spiricom/Electrosteel_embedded/README.md

# Electrosteel_embedded
repository for embedded firmware and EAGLE design files for the Electrosteel
