spiricom/Electrosteel_embedded/EAGLE_files/electrosteel_2020/electrosteel_knobpanel/electrosteel2021_synthboards1_BOM.xlsx

electrosteel2021_synthboards1_GenericPartsOrder
Mfg Part Num | Mfg Name | VID | Vendor Part Num | Description | Pkg Code | Qty-1 | Qty-5 | Qty-25 | Part References | Value
77313-101-30LF | Amphenol | DK | 609-77313-101-30LF-ND | CONN HEADER VERT 30POS 2.54MM | TH | 3 | 15 | 75 | JP9, JP10, JP11
FBMH1608HM470-TV | Taiyo Yuden | DK | 587-3824-2-ND | FERRITE BEAD 47 OHM 0603 1LN | 603 | 2 | 10 | 50 | L1, L2
L79L12ACZ-TR | ST | DK | 497-7302-2-ND | IC REG LINEAR -12V 100MA TO92-3 | TO92-3 | 1 | 5 | 25 | IC6
LM78L12ACZ/LFT7 | TI | DK | 296-LM78L12ACZ/LFT7TR-ND | IC REG LINEAR 12V 100MA TO92-3 | TO92-3 | 1 | 5 | 25 | IC5
CC0603KRX7R8BB104 | Yageo | DK | 311-1341-1-ND | CAP CER 0.1UF 25V 10% X7R 0603 | 603 | 15 | 75 | 375 | C1, C2, C5, C6, C7, C8, C9, C10, C11, C12, C13, C18, C19, C23, C164 | .1uf
CC0603KRX7R8BB103 | Yageo | DK | 311-1360-1-ND | CAP CER 10000PF 25V 10% X7R 0603 | 603 | 20 | 100 | 500 | C3, C4, C14, C15, C16, C17, C20, C21, C22, C24, C25, C26, C27, C51, C52, C53, C54, C119, C120, C121 | .01uf
RCS06030000Z0EA | Vishay | DK | 541-2779-1-ND | RES SMD 0 OHM JUMPER 1/4W 0603 | 603 | 4 | 20 | 100 | R4, R110, R111, R185 | 0R
ESR03EZPF1001 | Rohm | DK | RHM1.00KADCT-ND | RES 1K OHM 1/4W 1% 0603 SMD | 603 | 2 | 10 | 50 | R125, R134 | 1k
C3216X7R1E105K085AA | TDK | DK | 445-1592-1-ND | CAP CER 1UF 25V 10% X7R 1206 | 1206 | 1 | 5 | 25 | C162 | 1uf
*DNP | DO NOT PLACE | (N/A) | DO NOT PLACE | DO NOT PLACE | * | 2 | 10 | 50 | R1, R2 | 2.2k-DNP
CRCW06034K70FKEAHP | Vishay Dale | DK | 541-4.70KSCT-ND | RES 4.70K OHM .25W 1% 0603 SMD | 603 | 1 | 5 | 25 | R128 | 4.7k
*DNP | DO NOT PLACE | (N/A) | DO NOT PLACE | DO NOT PLACE | * | 5 | 25 | 125 | J1, J2, J3, J4, J36 | 4P-2.0
RC0603JR-075R1L | Yageo | DK | 311-5.1GRCT-ND | RES SMD 5.1 OHM 5% 1/10W 0603 | 603 | 1 | 5 | 25 | R3 | 5R
ERJ-3EKF7151V | Panasonic | DK | P7.15KHTR-ND | RES SMD 7.15K OHM 1% 1/10W 0603 | 603 | 2 | 10 | 50 | R5, R35 | 7.15k
*DNP | DO NOT PLACE | (N/A) | DO NOT PLACE | DO NOT PLACE | * | 8 | 40 | 200 | VR1, VR2, VR3, VR4, VR5, VR6, VR7, VR8 | 10k
ESR03EZPF1002 | Rohm | DK | RHM10KADCT-ND | RES 10K OHM 1/4W 1% 0603 SMD | 603 | 8 | 40 | 200 | R33, R34, R37, R38, R159, R160, R161, R162 | 10k
TAJB106K025RNJ | AVX | DK | 478-5257-1-ND | 10µF ±10% Molded Tantalum Capacitors 25V | 1210 | 1 | 5 | 25 | C44 | 10uf
CC0603JRNPO9BN220 | Yageo | DK | 311-1062-1-ND | CAP CER 22PF 50V 5% NPO 0603 | 603 | 1 | 5 | 25 | C28 | 22pf
EEE-1CA220NP | Panasonic | DK | PCE4306CT-ND | CAP ALUM 22UF 20% 16V SMD Bipolar | PANASONIC_C | 1 | 5 | 25 | C158 | 22uf
RC0603JR-0739RL | Yageo | DK | 311-39GRCT-ND | RES SMD 39 OHM 5% 1/10W 0603 | 603 | 3 | 15 | 75 | R112, R208, R209 | 39R
ESR03EZPJ473 | Rohm | DK | RHM47KDCT-ND | RES 47K OHM 1/4W 5% 0603 SMD | 603 | 1 | 5 | 25 | R11 | 47k
ESR03EZPF5600 | Rohm | DK | RHM560ADCT-ND | RES 560 OHM 1/4W 1% 0603 SMD | 603 | 2 | 10 | 50 | R10, R129 | 560R
D2516-6002-AR | 3M | DK | MHC16E-ND | CONN HEADER VERT 16POS 2.54MM | TH | 1 | 5 | 25 | X7 | -2516
N2520-6003-UG | 3M | DK | N2520-6003-UG-ND | CONN HEADER VERT 20POS 2.54MM | TH | 1 | 5 | 25 | X6 | -2520
PRT-08032 | Generic | Sparkfun | PRT-08032 | Audio Jack 3.5mm stereo | TH | 3 | 15 | 75 | FB_IN, MONO_OUT, STEREO_OUT | AUDIO_JACK_3.5MM_KIT
DPU01M-15 | MeanWell | DK | 1866-1412-ND | DC DC CONVERTER +/-15V 1W | 7-SIP | 1 | 5 | 25 | U$3 | CMR0512S3C
HSMM-A101-R00J1 | Broadcom | DK | 516-2124-1-ND | LED GREEN CLEAR 2PLCC SMD | 2PLCC | 1 | 5 | 25 | LED5 | GREEN
MAX11617EEE+ | Maxim | MO | 700-MAX11617EEE | Analog to Digital Converters - ADC 2.7V to 3.6V and 4.5V to 5.5V Low-Power 4-/8-/12-Channel 2-Wire Serial 12-Bit ADCs | QSOP-16 | 1 | 5 | 25 | U1 | MAX11615EEE+
TL1105SPF160Q | E-Switch | DK | EG1861-ND | SWITCH TACTILE SPST-NO 0.05A 12V | TH | 2 | 10 | 50 | S1, S2 | MOMENTARY-SWITCH-SPST-PTH-6.0MM
OPA1664AIPWR | TI | DK | 296-40431-2-ND | IC AUDIO 4 CIRCUIT 14TSSOP | 14TSSOP | 1 | 5 | 25 | IC1 | OPA4344E
*DNP | DO NOT PLACE | (N/A) | DO NOT PLACE | DO NOT PLACE | * | 18 | 90 | 450 | +12VA, +15VA, -12VA, -15VA, 3V3A_0A, 3V3A_0B, 3V3A_0C, 5V/1, 5V/1_2, 5V/2, 5V/2_2, 5V/3, DGND1, DGND2, DGND5, MONO_OUT_DC, VREGGND, VREGIN | PINHD-1X1
*DNP | DO NOT PLACE | (N/A) | DO NOT PLACE | DO NOT PLACE | * | 6 | 30 | 150 | JP14, JP22, JP23, JP24, JP25, JP26 | PINHD-1X2
*DNP | DO NOT PLACE | (N/A) | DO NOT PLACE | DO NOT PLACE | * | 1 | 5 | 25 | JP27 | PINHD-1X3
*DNP | DO NOT PLACE | (N/A) | DO NOT PLACE | DO NOT PLACE | * | 11 | 55 | 275 | JP1, JP2, JP12, JP13, JP15, JP16, JP17, JP18, JP19, JP20, JP21 | PINHD-1X4
77313-101-08LF | Amphenol | DK | 609-5693-ND | CONN HEADER VERT 8POS 2.54MM | TH | 3 | 15 | 75 | JP3, JP4, JP5 | PINHD-2X4
77313-101-20LF | Amphenol | DK | 609-5697-ND | CONN HEADER VERT 20POS 2.54MM | TH | 3 | 15 | 75 | JP6, JP7, JP8 | PINHD-2X10
R-78E5.0-1.0 | Recom | DK | 945-2201-ND | 5V Switching Regulator | TH | 3 | 15 | 75 | U2, U15, U17 | R-78E5.0-1.0
HSMZ-A100-R00J1 | Broadcom | DK | 516-1459-1-ND | LED RED CLEAR 2PLCC SMD | 2PLCC | 1 | 5 | 25 | LED6 | RED
TCA9548APWR | Texas Instruments | DK | 296-34905-1-ND | IC I2C SW 8CH W/RESET 24TSSOP | 24TSSOP | 1 | 5 | 25 | U20 | TCA9548APWR
