spiricom/Electrosteel_embedded/PSOC5_electrosteel_stringsensors_newpcb_brain/CE210514_PSOC3_5_Thermistor.cydsn/ComponentUpdateLog.txt

Last Modified Date & Time: 07/15/2018 13:28:18

CE210514_PSOC3_5_Thermistor: CE210514_PSOC3_5_Thermistor.cydwr
	cy_boot [v5.20] to [v5.70]
	Em_EEPROM_Dynamic [v2.0] to [v2.10]
	LIN_Dynamic [v3.20] to [v4.0]

CE210514_PSOC3_5_Thermistor: TopDesign.cysch
	ADC [v3.20] to [v3.30]
	LCD [v2.10] to [v2.20]
	TX [v2.10] to [v2.20]
	Vhi [v2.10] to [v2.20]
	Vlow [v2.10] to [v2.20]
	Vtherm [v2.10] to [v2.20]

Last Modified Date & Time: 02/27/2021 19:00:18

CE210514_PSOC3_5_Thermistor: CE210514_PSOC3_5_Thermistor.cydwr
	cy_boot [v5.70] to [v6.10]
	Em_EEPROM_Dynamic [v2.10] to [v2.20]
	LIN_Dynamic [v4.0] to [v5.0]

CE210514_PSOC3_5_Thermistor: TopDesign.cysch
	isr_SPI1_DMA [v1.70] to [v1.71]
	isr_SPI2_DMA [v1.70] to [v1.71]
	isr_SPI2_ss [v1.70] to [v1.71]
	my_Vbus_ISR [v1.70] to [v1.71]
	Sleep_isr [v1.70] to [v1.71]

Last Modified Date & Time: 04/28/2023 11:42:35

CE210514_PSOC3_5_Thermistor: CE210514_PSOC3_5_Thermistor.cydwr
	LIN_Dynamic [v5.0] to [v6.0]
