spiricom/Electrosteel_embedded/EAGLE_files/electrosteel_2020/electrosteel2020_10_arrange6_newstringconnector_2 (v9~recovered).dxf

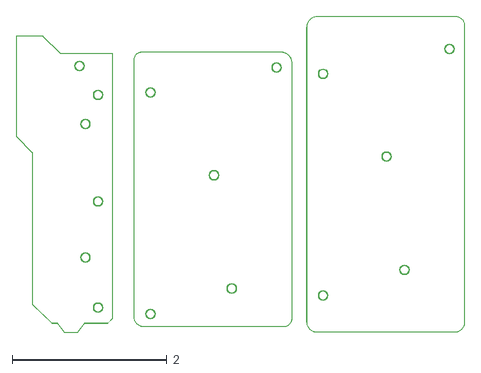
[picture p1: CAD file, 2023-07-19]
EAGLE_files/electrosteel_2020/electrosteel2020_10_arrange6_newstringconnector_2 (v9~recovered).dxf
5.79 x 4.09
