spiricom/Electrosteel_embedded/EAGLE_files/electrosteel_2020/electrosteel_6board_synth/EAGLE/electrosteel2020_10_arrange6_synthboardsonlyrev6.dxf

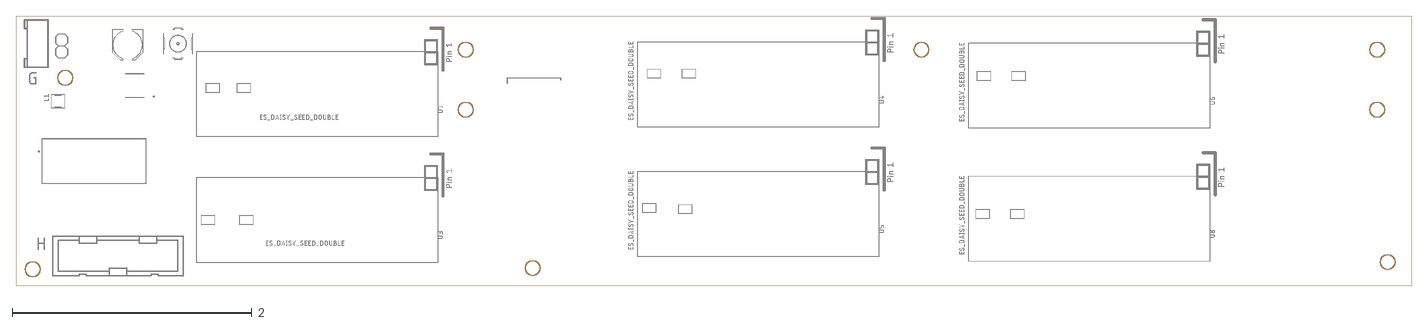
[picture p2: CAD file, 2023-10-17]
EAGLE_files/electrosteel_2020/electrosteel_6board_synth/EAGLE/electrosteel2020_10_arrange6_synthboardsonlyrev6.dxf
11.6 x 2.25
