spiricom/Electrosteel_embedded/EAGLE_files/electrosteel_2020/electrosteel_sensor/electrosteel_fretboard_sensor1_panel.dxf

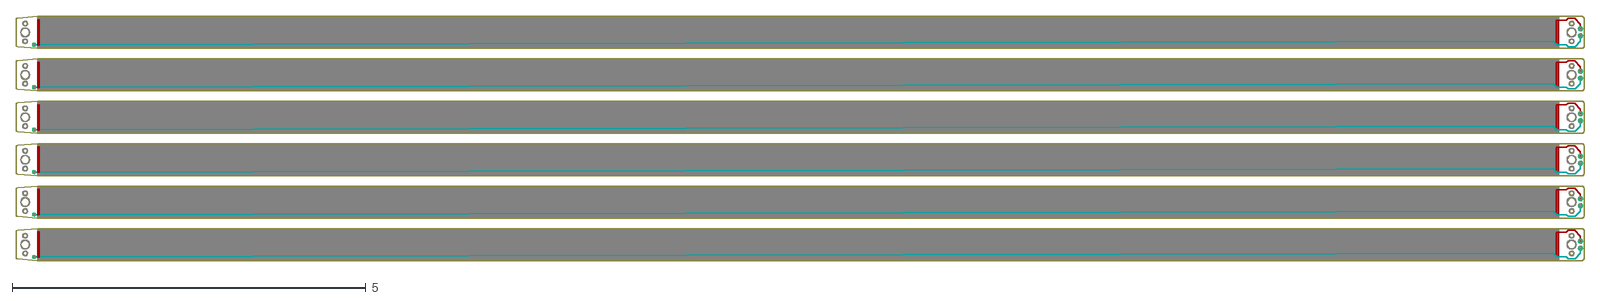
[picture p3: CAD file, 2022-12-08]
EAGLE_files/electrosteel_2020/electrosteel_sensor/electrosteel_fretboard_sensor1_panel.dxf
22.2 x 3.45
