spiricom/Electrosteel_embedded/EAGLE_files/electrosteel_2020/electrosteel2020_10_arrange6_synthboardsonly3.dxf

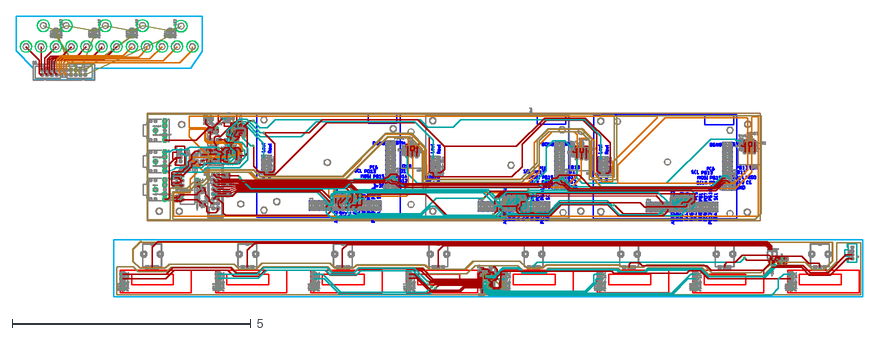
[picture p4: CAD file, 2022-12-08]
EAGLE_files/electrosteel_2020/electrosteel2020_10_arrange6_synthboardsonly3.dxf
17.8 x 5.89
