spiricom/Electrosteel_embedded/EAGLE_files/cam/NIRL/Admin Project/CAMOutputs/Assembly/PnP_electrosteel2020_10_arrange6_newstringconnector_2 v9_back.txt

C1	85.09	15.49	180.00	2.2uf	C1206
C2	87.63	9.14	90.00	2.2uf	C1206
C3	132.84	58.67	0.00	2.2uf	C1206
C4	143.00	58.93	180.00	2.2uf	C1206
U1	81.18	8.48	270.00	MC78M09BDTRKGDPAK-3_ONS-M	DPAK-3_ONS-M
U2	138.84	51.47	180.00	MC78M09BDTRKGDPAK-3_ONS-M	DPAK-3_ONS-M
