spiricom/Electrosteel_embedded/PSOC5_electrosteel_stringsensors_newpcb_brain/CE210514_PSOC3_5_Thermistor.cydsn/ARM_GCC_541/Debug/LINK_options.txt

-Wl,--start-group -o "C:\\Users\\ggg88\\dev\\Electrosteel_embedded\\PSOC5_electrosteel_stringsensors_newpcb_brain\\CE210514_PSOC3_5_Thermistor.cydsn\\ARM_GCC_541\\Debug\\CE210514_PSOC3_5_Thermistor.elf" ".\\ARM_GCC_541\\Debug\\main.o" ".\\ARM_GCC_541\\Debug\\measurement.o" ".\\ARM_GCC_541\\Debug\\removeOffsetNoise.o" ".\\ARM_GCC_541\\Debug\\gfx.o" ".\\ARM_GCC_541\\Debug\\gfx_font.o" ".\\ARM_GCC_541\\Debug\\oled.o" ".\\ARM_GCC_541\\Debug\\ssd1306.o" ".\\ARM_GCC_541\\Debug\\ui.o" ".\\ARM_GCC_541\\Debug\\cyfitter_cfg.o" ".\\ARM_GCC_541\\Debug\\cymetadata.o" ".\\ARM_GCC_541\\Debug\\Cm3Start.o" ".\\ARM_GCC_541\\Debug\\CE210514_PSOC3_5_Thermistor.a" "C:\\Program\ Files\ (x86)\\Cypress\\PSoC\ Creator\\4.4\\PSoC\ Creator\\psoc\\content\\cycomponentlibrary\\CyComponentLibrary.cylib\\CortexM3\\ARM_GCC_541\\Debug\\CyComponentLibrary.a" -mcpu=cortex-m3 -mthumb -l m -L "Generated_Source\\PSoC5" "-Wl,-Map,.\\ARM_GCC_541\\Debug/CE210514_PSOC3_5_Thermistor.map" -T "Generated_Source\\PSoC5\\cm3gcc.ld" -specs=nano.specs -Wl,--gc-sections -u_printf_float -g -ffunction-sections -O0 -ffat-lto-objects -Wl,--end-group
