spiricom/Electrosteel_embedded/PSOC5_electrosteel_stringsensors_newpcb_brain/CE210514_PSOC3_5_Thermistor.cydsn/bootloader_electrosteel_PSOC.cydsn/CortexM3/ARM_GCC_541/Debug/LINK_options.txt

-Wl,--start-group -o "C:\\Users\\JeffSnyder\\dev\\Electrosteel_embedded\\PSOC5_electrosteel_stringsensors_newpcb_brain\\CE210514_PSOC3_5_Thermistor.cydsn\\bootloader_electrosteel_PSOC.cydsn\\CortexM3\\ARM_GCC_541\\Debug\\bootloader_electrosteel_PSOC.elf" ".\\CortexM3\\ARM_GCC_541\\Debug\\main.o" ".\\CortexM3\\ARM_GCC_541\\Debug\\cyfitter_cfg.o" ".\\CortexM3\\ARM_GCC_541\\Debug\\cymetadata.o" ".\\CortexM3\\ARM_GCC_541\\Debug\\Cm3Start.o" ".\\CortexM3\\ARM_GCC_541\\Debug\\bootloader_electrosteel_PSOC.a" "C:\\Program\ Files\ (x86)\\Cypress\\PSoC\ Creator\\4.4\\PSoC\ Creator\\psoc\\content\\cycomponentlibrary\\CyComponentLibrary.cylib\\CortexM3\\ARM_GCC_541\\Debug\\CyComponentLibrary.a" -mcpu=cortex-m3 -mthumb -L "Generated_Source\\PSoC5" "-Wl,-Map,.\\CortexM3\\ARM_GCC_541\\Debug/bootloader_electrosteel_PSOC.map" -T "Generated_Source\\PSoC5\\cm3gcc.ld" -specs=nano.specs -Wl,--gc-sections -g -ffunction-sections -Og -ffat-lto-objects -Wl,--end-group
