spiricom/Electrosteel_embedded/EAGLE_files/electrosteel_2020/electrosteel2020_10_arrange6_synthboardsonly4.pdf

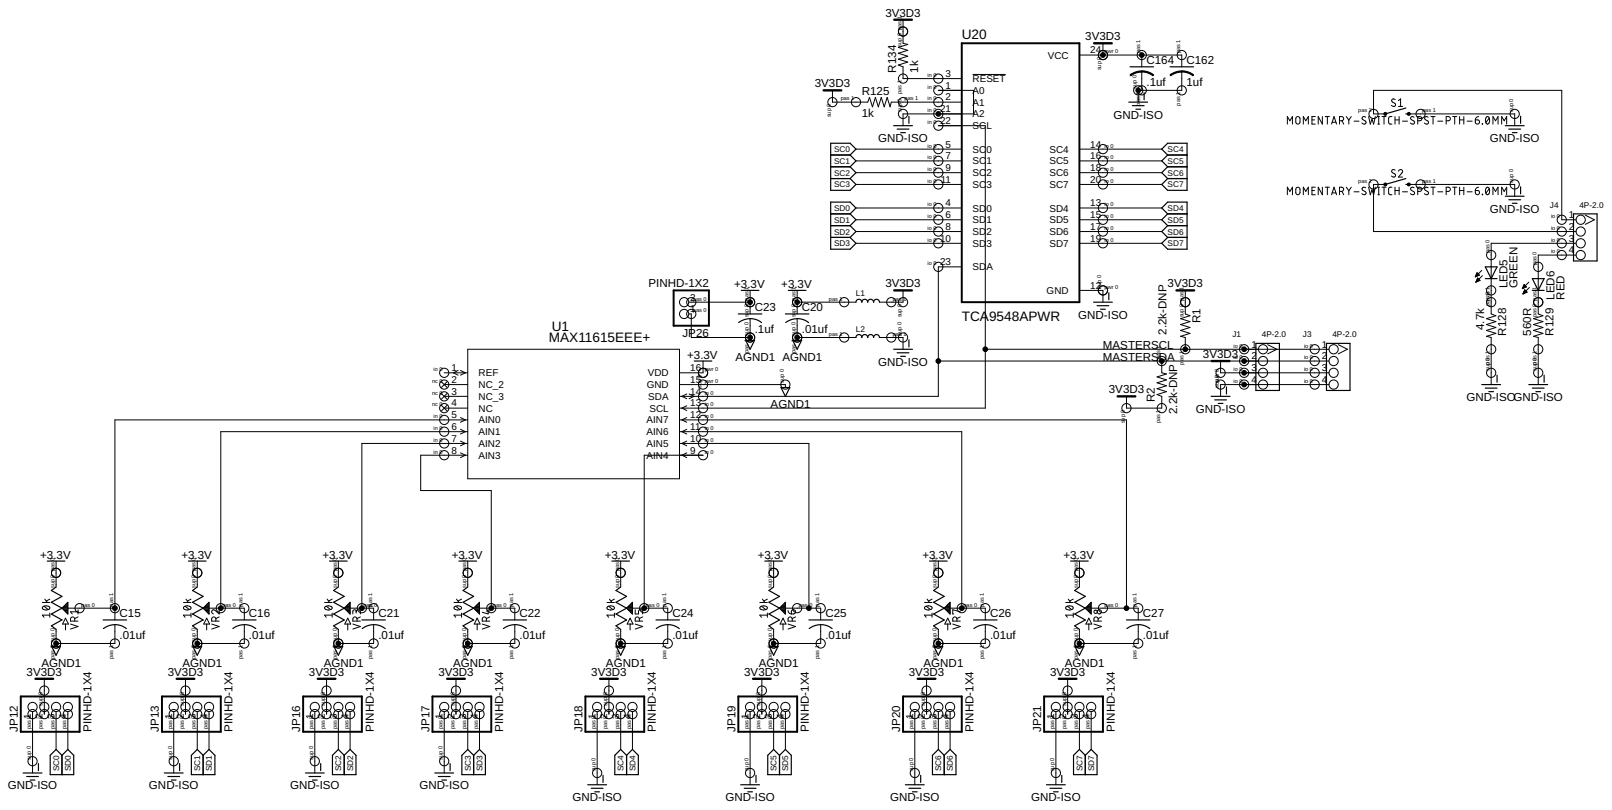
[picture p5: page 1]

pas 0 pas 0 pas 1 pas 1

in 0 | 11 AIN7 10 AIN6 in 0

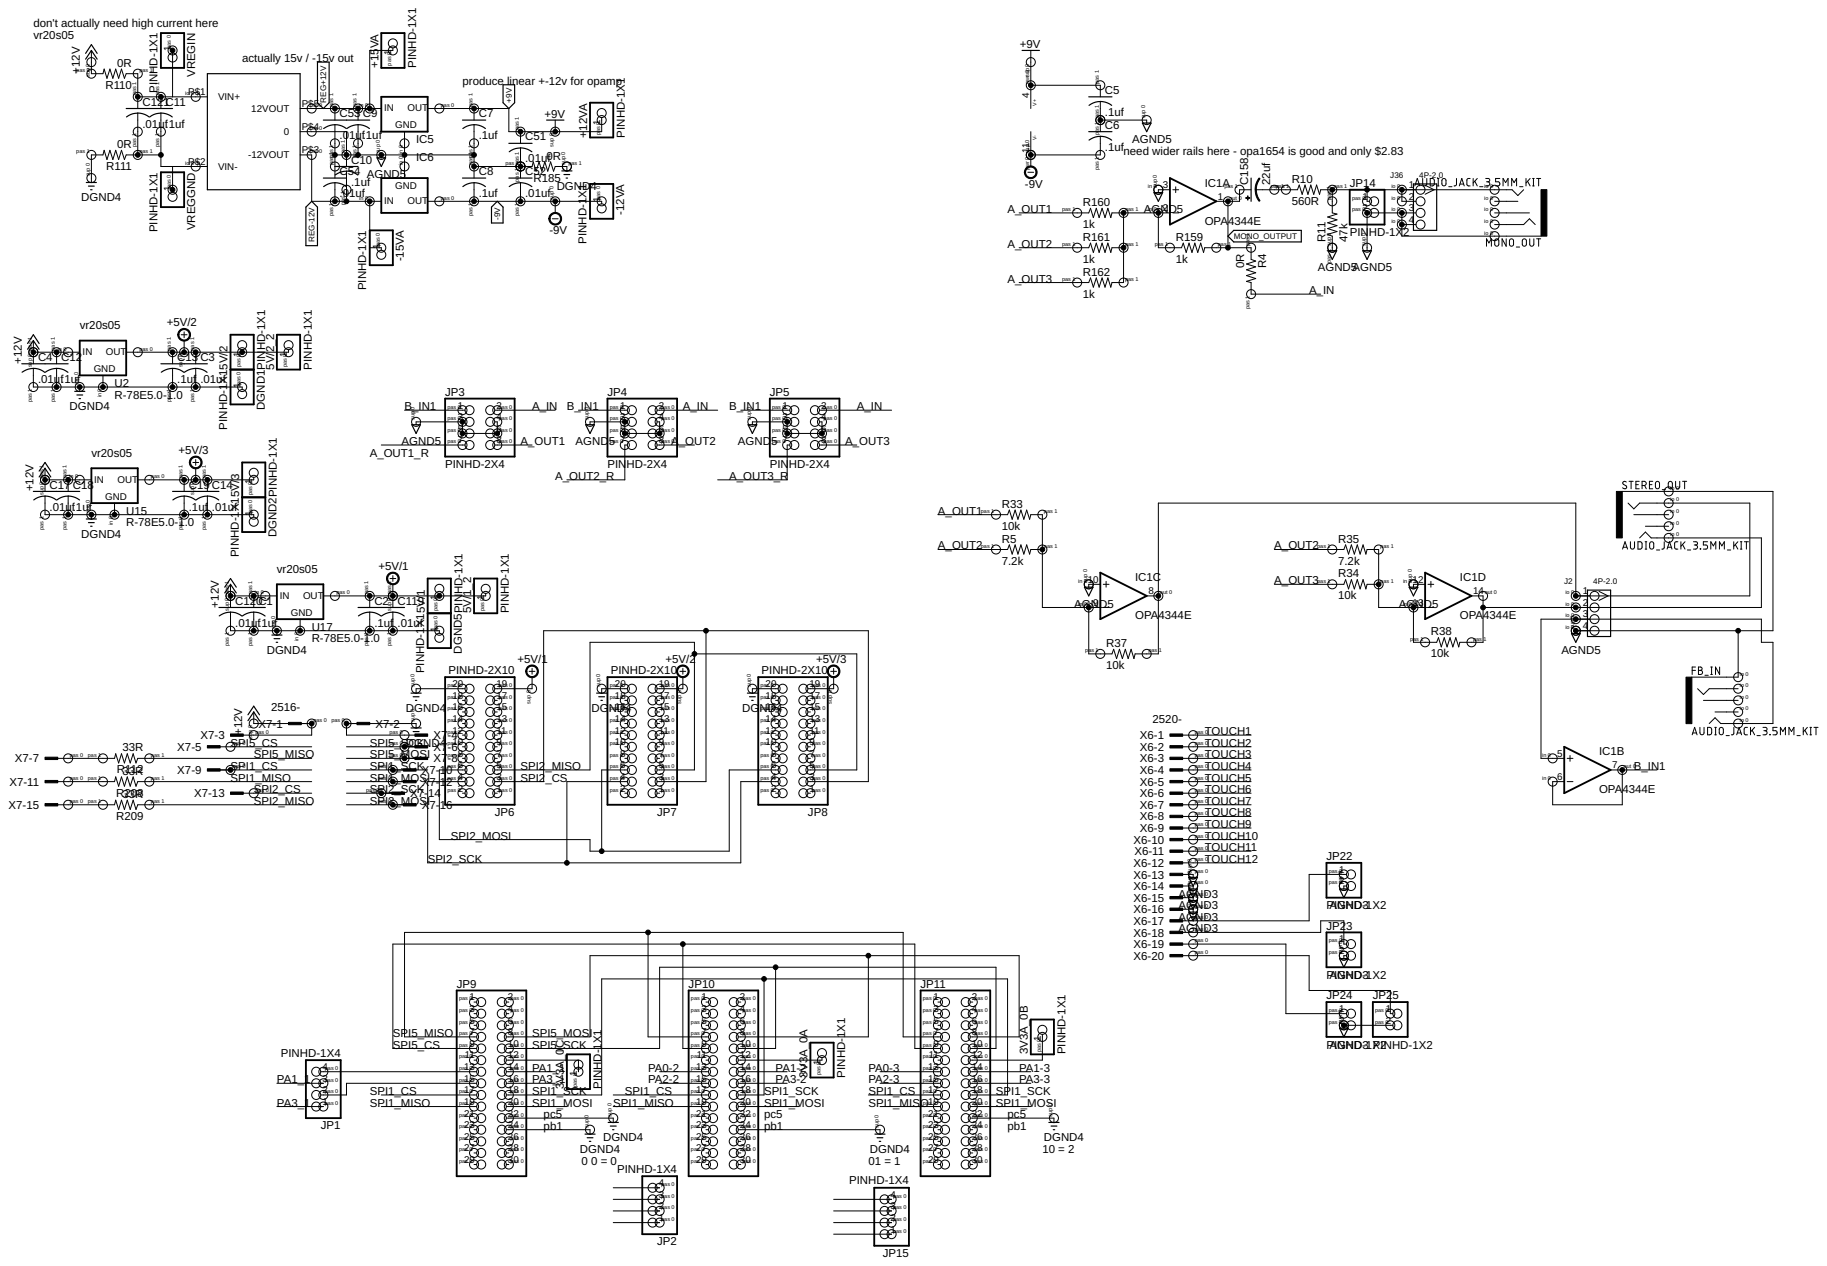
[picture p6: page 2]

don't actually need high current here

produce linear +-12v for opamp

pas 1 pas 1

3 io 0
