spiricom/Electrosteel_embedded/EAGLE_files/electrosteel_2020/electrosteel_6board_synth/EAGLE/electrosteel2020_10_arrange7_synthboardsonlyrev6.brd

## EAGLE design EAGLE_files/electrosteel_2020/electrosteel_6board_synth/EAGLE/electrosteel2020_10_arrange7_synthboardsonlyrev6.brd (2024-01-14)

Schematic: electrosteel2020_10_arrange7_synthboardsonlyrev6.sch, sheet 1

Parts:
C15, C30: .1uf; C0603K; PARTNO CC0603KRX7R8BB104
C16: 22uf; PANASONIC_D; PARTNO EEE-1CA220NP
C20: 22pf; C0603; PARTNO CC0603JRNPO9BN220
C21, C22, C23, C24, C25, C26, C27, C29, C31, C32: 10uf; C1206K; PARTNO TMK316F106ZL-T
J1: 4P-2.0; HW4-2.0; PARTNO 110990030
J2: 105162-0001; PARTNO 105162-0001
JP12: PINHD-1X2; 1X02; PARTNO *DNP
L1: 2.2uH; BOURNS_SRP2010; PARTNO SRP2010-2R2M
PS1: UWE1215S-3WR3; CONV_UWE1215S-3WR3; PARTNO UWE1215S-3WR3
R1, R2, R8, R13, R16, R19, R22: 10k; R0603; PARTNO ESR03EZPF1002
R3: 560R; R0603; PARTNO ESR03EZPF5600
R5, R93, R94, R95, R96, R97: 47k; R0603; PARTNO ESR03EZPJ473
R6, R7, R9, R12, R14, R15, R17, R18, R20, R21, R23, R56: 2M; R0603; PARTNO RMCF0603FT2M00
R24, R25: 2k; R0603; PARTNO ERJ-PA3F2001V
R27, R29, R30, R31, R32, R33, R34: 47R; R0603; PARTNO RC0603JR-0747RL
S1: 10-XX; B3F-10XX
U1: OPA1611AID; SOIC127P599X175-8N; PARTNO OPA1611AID
U2, U3, U4, U5, U6, U7, U8, U9, U10, U11: ES_DAISY_SEED_DOUBLE; PARTNO 4840-6004-CP
X1: 2516-; PAK100/2500-16; PARTNO SBH11-PBPC-D08-ST-BK

Connections:
+3V3: J2.4 (VDD), R24.1, R25.1, R93.2, R94.2, R95.2, R96.2, R97.2, U7.38 (+3V3_D), U7.B38 (+3V3_D)
+12V: C24.1, L1.P$1, U2.39 (V_IN), U2.B39 (V_IN), U3.39 (V_IN), U3.B39 (V_IN), U4.39 (V_IN), U4.B39 (V_IN), U5.39 (V_IN), U5.B39 (V_IN), U6.39 (V_IN), U6.B39 (V_IN), U7.39 (V_IN), U7.B39 (V_IN), U8.39 (V_IN), U8.B39 (V_IN), U9.39 (V_IN), U9.B39 (V_IN), U10.39 (V_IN), U10.B39 (V_IN), U11.39 (V_IN), U11.B39 (V_IN), X1.1, X1.3
+15V: C30.1, C32.1, PS1.6 (+VO), R6.2, R9.2, R14.2, R17.2, R20.2, R23.2, U1.7 (V+)
-15V: C15.2, C23.2, PS1.8 (-VO), R7.1, R12.1, R15.1, R18.1, R21.1, R56.1, U1.4 (V-)
CLK: J2.5 (CLK), R32.2
CMD: J2.3 (CMD), R31.2
DAT0: J2.7 (DAT0), R33.2
DAT1: J2.8 (DAT1), R34.2
DAT2: J2.1 (DAT2), R29.2
DAT3: J2.2 (CD/DAT3), R30.2
DGND4: C22.2, C24.2, J2.6 (VSS), J2.10 (GND_1), J2.11 (GND_2), J2.12 (GND_3), J2.13 (GND_4), PS1.1 (GND), S1.3, S1.4 (P1), U2.20 (AGND), U2.35 (GPIO28(ADC11)), U2.37 (GPIO30(USB_HS_D+)), U2.40 (GND), U2.B20 (AGND), U2.B35 (GPIO28(ADC11)), U2.B37 (GPIO30(USB_HS_D+)), U2.B40 (GND), U3.20 (AGND), U3.36 (GPIO29(USB_HS_D_-)), U3.37 (GPIO30(USB_HS_D+)), U3.40 (GND), U3.B20 (AGND), U3.B36 (GPIO29(USB_HS_D_-)), U3.B37 (GPIO30(USB_HS_D+)), U3.B40 (GND), U4.20 (AGND), U4.35 (GPIO28(ADC11)), U4.37 (GPIO30(USB_HS_D+)), U4.40 (GND), U4.B20 (AGND), U4.B35 (GPIO28(ADC11)), U4.B37 (GPIO30(USB_HS_D+)), U4.B40 (GND), U5.20 (AGND), U5.37 (GPIO30(USB_HS_D+)), U5.40 (GND), U5.B20 (AGND), U5.B37 (GPIO30(USB_HS_D+)), U5.B40 (GND), U6.20 (AGND), U6.35 (GPIO28(ADC11)), U6.36 (GPIO29(USB_HS_D_-)), U6.40 (GND), U6.B20 (AGND), U6.B35 (GPIO28(ADC11)), U6.B36 (GPIO29(USB_HS_D_-)), U6.B40 (GND), U7.20 (AGND), U7.35 (GPIO28(ADC11)), U7.36 (GPIO29(USB_HS_D_-)), U7.37 (GPIO30(USB_HS_D+)), U7.40 (GND), U7.B20 (AGND), U7.B35 (GPIO28(ADC11)), U7.B36 (GPIO29(USB_HS_D_-)), U7.B37 (GPIO30(USB_HS_D+)), U7.B40 (GND), U8.20 (AGND), U8.36 (GPIO29(USB_HS_D_-)), U8.40 (GND), U8.B20 (AGND), U8.B36 (GPIO29(USB_HS_D_-)), U8.B40 (GND), U9.20 (AGND), U9.37 (GPIO30(USB_HS_D+)), U9.40 (GND), U9.B20 (AGND), U9.B37 (GPIO30(USB_HS_D+)), U9.B40 (GND), U10.20 (AGND), U10.35 (GPIO28(ADC11)), U10.36 (GPIO29(USB_HS_D_-)), U10.40 (GND), U10.B20 (AGND), U10.B35 (GPIO28(ADC11)), U10.B36 (GPIO29(USB_HS_D_-)), U10.B40 (GND), U11.20 (AGND), U11.36 (GPIO29(USB_HS_D_-)), U11.40 (GND), U11.B20 (AGND), U11.B36 (GPIO29(USB_HS_D_-)), U11.B40 (GND), X1.2, X1.4
GNDINT: C15.1, C23.1, C30.2, C32.2, J1.3, J1.4, JP12.2, PS1.7 (0V), R5.1, U1.3 (+IN)
I2C_SCL: R24.2, U2.12 (GPIO11(I2C1_SCL)), U2.B12 (GPIO11(I2C1_SCL)), U3.12 (GPIO11(I2C1_SCL)), U3.B12 (GPIO11(I2C1_SCL)), U4.12 (GPIO11(I2C1_SCL)), U4.B12 (GPIO11(I2C1_SCL)), U5.12 (GPIO11(I2C1_SCL)), U5.B12 (GPIO11(I2C1_SCL)), U6.12 (GPIO11(I2C1_SCL)), U6.B12 (GPIO11(I2C1_SCL)), U7.12 (GPIO11(I2C1_SCL)), U7.B12 (GPIO11(I2C1_SCL)), U8.12 (GPIO11(I2C1_SCL)), U8.B12 (GPIO11(I2C1_SCL)), U9.12 (GPIO11(I2C1_SCL)), U9.B12 (GPIO11(I2C1_SCL)), U10.12 (GPIO11(I2C1_SCL)), U10.B12 (GPIO11(I2C1_SCL)), U11.12 (GPIO11(I2C1_SCL)), U11.B12 (GPIO11(I2C1_SCL))
I2C_SDA: R25.2, U2.13 (GPIO12(I2C1_SDA)), U2.B13 (GPIO12(I2C1_SDA)), U3.13 (GPIO12(I2C1_SDA)), U3.B13 (GPIO12(I2C1_SDA)), U4.13 (GPIO12(I2C1_SDA)), U4.B13 (GPIO12(I2C1_SDA)), U5.13 (GPIO12(I2C1_SDA)), U5.B13 (GPIO12(I2C1_SDA)), U6.13 (GPIO12(I2C1_SDA)), U6.B13 (GPIO12(I2C1_SDA)), U7.13 (GPIO12(I2C1_SDA)), U7.B13 (GPIO12(I2C1_SDA)), U8.13 (GPIO12(I2C1_SDA)), U8.B13 (GPIO12(I2C1_SDA)), U9.13 (GPIO12(I2C1_SDA)), U9.B13 (GPIO12(I2C1_SDA)), U10.13 (GPIO12(I2C1_SDA)), U10.B13 (GPIO12(I2C1_SDA)), U11.13 (GPIO12(I2C1_SDA)), U11.B13 (GPIO12(I2C1_SDA))
MASTER_SIGNAL: U2.1 (GPIO0(USB_HS_ID)), U2.B1 (GPIO0(USB_HS_ID)), U3.1 (GPIO0(USB_HS_ID)), U3.B1 (GPIO0(USB_HS_ID)), U4.1 (GPIO0(USB_HS_ID)), U4.B1 (GPIO0(USB_HS_ID)), U5.1 (GPIO0(USB_HS_ID)), U5.B1 (GPIO0(USB_HS_ID)), U6.1 (GPIO0(USB_HS_ID)), U6.B1 (GPIO0(USB_HS_ID)), U7.1 (GPIO0(USB_HS_ID)), U7.B1 (GPIO0(USB_HS_ID)), U8.1 (GPIO0(USB_HS_ID)), U8.B1 (GPIO0(USB_HS_ID)), U9.1 (GPIO0(USB_HS_ID)), U9.B1 (GPIO0(USB_HS_ID)), U10.1 (GPIO0(USB_HS_ID)), U10.B1 (GPIO0(USB_HS_ID)), U11.1 (GPIO0(USB_HS_ID)), U11.B1 (GPIO0(USB_HS_ID))
MISO_2: R27.1, U7.10 (GPIO9(SPI1_MISO)), U7.B10 (GPIO9(SPI1_MISO))
MISO_2_P1: U3.10 (GPIO9(SPI1_MISO)), U3.B10 (GPIO9(SPI1_MISO))
MISO_2_P2: U4.10 (GPIO9(SPI1_MISO)), U4.B10 (GPIO9(SPI1_MISO))
MISO_2_P3: U5.10 (GPIO9(SPI1_MISO)), U5.B10 (GPIO9(SPI1_MISO))
MISO_2_P4: U6.10 (GPIO9(SPI1_MISO)), U6.B10 (GPIO9(SPI1_MISO))
MISO_2_P5: U8.10 (GPIO9(SPI1_MISO)), U8.B10 (GPIO9(SPI1_MISO))
MISO_2_P6: U2.10 (GPIO9(SPI1_MISO)), U2.B10 (GPIO9(SPI1_MISO))
MISO_2_P7: U9.10 (GPIO9(SPI1_MISO)), U9.B10 (GPIO9(SPI1_MISO))
MISO_2_P8: U10.10 (GPIO9(SPI1_MISO)), U10.B10 (GPIO9(SPI1_MISO))
MISO_2_P9: U11.10 (GPIO9(SPI1_MISO)), U11.B10 (GPIO9(SPI1_MISO))
MONO_OUTPUT: C16.+, C20.2, R2.2, U1.6 (OUT)
MOSI_2: U2.11 (GPIO10(SPI1_MOSI)), U2.B11 (GPIO10(SPI1_MOSI)), U3.11 (GPIO10(SPI1_MOSI)), U3.B11 (GPIO10(SPI1_MOSI)), U4.11 (GPIO10(SPI1_MOSI)), U4.B11 (GPIO10(SPI1_MOSI)), U5.11 (GPIO10(SPI1_MOSI)), U5.B11 (GPIO10(SPI1_MOSI)), U6.11 (GPIO10(SPI1_MOSI)), U6.B11 (GPIO10(SPI1_MOSI)), U7.11 (GPIO10(SPI1_MOSI)), U7.B11 (GPIO10(SPI1_MOSI)), U8.11 (GPIO10(SPI1_MOSI)), U8.B11 (GPIO10(SPI1_MOSI)), U9.11 (GPIO10(SPI1_MOSI)), U9.B11 (GPIO10(SPI1_MOSI)), U10.11 (GPIO10(SPI1_MOSI)), U10.B11 (GPIO10(SPI1_MOSI)), U11.11 (GPIO10(SPI1_MOSI)), U11.B11 (GPIO10(SPI1_MOSI)), X1.12
unnamed: U5.31 (GPIO24(ADC9)), U5.B31 (GPIO24(ADC9))
unnamed: C21.2, R6.1, R7.2, R8.1
unnamed: U6.31 (GPIO24(ADC9)), U6.B31 (GPIO24(ADC9))
unnamed: C20.1, R1.2, R2.1, R8.2, R13.2, R16.2, R19.2, R22.2, U1.2 (-IN)
unnamed: C16.-, R3.1
unnamed: J1.1, J1.2, JP12.1, R3.2, R5.2
unnamed: C25.2, R1.1, R23.1, R56.2
unnamed: C26.2, R9.1, R12.2, R13.1
unnamed: C27.2, R14.1, R15.2, R16.1
unnamed: C29.2, R17.1, R18.2, R19.1
unnamed: C31.2, R20.1, R21.2, R22.1
unnamed: U7.19 (AUDIO_OUT_R), U7.B19 (AUDIO_OUT_R)
unnamed: U7.17 (AUDIO_IN_R), U7.B17 (AUDIO_IN_R)
unnamed: U7.16 (AUDIO_IN_L), U7.B16 (AUDIO_IN_L)
unnamed: U7.15 (GPIO14(USART1_RX)), U7.B15 (GPIO14(USART1_RX))
unnamed: U2.21 (+3V3_A), U2.B21 (+3V3_A)
unnamed: U8.31 (GPIO24(ADC9)), U8.B31 (GPIO24(ADC9))
unnamed: U8.26 (GPIO19(ADC4)), U8.B26 (GPIO19(ADC4))
unnamed: U6.26 (GPIO19(ADC4)), U6.B26 (GPIO19(ADC4))
unnamed: U7.34 (GPIO27(SAI2_FS_B)), U7.B34 (GPIO27(SAI2_FS_B))
unnamed: U7.33 (GPIO26(SAI2_SD_A)), U7.B33 (GPIO26(SAI2_SD_A))
unnamed: U7.32 (GPIO25(ADC10)), U7.B32 (GPIO25(ADC10))
unnamed: U5.26 (GPIO19(ADC4)), U5.B26 (GPIO19(ADC4))
unnamed: R27.2, X1.11
unnamed: U7.28 (GPIO21(ADC6)), U7.B28 (GPIO21(ADC6))
unnamed: U7.27 (GPIO20(ADC5)), U7.B27 (GPIO20(ADC5))
unnamed: U4.26 (GPIO19(ADC4)), U4.B26 (GPIO19(ADC4))
unnamed: U3.26 (GPIO19(ADC4)), U3.B26 (GPIO19(ADC4))
unnamed: U3.21 (+3V3_A), U3.B21 (+3V3_A)
unnamed: U7.24 (GPIO17(ADC2)), U7.B24 (GPIO17(ADC2))
unnamed: U7.23 (GPIO16(ADC1)), U7.B23 (GPIO16(ADC1))
unnamed: U7.22 (GPIO15(ADC0)), U7.B22 (GPIO15(ADC0))
unnamed: U3.19 (AUDIO_OUT_R), U3.B19 (AUDIO_OUT_R)
unnamed: U3.17 (AUDIO_IN_R), U3.B17 (AUDIO_IN_R)
unnamed: U3.16 (AUDIO_IN_L), U3.B16 (AUDIO_IN_L)
unnamed: U3.15 (GPIO14(USART1_RX)), U3.B15 (GPIO14(USART1_RX))
unnamed: U3.14 (GPIO13(USART1_TX)), U3.B14 (GPIO13(USART1_TX))
unnamed: U7.26 (GPIO19(ADC4)), U7.B26 (GPIO19(ADC4))
unnamed: U3.35 (GPIO28(ADC11)), U3.38 (+3V3_D), U3.B35 (GPIO28(ADC11)), U3.B38 (+3V3_D)
unnamed: U3.34 (GPIO27(SAI2_FS_B)), U3.B34 (GPIO27(SAI2_FS_B))
unnamed: U3.33 (GPIO26(SAI2_SD_A)), U3.B33 (GPIO26(SAI2_SD_A))
unnamed: U3.32 (GPIO25(ADC10)), U3.B32 (GPIO25(ADC10))
unnamed: U3.28 (GPIO21(ADC6)), U3.B28 (GPIO21(ADC6))
unnamed: U3.27 (GPIO20(ADC5)), U3.B27 (GPIO20(ADC5))
unnamed: U7.21 (+3V3_A), U7.B21 (+3V3_A)
unnamed: U3.24 (GPIO17(ADC2)), U3.B24 (GPIO17(ADC2))
unnamed: U3.23 (GPIO16(ADC1)), U3.B23 (GPIO16(ADC1))
unnamed: U3.22 (GPIO15(ADC0)), U3.B22 (GPIO15(ADC0))
unnamed: U4.21 (+3V3_A), U4.B21 (+3V3_A)
unnamed: U4.19 (AUDIO_OUT_R), U4.B19 (AUDIO_OUT_R)
unnamed: U4.17 (AUDIO_IN_R), U4.B17 (AUDIO_IN_R)
unnamed: U4.16 (AUDIO_IN_L), U4.B16 (AUDIO_IN_L)
unnamed: U4.15 (GPIO14(USART1_RX)), U4.B15 (GPIO14(USART1_RX))
unnamed: U4.14 (GPIO13(USART1_TX)), U4.B14 (GPIO13(USART1_TX))
unnamed: S1.1 (S), S1.2 (S1), U7.14 (GPIO13(USART1_TX)), U7.B14 (GPIO13(USART1_TX))
unnamed: U3.2 (GPIO1(SDMMC1_D3)), U3.B2 (GPIO1(SDMMC1_D3))
unnamed: U4.34 (GPIO27(SAI2_FS_B)), U4.B34 (GPIO27(SAI2_FS_B))
unnamed: U4.33 (GPIO26(SAI2_SD_A)), U4.B33 (GPIO26(SAI2_SD_A))
unnamed: U4.32 (GPIO25(ADC10)), U4.B32 (GPIO25(ADC10))
unnamed: U4.28 (GPIO21(ADC6)), U4.B28 (GPIO21(ADC6))
unnamed: U4.27 (GPIO20(ADC5)), U4.B27 (GPIO20(ADC5))
unnamed: U4.24 (GPIO17(ADC2)), U4.B24 (GPIO17(ADC2))
unnamed: U4.23 (GPIO16(ADC1)), U4.B23 (GPIO16(ADC1))
unnamed: U4.22 (GPIO15(ADC0)), U4.B22 (GPIO15(ADC0))
unnamed: U5.21 (+3V3_A), U5.B21 (+3V3_A)
unnamed: U5.19 (AUDIO_OUT_R), U5.B19 (AUDIO_OUT_R)
unnamed: U5.17 (AUDIO_IN_R), U5.B17 (AUDIO_IN_R)
unnamed: U5.16 (AUDIO_IN_L), U5.B16 (AUDIO_IN_L)
unnamed: U5.15 (GPIO14(USART1_RX)), U5.B15 (GPIO14(USART1_RX))
unnamed: U5.14 (GPIO13(USART1_TX)), U5.B14 (GPIO13(USART1_TX))
unnamed: U3.3 (GPIO2(SDMMC1_D2)), U3.B3 (GPIO2(SDMMC1_D2))
unnamed: U3.4 (GPIO3(SDMMC1_D1)), U3.B4 (GPIO3(SDMMC1_D1))
unnamed: U5.34 (GPIO27(SAI2_FS_B)), U5.B34 (GPIO27(SAI2_FS_B))
unnamed: U5.33 (GPIO26(SAI2_SD_A)), U5.B33 (GPIO26(SAI2_SD_A))
unnamed: U5.32 (GPIO25(ADC10)), U5.B32 (GPIO25(ADC10))
unnamed: U5.28 (GPIO21(ADC6)), U5.B28 (GPIO21(ADC6))
unnamed: U5.27 (GPIO20(ADC5)), U5.B27 (GPIO20(ADC5))
unnamed: U5.24 (GPIO17(ADC2)), U5.B24 (GPIO17(ADC2))
unnamed: U5.23 (GPIO16(ADC1)), U5.B23 (GPIO16(ADC1))
unnamed: U5.22 (GPIO15(ADC0)), U5.B22 (GPIO15(ADC0))
unnamed: C22.1, L1.P$2, PS1.2 (VIN)
unnamed: U6.21 (+3V3_A), U6.B21 (+3V3_A)
unnamed: U6.19 (AUDIO_OUT_R), U6.B19 (AUDIO_OUT_R)
unnamed: U6.17 (AUDIO_IN_R), U6.B17 (AUDIO_IN_R)
unnamed: U6.16 (AUDIO_IN_L), U6.B16 (AUDIO_IN_L)
unnamed: U6.15 (GPIO14(USART1_RX)), U6.B15 (GPIO14(USART1_RX))
unnamed: U6.14 (GPIO13(USART1_TX)), U6.B14 (GPIO13(USART1_TX))
unnamed: U6.37 (GPIO30(USB_HS_D+)), U6.38 (+3V3_D), U6.B37 (GPIO30(USB_HS_D+)), U6.B38 (+3V3_D)
unnamed: U3.5 (GPIO4(SDMMC1_D0)), U3.B5 (GPIO4(SDMMC1_D0))
unnamed: U6.34 (GPIO27(SAI2_FS_B)), U6.B34 (GPIO27(SAI2_FS_B))
unnamed: U6.33 (GPIO26(SAI2_SD_A)), U6.B33 (GPIO26(SAI2_SD_A))
unnamed: U6.32 (GPIO25(ADC10)), U6.B32 (GPIO25(ADC10))
unnamed: U6.28 (GPIO21(ADC6)), U6.B28 (GPIO21(ADC6))
unnamed: U6.27 (GPIO20(ADC5)), U6.B27 (GPIO20(ADC5))
unnamed: U6.24 (GPIO17(ADC2)), U6.B24 (GPIO17(ADC2))
unnamed: U6.23 (GPIO16(ADC1)), U6.B23 (GPIO16(ADC1))
unnamed: U6.22 (GPIO15(ADC0)), U6.B22 (GPIO15(ADC0))
unnamed: U8.21 (+3V3_A), U8.B21 (+3V3_A)
unnamed: U8.19 (AUDIO_OUT_R), U8.B19 (AUDIO_OUT_R)
unnamed: U8.17 (AUDIO_IN_R), U8.B17 (AUDIO_IN_R)
unnamed: U8.16 (AUDIO_IN_L), U8.B16 (AUDIO_IN_L)
unnamed: U8.15 (GPIO14(USART1_RX)), U8.B15 (GPIO14(USART1_RX))
unnamed: U8.14 (GPIO13(USART1_TX)), U8.B14 (GPIO13(USART1_TX))
unnamed: U8.35 (GPIO28(ADC11)), U8.37 (GPIO30(USB_HS_D+)), U8.38 (+3V3_D), U8.B35 (GPIO28(ADC11)), U8.B37 (GPIO30(USB_HS_D+)), U8.B38 (+3V3_D)
unnamed: U3.6 (GPIO5(SDMMC1_CMD)), U3.B6 (GPIO5(SDMMC1_CMD))
unnamed: U3.7 (GPIO6(SDMMC1_CK)), U3.B7 (GPIO6(SDMMC1_CK))
unnamed: U2.19 (AUDIO_OUT_R), U2.B19 (AUDIO_OUT_R)
unnamed: U8.34 (GPIO27(SAI2_FS_B)), U8.B34 (GPIO27(SAI2_FS_B))
unnamed: U8.33 (GPIO26(SAI2_SD_A)), U8.B33 (GPIO26(SAI2_SD_A))
unnamed: U8.32 (GPIO25(ADC10)), U8.B32 (GPIO25(ADC10))
unnamed: U8.28 (GPIO21(ADC6)), U8.B28 (GPIO21(ADC6))
unnamed: U8.27 (GPIO20(ADC5)), U8.B27 (GPIO20(ADC5))
unnamed: U8.24 (GPIO17(ADC2)), U8.B24 (GPIO17(ADC2))
unnamed: U8.23 (GPIO16(ADC1)), U8.B23 (GPIO16(ADC1))
unnamed: U8.22 (GPIO15(ADC0)), U8.B22 (GPIO15(ADC0))
unnamed: U4.2 (GPIO1(SDMMC1_D3)), U4.B2 (GPIO1(SDMMC1_D3))
unnamed: U4.3 (GPIO2(SDMMC1_D2)), U4.B3 (GPIO2(SDMMC1_D2))
unnamed: U4.4 (GPIO3(SDMMC1_D1)), U4.B4 (GPIO3(SDMMC1_D1))
unnamed: U4.5 (GPIO4(SDMMC1_D0)), U4.B5 (GPIO4(SDMMC1_D0))
unnamed: U4.6 (GPIO5(SDMMC1_CMD)), U4.B6 (GPIO5(SDMMC1_CMD))
unnamed: U4.7 (GPIO6(SDMMC1_CK)), U4.B7 (GPIO6(SDMMC1_CK))
unnamed: U2.17 (AUDIO_IN_R), U2.B17 (AUDIO_IN_R)
unnamed: U5.2 (GPIO1(SDMMC1_D3)), U5.B2 (GPIO1(SDMMC1_D3))
unnamed: U5.3 (GPIO2(SDMMC1_D2)), U5.B3 (GPIO2(SDMMC1_D2))
unnamed: U5.4 (GPIO3(SDMMC1_D1)), U5.B4 (GPIO3(SDMMC1_D1))
unnamed: U5.5 (GPIO4(SDMMC1_D0)), U5.B5 (GPIO4(SDMMC1_D0))
unnamed: U5.6 (GPIO5(SDMMC1_CMD)), U5.B6 (GPIO5(SDMMC1_CMD))
unnamed: U5.7 (GPIO6(SDMMC1_CK)), U5.B7 (GPIO6(SDMMC1_CK))
unnamed: U2.16 (AUDIO_IN_L), U2.B16 (AUDIO_IN_L)
unnamed: U6.2 (GPIO1(SDMMC1_D3)), U6.B2 (GPIO1(SDMMC1_D3))
unnamed: U6.3 (GPIO2(SDMMC1_D2)), U6.B3 (GPIO2(SDMMC1_D2))
unnamed: U6.4 (GPIO3(SDMMC1_D1)), U6.B4 (GPIO3(SDMMC1_D1))
unnamed: U6.5 (GPIO4(SDMMC1_D0)), U6.B5 (GPIO4(SDMMC1_D0))
unnamed: U6.6 (GPIO5(SDMMC1_CMD)), U6.B6 (GPIO5(SDMMC1_CMD))
unnamed: U6.7 (GPIO6(SDMMC1_CK)), U6.B7 (GPIO6(SDMMC1_CK))
unnamed: U8.2 (GPIO1(SDMMC1_D3)), U8.B2 (GPIO1(SDMMC1_D3))
unnamed: U8.3 (GPIO2(SDMMC1_D2)), U8.B3 (GPIO2(SDMMC1_D2))
unnamed: U8.4 (GPIO3(SDMMC1_D1)), U8.B4 (GPIO3(SDMMC1_D1))
unnamed: U8.5 (GPIO4(SDMMC1_D0)), U8.B5 (GPIO4(SDMMC1_D0))
unnamed: U8.6 (GPIO5(SDMMC1_CMD)), U8.B6 (GPIO5(SDMMC1_CMD))
unnamed: U8.7 (GPIO6(SDMMC1_CK)), U8.B7 (GPIO6(SDMMC1_CK))
unnamed: U2.15 (GPIO14(USART1_RX)), U2.B15 (GPIO14(USART1_RX))
unnamed: U2.14 (GPIO13(USART1_TX)), U2.B14 (GPIO13(USART1_TX))
unnamed: U2.34 (GPIO27(SAI2_FS_B)), U2.B34 (GPIO27(SAI2_FS_B))
unnamed: U2.33 (GPIO26(SAI2_SD_A)), U2.B33 (GPIO26(SAI2_SD_A))
unnamed: U2.32 (GPIO25(ADC10)), U2.B32 (GPIO25(ADC10))
unnamed: U2.28 (GPIO21(ADC6)), U2.B28 (GPIO21(ADC6))
unnamed: U2.27 (GPIO20(ADC5)), U2.B27 (GPIO20(ADC5))
unnamed: U2.24 (GPIO17(ADC2)), U2.B24 (GPIO17(ADC2))
unnamed: U2.23 (GPIO16(ADC1)), U2.B23 (GPIO16(ADC1))
unnamed: U2.22 (GPIO15(ADC0)), U2.B22 (GPIO15(ADC0))
unnamed: U9.21 (+3V3_A), U9.B21 (+3V3_A)
unnamed: U9.19 (AUDIO_OUT_R), U9.B19 (AUDIO_OUT_R)
unnamed: U9.17 (AUDIO_IN_R), U9.B17 (AUDIO_IN_R)
unnamed: U9.16 (AUDIO_IN_L), U9.B16 (AUDIO_IN_L)
unnamed: U9.15 (GPIO14(USART1_RX)), U9.B15 (GPIO14(USART1_RX))
unnamed: U9.14 (GPIO13(USART1_TX)), U9.B14 (GPIO13(USART1_TX))
unnamed: U9.34 (GPIO27(SAI2_FS_B)), U9.B34 (GPIO27(SAI2_FS_B))
unnamed: U9.33 (GPIO26(SAI2_SD_A)), U9.B33 (GPIO26(SAI2_SD_A))
unnamed: U9.32 (GPIO25(ADC10)), U9.B32 (GPIO25(ADC10))
unnamed: U9.28 (GPIO21(ADC6)), U9.B28 (GPIO21(ADC6))
unnamed: U9.27 (GPIO20(ADC5)), U9.B27 (GPIO20(ADC5))
unnamed: U9.24 (GPIO17(ADC2)), U9.B24 (GPIO17(ADC2))
unnamed: U9.23 (GPIO16(ADC1)), U9.B23 (GPIO16(ADC1))
unnamed: U9.22 (GPIO15(ADC0)), U9.B22 (GPIO15(ADC0))
unnamed: U10.21 (+3V3_A), U10.B21 (+3V3_A)
unnamed: U10.19 (AUDIO_OUT_R), U10.B19 (AUDIO_OUT_R)
unnamed: U10.17 (AUDIO_IN_R), U10.B17 (AUDIO_IN_R)
unnamed: U10.16 (AUDIO_IN_L), U10.B16 (AUDIO_IN_L)
unnamed: U10.15 (GPIO14(USART1_RX)), U10.B15 (GPIO14(USART1_RX))
unnamed: U10.14 (GPIO13(USART1_TX)), U10.B14 (GPIO13(USART1_TX))
unnamed: U10.37 (GPIO30(USB_HS_D+)), U10.38 (+3V3_D), U10.B37 (GPIO30(USB_HS_D+)), U10.B38 (+3V3_D)
unnamed: U10.34 (GPIO27(SAI2_FS_B)), U10.B34 (GPIO27(SAI2_FS_B))
unnamed: U10.33 (GPIO26(SAI2_SD_A)), U10.B33 (GPIO26(SAI2_SD_A))
unnamed: U10.32 (GPIO25(ADC10)), U10.B32 (GPIO25(ADC10))
unnamed: U10.28 (GPIO21(ADC6)), U10.B28 (GPIO21(ADC6))
unnamed: U10.27 (GPIO20(ADC5)), U10.B27 (GPIO20(ADC5))
unnamed: U10.24 (GPIO17(ADC2)), U10.B24 (GPIO17(ADC2))
unnamed: U10.23 (GPIO16(ADC1)), U10.B23 (GPIO16(ADC1))
unnamed: U10.22 (GPIO15(ADC0)), U10.B22 (GPIO15(ADC0))
unnamed: U11.21 (+3V3_A), U11.B21 (+3V3_A)
unnamed: U11.19 (AUDIO_OUT_R), U11.B19 (AUDIO_OUT_R)
unnamed: U11.17 (AUDIO_IN_R), U11.B17 (AUDIO_IN_R)
unnamed: U11.16 (AUDIO_IN_L), U11.B16 (AUDIO_IN_L)
unnamed: U11.15 (GPIO14(USART1_RX)), U11.B15 (GPIO14(USART1_RX))
unnamed: U11.14 (GPIO13(USART1_TX)), U11.B14 (GPIO13(USART1_TX))
unnamed: U11.35 (GPIO28(ADC11)), U11.37 (GPIO30(USB_HS_D+)), U11.38 (+3V3_D), U11.B35 (GPIO28(ADC11)), U11.B37 (GPIO30(USB_HS_D+)), U11.B38 (+3V3_D)
unnamed: U11.34 (GPIO27(SAI2_FS_B)), U11.B34 (GPIO27(SAI2_FS_B))
unnamed: U11.33 (GPIO26(SAI2_SD_A)), U11.B33 (GPIO26(SAI2_SD_A))
unnamed: U11.32 (GPIO25(ADC10)), U11.B32 (GPIO25(ADC10))
unnamed: U11.28 (GPIO21(ADC6)), U11.B28 (GPIO21(ADC6))
unnamed: U11.27 (GPIO20(ADC5)), U11.B27 (GPIO20(ADC5))
unnamed: U11.24 (GPIO17(ADC2)), U11.B24 (GPIO17(ADC2))
unnamed: U11.23 (GPIO16(ADC1)), U11.B23 (GPIO16(ADC1))
unnamed: U11.22 (GPIO15(ADC0)), U11.B22 (GPIO15(ADC0))
unnamed: U9.31 (GPIO24(ADC9)), U9.B31 (GPIO24(ADC9))
unnamed: U10.31 (GPIO24(ADC9)), U10.B31 (GPIO24(ADC9))
unnamed: U11.31 (GPIO24(ADC9)), U11.B31 (GPIO24(ADC9))
unnamed: U11.26 (GPIO19(ADC4)), U11.B26 (GPIO19(ADC4))
unnamed: U10.26 (GPIO19(ADC4)), U10.B26 (GPIO19(ADC4))
unnamed: U9.26 (GPIO19(ADC4)), U9.B26 (GPIO19(ADC4))
unnamed: U2.26 (GPIO19(ADC4)), U2.B26 (GPIO19(ADC4))
unnamed: U2.2 (GPIO1(SDMMC1_D3)), U2.B2 (GPIO1(SDMMC1_D3))
unnamed: U2.3 (GPIO2(SDMMC1_D2)), U2.B3 (GPIO2(SDMMC1_D2))
unnamed: U2.4 (GPIO3(SDMMC1_D1)), U2.B4 (GPIO3(SDMMC1_D1))
unnamed: U2.5 (GPIO4(SDMMC1_D0)), U2.B5 (GPIO4(SDMMC1_D0))
unnamed: U2.6 (GPIO5(SDMMC1_CMD)), U2.B6 (GPIO5(SDMMC1_CMD))
unnamed: U2.7 (GPIO6(SDMMC1_CK)), U2.B7 (GPIO6(SDMMC1_CK))
unnamed: U9.2 (GPIO1(SDMMC1_D3)), U9.B2 (GPIO1(SDMMC1_D3))
unnamed: U9.3 (GPIO2(SDMMC1_D2)), U9.B3 (GPIO2(SDMMC1_D2))
unnamed: U9.4 (GPIO3(SDMMC1_D1)), U9.B4 (GPIO3(SDMMC1_D1))
unnamed: U9.5 (GPIO4(SDMMC1_D0)), U9.B5 (GPIO4(SDMMC1_D0))
unnamed: U9.6 (GPIO5(SDMMC1_CMD)), U9.B6 (GPIO5(SDMMC1_CMD))
unnamed: U9.7 (GPIO6(SDMMC1_CK)), U9.B7 (GPIO6(SDMMC1_CK))
unnamed: U10.2 (GPIO1(SDMMC1_D3)), U10.B2 (GPIO1(SDMMC1_D3))
unnamed: U10.3 (GPIO2(SDMMC1_D2)), U10.B3 (GPIO2(SDMMC1_D2))
unnamed: U10.4 (GPIO3(SDMMC1_D1)), U10.B4 (GPIO3(SDMMC1_D1))
unnamed: U10.5 (GPIO4(SDMMC1_D0)), U10.B5 (GPIO4(SDMMC1_D0))
unnamed: U10.6 (GPIO5(SDMMC1_CMD)), U10.B6 (GPIO5(SDMMC1_CMD))
unnamed: U10.7 (GPIO6(SDMMC1_CK)), U10.B7 (GPIO6(SDMMC1_CK))
unnamed: U11.2 (GPIO1(SDMMC1_D3)), U11.B2 (GPIO1(SDMMC1_D3))
unnamed: U11.3 (GPIO2(SDMMC1_D2)), U11.B3 (GPIO2(SDMMC1_D2))
unnamed: U11.4 (GPIO3(SDMMC1_D1)), U11.B4 (GPIO3(SDMMC1_D1))
unnamed: U11.5 (GPIO4(SDMMC1_D0)), U11.B5 (GPIO4(SDMMC1_D0))
unnamed: U11.6 (GPIO5(SDMMC1_CMD)), U11.B6 (GPIO5(SDMMC1_CMD))
unnamed: U11.7 (GPIO6(SDMMC1_CK)), U11.B7 (GPIO6(SDMMC1_CK))
OUT1: C25.1, U7.18 (AUDIO_OUT_L), U7.B18 (AUDIO_OUT_L)
OUT2: C21.1, U3.18 (AUDIO_OUT_L), U3.B18 (AUDIO_OUT_L)
OUT3: C26.1, U2.18 (AUDIO_OUT_L), U2.B18 (AUDIO_OUT_L), U4.18 (AUDIO_OUT_L), U4.B18 (AUDIO_OUT_L)
OUT4: C27.1, U5.18 (AUDIO_OUT_L), U5.B18 (AUDIO_OUT_L), U9.18 (AUDIO_OUT_L), U9.B18 (AUDIO_OUT_L)
OUT5: C29.1, U6.18 (AUDIO_OUT_L), U6.B18 (AUDIO_OUT_L), U10.18 (AUDIO_OUT_L), U10.B18 (AUDIO_OUT_L)
OUT6: C31.1, U8.18 (AUDIO_OUT_L), U8.B18 (AUDIO_OUT_L), U11.18 (AUDIO_OUT_L), U11.B18 (AUDIO_OUT_L)
PA1_SD_DETECT: J2.9 (DET), U3.31 (GPIO24(ADC9)), U3.B31 (GPIO24(ADC9)), U7.31 (GPIO24(ADC9)), U7.B31 (GPIO24(ADC9))
PA1_SD_DETECT1: U4.31 (GPIO24(ADC9)), U4.B31 (GPIO24(ADC9))
PA1_SD_DETECT2: U2.31 (GPIO24(ADC9)), U2.B31 (GPIO24(ADC9))
PULLUPED: U5.35 (GPIO28(ADC11)), U5.36 (GPIO29(USB_HS_D_-)), U5.38 (+3V3_D), U5.B35 (GPIO28(ADC11)), U5.B36 (GPIO29(USB_HS_D_-)), U5.B38 (+3V3_D), U9.35 (GPIO28(ADC11)), U9.36 (GPIO29(USB_HS_D_-)), U9.38 (+3V3_D), U9.B35 (GPIO28(ADC11)), U9.B36 (GPIO29(USB_HS_D_-)), U9.B38 (+3V3_D)
PULLUPED2: U2.36 (GPIO29(USB_HS_D_-)), U2.38 (+3V3_D), U2.B36 (GPIO29(USB_HS_D_-)), U2.B38 (+3V3_D), U4.36 (GPIO29(USB_HS_D_-)), U4.38 (+3V3_D), U4.B36 (GPIO29(USB_HS_D_-)), U4.B38 (+3V3_D)
SCLK_2: U2.9 (GPIO8(SPI1_SCK)), U2.B9 (GPIO8(SPI1_SCK)), U3.9 (GPIO8(SPI1_SCK)), U3.B9 (GPIO8(SPI1_SCK)), U4.9 (GPIO8(SPI1_SCK)), U4.B9 (GPIO8(SPI1_SCK)), U5.9 (GPIO8(SPI1_SCK)), U5.B9 (GPIO8(SPI1_SCK)), U6.9 (GPIO8(SPI1_SCK)), U6.B9 (GPIO8(SPI1_SCK)), U7.9 (GPIO8(SPI1_SCK)), U7.B9 (GPIO8(SPI1_SCK)), U8.9 (GPIO8(SPI1_SCK)), U8.B9 (GPIO8(SPI1_SCK)), U9.9 (GPIO8(SPI1_SCK)), U9.B9 (GPIO8(SPI1_SCK)), U10.9 (GPIO8(SPI1_SCK)), U10.B9 (GPIO8(SPI1_SCK)), U11.9 (GPIO8(SPI1_SCK)), U11.B9 (GPIO8(SPI1_SCK)), X1.10
SD_CLK: R32.1, U7.7 (GPIO6(SDMMC1_CK)), U7.B7 (GPIO6(SDMMC1_CK))
SD_CMD: R31.1, R95.1, U7.6 (GPIO5(SDMMC1_CMD)), U7.B6 (GPIO5(SDMMC1_CMD))
SD_DAT0: R33.1, R94.1, U7.5 (GPIO4(SDMMC1_D0)), U7.B5 (GPIO4(SDMMC1_D0))
SD_DAT1: R34.1, R93.1, U7.4 (GPIO3(SDMMC1_D1)), U7.B4 (GPIO3(SDMMC1_D1))
SD_DAT2: R29.1, R97.1, U7.3 (GPIO2(SDMMC1_D2)), U7.B3 (GPIO2(SDMMC1_D2))
SD_DAT3: R30.1, R96.1, U7.2 (GPIO1(SDMMC1_D3)), U7.B2 (GPIO1(SDMMC1_D3))
SPI6_CLK: U2.29 (GPIO22(ADC7/DAC2)), U2.B29 (GPIO22(ADC7/DAC2)), U3.29 (GPIO22(ADC7/DAC2)), U3.B29 (GPIO22(ADC7/DAC2)), U4.29 (GPIO22(ADC7/DAC2)), U4.B29 (GPIO22(ADC7/DAC2)), U5.29 (GPIO22(ADC7/DAC2)), U5.B29 (GPIO22(ADC7/DAC2)), U6.29 (GPIO22(ADC7/DAC2)), U6.B29 (GPIO22(ADC7/DAC2)), U7.29 (GPIO22(ADC7/DAC2)), U7.B29 (GPIO22(ADC7/DAC2)), U8.29 (GPIO22(ADC7/DAC2)), U8.B29 (GPIO22(ADC7/DAC2)), U9.29 (GPIO22(ADC7/DAC2)), U9.B29 (GPIO22(ADC7/DAC2)), U10.29 (GPIO22(ADC7/DAC2)), U10.B29 (GPIO22(ADC7/DAC2)), U11.29 (GPIO22(ADC7/DAC2)), U11.B29 (GPIO22(ADC7/DAC2)), X1.6
SPI6_MOSI: U2.25 (GPIO18(ADC3)), U2.B25 (GPIO18(ADC3)), U3.25 (GPIO18(ADC3)), U3.B25 (GPIO18(ADC3)), U4.25 (GPIO18(ADC3)), U4.B25 (GPIO18(ADC3)), U5.25 (GPIO18(ADC3)), U5.B25 (GPIO18(ADC3)), U6.25 (GPIO18(ADC3)), U6.B25 (GPIO18(ADC3)), U7.25 (GPIO18(ADC3)), U7.B25 (GPIO18(ADC3)), U8.25 (GPIO18(ADC3)), U8.B25 (GPIO18(ADC3)), U9.25 (GPIO18(ADC3)), U9.B25 (GPIO18(ADC3)), U10.25 (GPIO18(ADC3)), U10.B25 (GPIO18(ADC3)), U11.25 (GPIO18(ADC3)), U11.B25 (GPIO18(ADC3)), X1.8
SPI6_NSS: U2.30 (GPIO23(ADC8/DAC1)), U2.B30 (GPIO23(ADC8/DAC1)), U3.30 (GPIO23(ADC8/DAC1)), U3.B30 (GPIO23(ADC8/DAC1)), U4.30 (GPIO23(ADC8/DAC1)), U4.B30 (GPIO23(ADC8/DAC1)), U5.30 (GPIO23(ADC8/DAC1)), U5.B30 (GPIO23(ADC8/DAC1)), U6.30 (GPIO23(ADC8/DAC1)), U6.B30 (GPIO23(ADC8/DAC1)), U7.30 (GPIO23(ADC8/DAC1)), U7.B30 (GPIO23(ADC8/DAC1)), U8.30 (GPIO23(ADC8/DAC1)), U8.B30 (GPIO23(ADC8/DAC1)), U9.30 (GPIO23(ADC8/DAC1)), U9.B30 (GPIO23(ADC8/DAC1)), U10.30 (GPIO23(ADC8/DAC1)), U10.B30 (GPIO23(ADC8/DAC1)), U11.30 (GPIO23(ADC8/DAC1)), U11.B30 (GPIO23(ADC8/DAC1)), X1.5
SS_2: U2.8 (GPIO7(SPI1_NSS)), U2.B8 (GPIO7(SPI1_NSS)), U3.8 (GPIO7(SPI1_NSS)), U3.B8 (GPIO7(SPI1_NSS)), U4.8 (GPIO7(SPI1_NSS)), U4.B8 (GPIO7(SPI1_NSS)), U5.8 (GPIO7(SPI1_NSS)), U5.B8 (GPIO7(SPI1_NSS)), U6.8 (GPIO7(SPI1_NSS)), U6.B8 (GPIO7(SPI1_NSS)), U7.8 (GPIO7(SPI1_NSS)), U7.B8 (GPIO7(SPI1_NSS)), U8.8 (GPIO7(SPI1_NSS)), U8.B8 (GPIO7(SPI1_NSS)), U9.8 (GPIO7(SPI1_NSS)), U9.B8 (GPIO7(SPI1_NSS)), U10.8 (GPIO7(SPI1_NSS)), U10.B8 (GPIO7(SPI1_NSS)), U11.8 (GPIO7(SPI1_NSS)), U11.B8 (GPIO7(SPI1_NSS)), X1.9

Notes on the sheet:
Audio
000
001
010
011
100
101

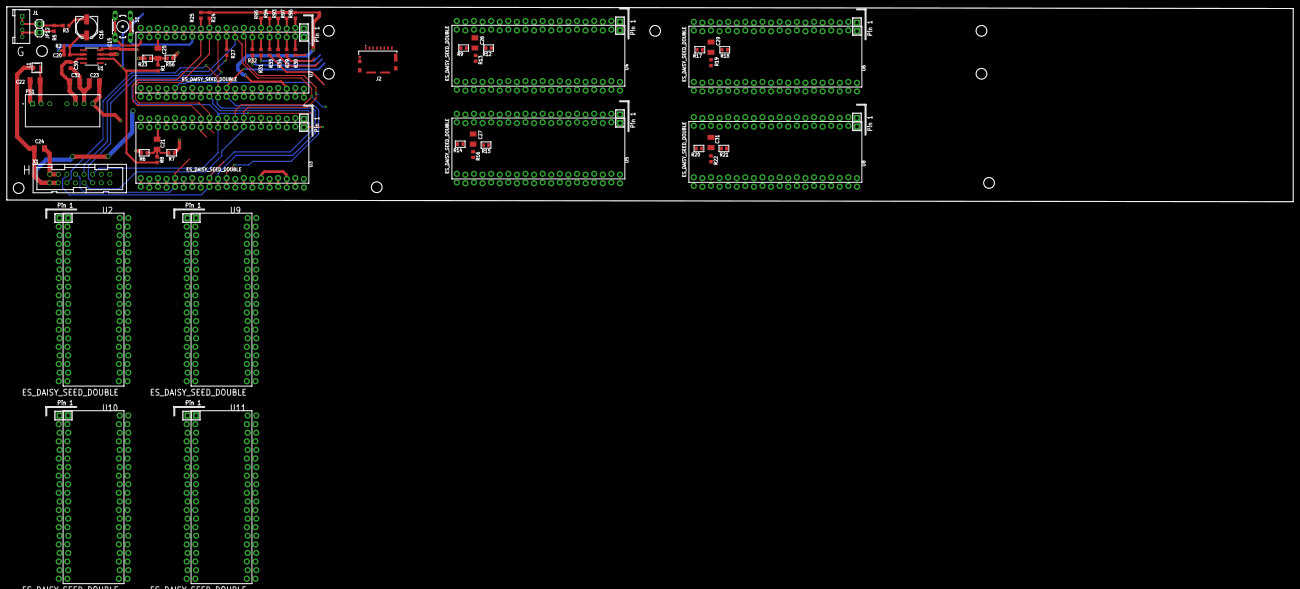
[picture p7: board electrosteel2020_10_arrange7_synthboardsonlyrev6.brd from above]

Board: 4 copper layers, 380.5 x 57.7 mm, 67 parts (0 on the bottom side), 275 nets.
