spiricom/Electrosteel_embedded/EAGLE_files/electrosteel_2020/electrosteel2020_10_arrange6_newstringconnector.brd

## EAGLE design EAGLE_files/electrosteel_2020/electrosteel2020_10_arrange6_newstringconnector.brd (2023-07-19)

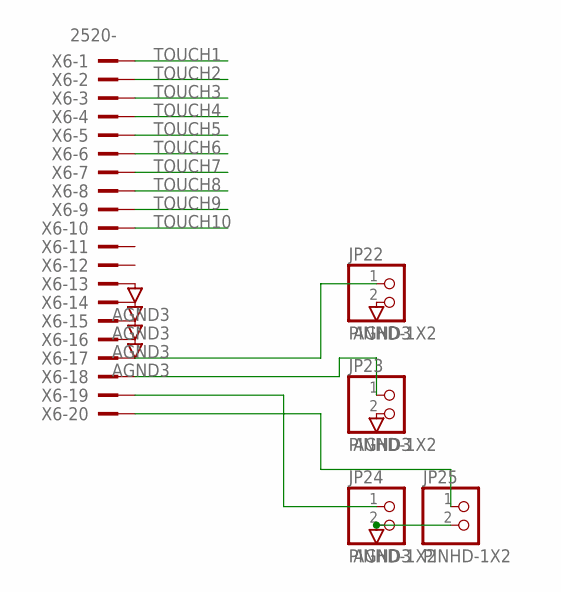
[picture p8: schematic electrosteel2020_10_arrange6_newstringconnector.sch]

Parts:
JP22, JP23, JP24, JP25: PINHD-1X2; 1X02; PARTNO *DNP
X6: 2520-; PAK100/2500-20; PARTNO N2520-6003-UG

Connections:
AGND3: JP22.2, JP23.2, JP24.2, JP25.2, X6.13, X6.14, X6.15, X6.16
unnamed: JP24.1, X6.19
unnamed: JP25.1, X6.20
unnamed: JP23.1, X6.18
unnamed: JP22.1, X6.17
TOUCH1: X6.1
TOUCH2: X6.2
TOUCH3: X6.3
TOUCH4: X6.4
TOUCH5: X6.5
TOUCH6: X6.6
TOUCH7: X6.7
TOUCH8: X6.8
TOUCH9: X6.9
TOUCH10: X6.10

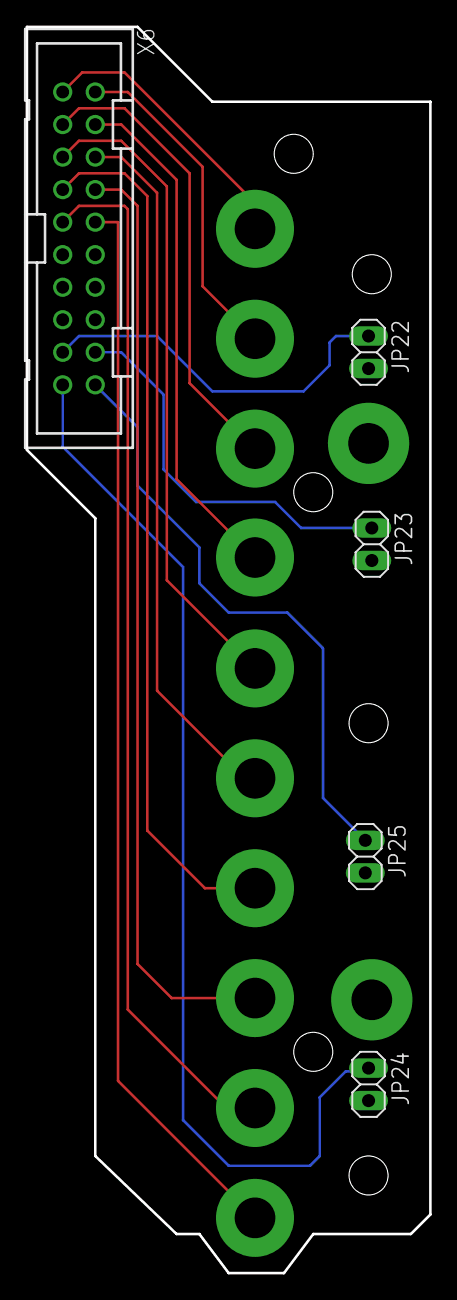
[picture p9: board electrosteel2020_10_arrange6_newstringconnector.brd from above]

Board: 4 copper layers, 31.5 x 97.3 mm, 5 parts (0 on the bottom side), 5 nets.
