spiricom/Electrosteel_embedded/EAGLE_files/electrosteel_2020/electrosteel2020_10_arrange6.brd

## EAGLE design EAGLE_files/electrosteel_2020/electrosteel2020_10_arrange6.brd (continued)

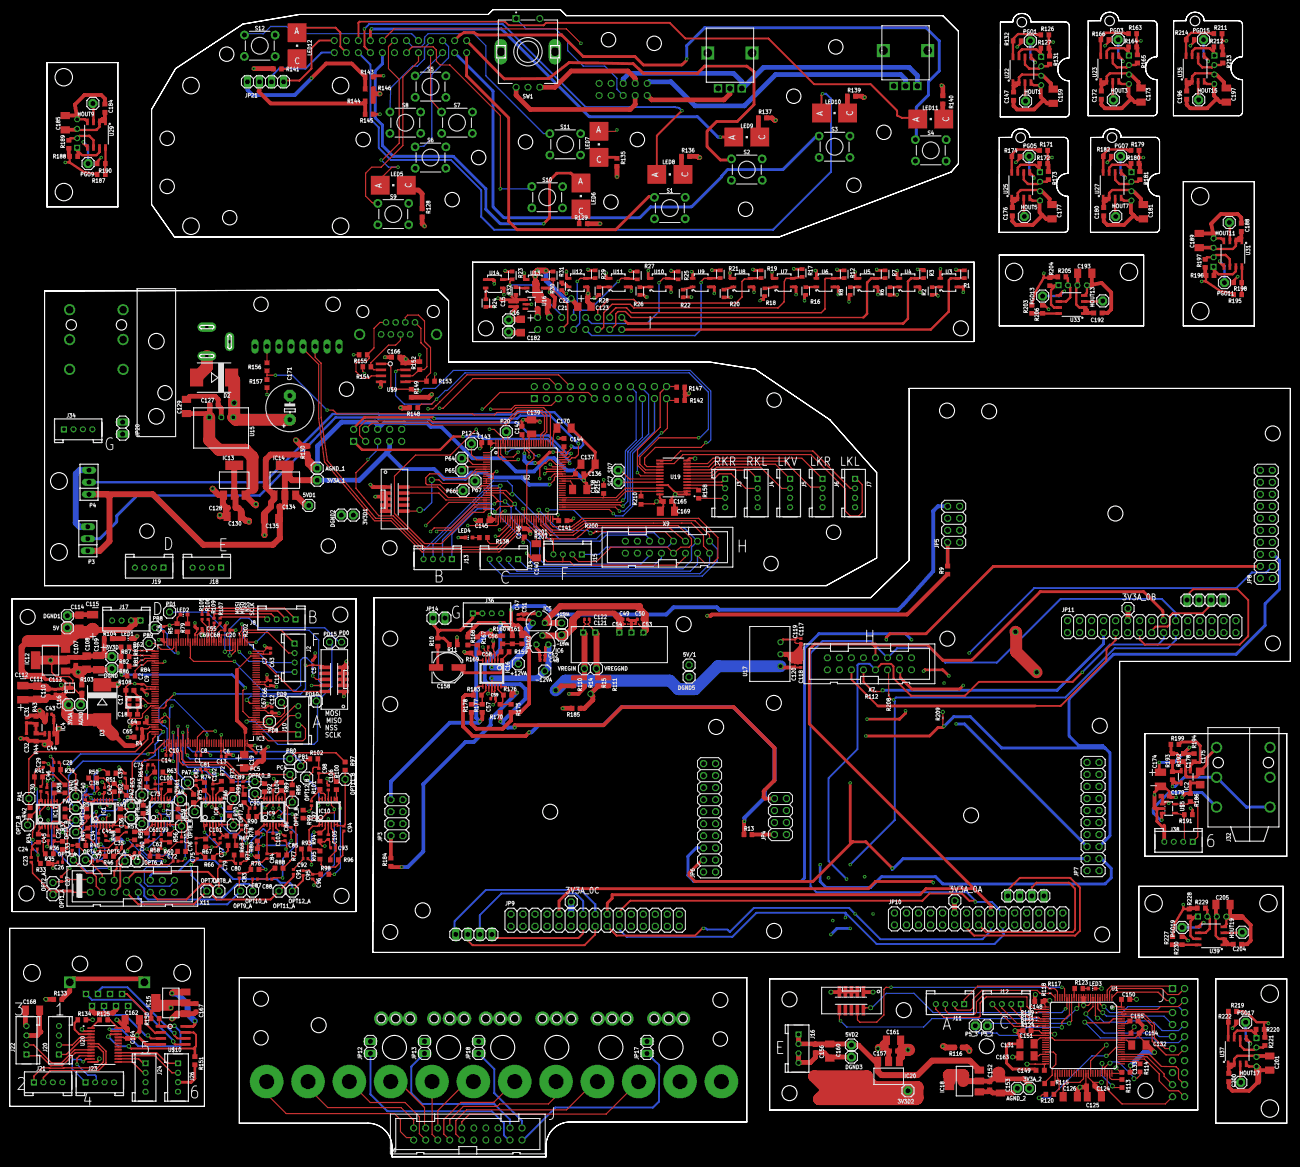
[picture p14: board electrosteel2020_10_arrange6.brd from above]

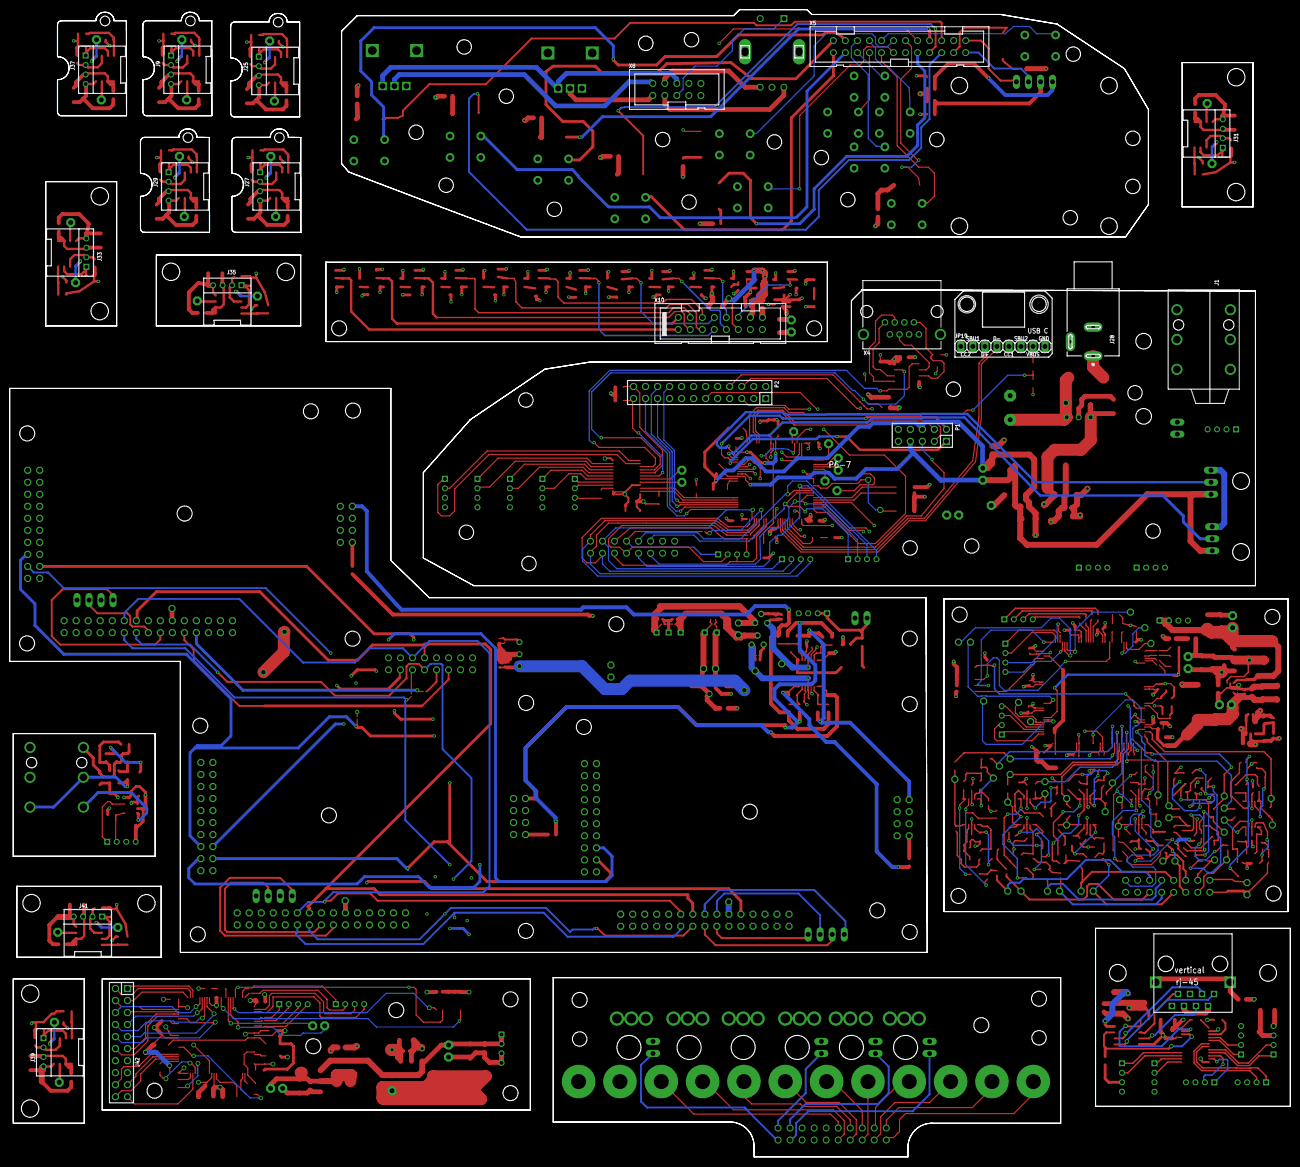
[picture p15: board electrosteel2020_10_arrange6.brd from below]

Board: 4 copper layers, 270.5 x 242.3 mm, 678 parts (21 on the bottom side), 529 nets.
