spiricom/Electrosteel_embedded/EAGLE_files/electrosteel_2020/electrosteel2021_synthboards1.brd

## EAGLE design EAGLE_files/electrosteel_2020/electrosteel2021_synthboards1.brd (2023-01-03)

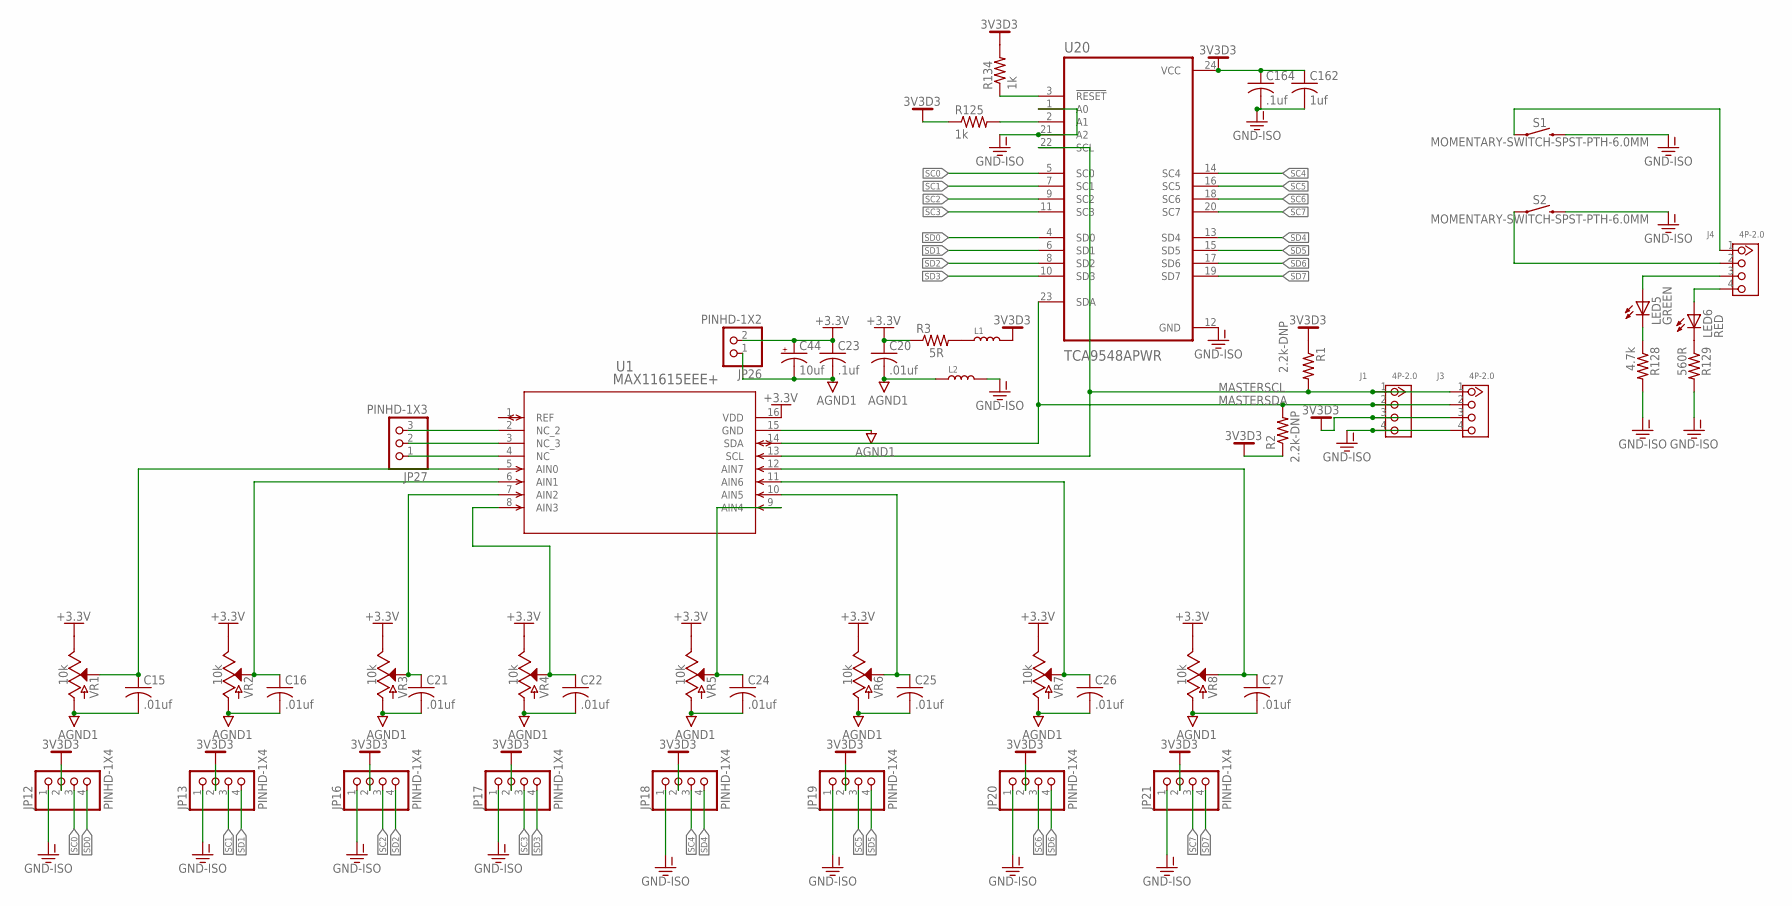
[picture p16: schematic electrosteel2021_synthboards1.sch, sheet 1]

Parts:
C15, C16, C20, C21, C22, C24, C25, C26, C27: .01uf; C0603; PARTNO CC0603KRX7R8BB103
C23, C164: .1uf; C0603; PARTNO CC0603KRX7R8BB104
C44: 10uf; SMC_B; PARTNO TAJB106K025RNJ
C162: 1uf; C1206K; PARTNO C3216X7R1E105K085AA
J1, J3, J4: 4P-2.0; HW4-2.0; PARTNO *DNP
JP12, JP13, JP16, JP17, JP18, JP19, JP20, JP21: PINHD-1X4; 1X04; PARTNO *DNP
JP26: PINHD-1X2; 1X02; PARTNO *DNP
JP27: PINHD-1X3; 1X03; PARTNO *DNP
L1, L2: INDUCTOR/FERRITE-BEAD0603; INDUCTOR_L0603; PARTNO FBMH1608HM470-TV
LED5: GREEN; P-LCC-2; PARTNO HSMM-A101-R00J1
LED6: RED; P-LCC-2; PARTNO HSMZ-A100-R00J1
R1, R2: 2.2k-DNP; R0603; PARTNO *DNP
R3: 5R; R0603; PARTNO RC0603JR-075R1L
R125, R134: 1k; R0603; PARTNO ESR03EZPF1001
R128: 4.7k; R0603; PARTNO CRCW06034K70FKEAHP
R129: 560R; R0603; PARTNO ESR03EZPF5600
S1, S2: MOMENTARY-SWITCH-SPST-PTH-6.0MM; TACTILE_SWITCH_PTH_6.0MM; PARTNO TL1105SPF160Q
U1: MAX11615EEE+; 21-0055H_16_MXM; PARTNO MAX11617EEE+
U20: TCA9548APWR; SOP65P640X120-24N; PARTNO TCA9548APWR
VR1, VR2, VR3, VR4, VR5, VR6, VR7, VR8: 10k; POT-PTH-ALPS; PARTNO *DNP

Connections:
3V3D3: C162.1, C164.1, J1.3, J3.3, JP12.2, JP13.2, JP16.2, JP17.2, JP18.2, JP19.2, JP20.2, JP21.2, L1.2, R1.1, R2.1, R125.1, R134.2, U20.24 (VCC)
+3.3V: C20.1, C23.1, C44.+, JP26.2, R3.1, U1.16 (VDD), VR1.P$1 (E), VR2.P$1 (E), VR3.P$1 (E), VR4.P$1 (E), VR5.P$1 (E), VR6.P$1 (E), VR7.P$1 (E), VR8.P$1 (E)
AGND1: C15.2, C16.2, C20.2, C21.2, C22.2, C23.2, C24.2, C25.2, C26.2, C27.2, C44.-, JP26.1, L2.1, U1.15 (GND), VR1.P$3 (A), VR2.P$3 (A), VR3.P$3 (A), VR4.P$3 (A), VR5.P$3 (A), VR6.P$3 (A), VR7.P$3 (A), VR8.P$3 (A)
GND-ISO: C162.2, C164.2, J1.4, J3.4, JP12.1, JP13.1, JP16.1, JP17.1, JP18.1, JP19.1, JP20.1, JP21.1, L2.2, R128.2, R129.2, S1.3 (2), S2.3 (2), U20.1 (A0), U20.12 (GND), U20.21 (A2)
MASTERSCL: J1.1, J3.1, R1.2, U1.13 (SCL), U20.22 (SCL)
MASTERSDA: J1.2, J3.2, R2.2, U1.14 (SDA), U20.23 (SDA)
unnamed: LED5.C, R128.1
unnamed: JP27.1, U1.4 (NC)
unnamed: C15.1, U1.5 (AIN0), VR1.P$2 (S)
unnamed: C16.1, U1.6 (AIN1), VR2.P$2 (S)
unnamed: C21.1, U1.7 (AIN2), VR3.P$2 (S)
unnamed: C22.1, U1.8 (AIN3), VR4.P$2 (S)
unnamed: J4.2, S2.1
unnamed: C24.1, U1.9 (AIN4), VR5.P$2 (S)
unnamed: C25.1, U1.10 (AIN5), VR6.P$2 (S)
unnamed: J4.3, LED5.A
unnamed: C26.1, U1.11 (AIN6), VR7.P$2 (S)
unnamed: C27.1, U1.12 (AIN7), VR8.P$2 (S)
unnamed: J4.4, LED6.A
unnamed: JP27.2, U1.3 (NC_3)
unnamed: R125.2, U20.2 (A1)
unnamed: JP27.3, U1.2 (NC_2)
unnamed: L1.1, R3.2
unnamed: J4.1, S1.1
unnamed: R134.1, U20.3 (!RESET)
unnamed: LED6.C, R129.1
SC0: JP12.3, U20.5 (SC0)
SC1: JP13.3, U20.7 (SC1)
SC2: JP16.3, U20.9 (SC2)
SC3: JP17.3, U20.11 (SC3)
SC4: JP18.3, U20.14 (SC4)
SC5: JP19.3, U20.16 (SC5)
SC6: JP20.3, U20.18 (SC6)
SC7: JP21.3, U20.20 (SC7)
SD0: JP12.4, U20.4 (SD0)
SD1: JP13.4, U20.6 (SD1)
SD2: JP16.4, U20.8 (SD2)
SD3: JP17.4, U20.10 (SD3)
SD4: JP18.4, U20.13 (SD4)
SD5: JP19.4, U20.15 (SD5)
SD6: JP20.4, U20.17 (SD6)
SD7: JP21.4, U20.19 (SD7)

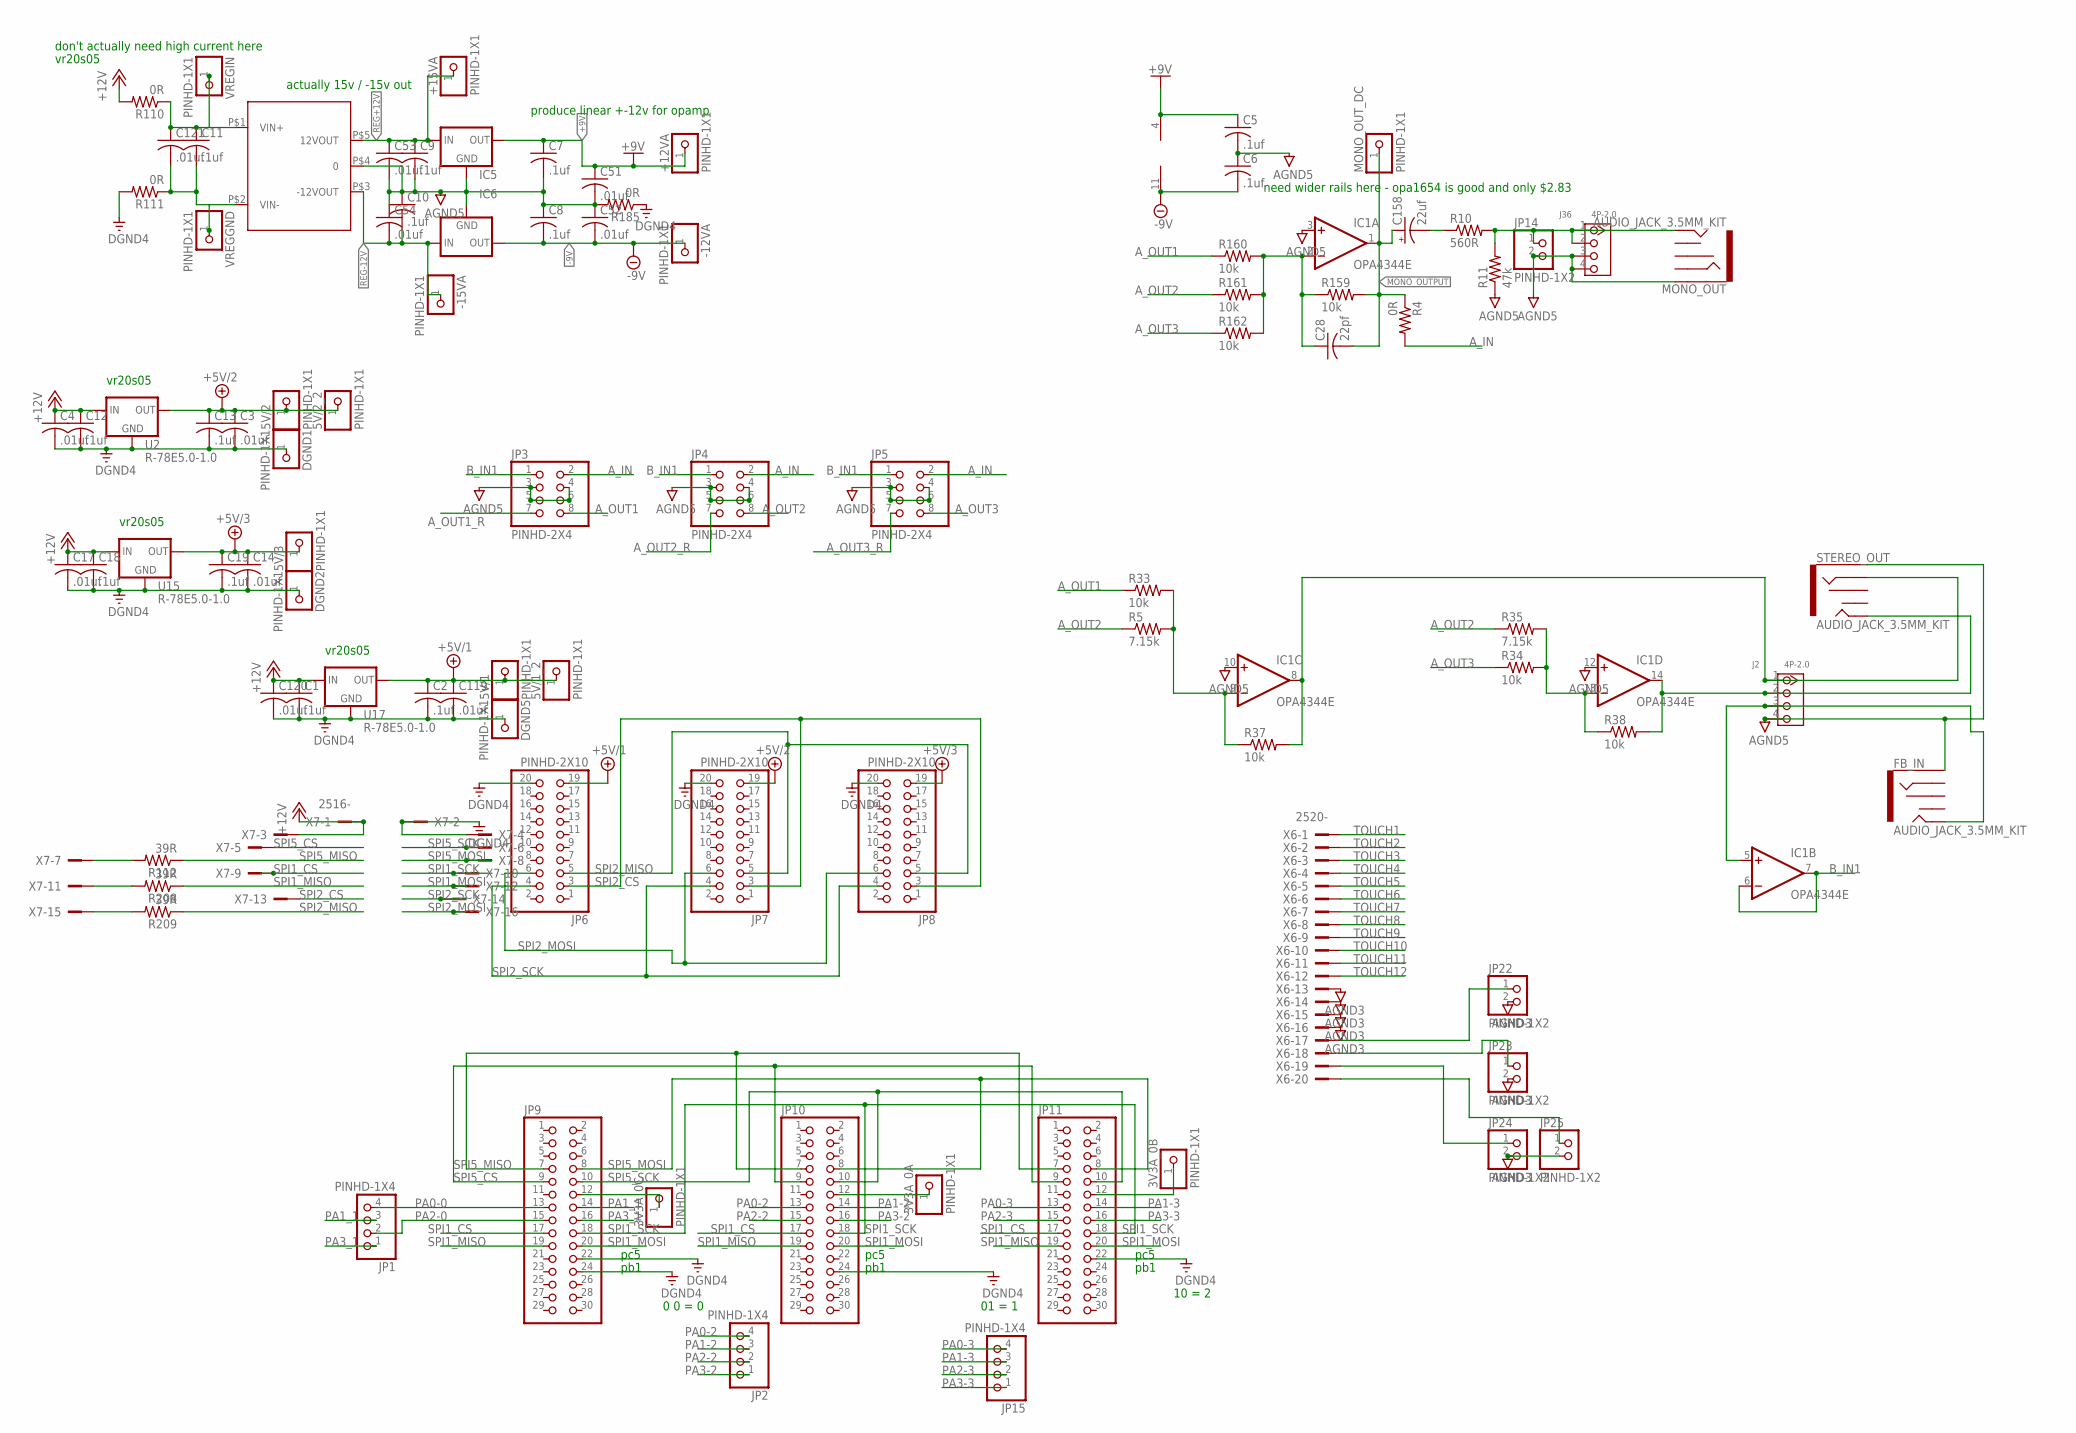
[picture p17: schematic electrosteel2021_synthboards1.sch, sheet 2]

Parts:
3V3A_0A, 3V3A_0B, 3V3A_0C, 5V/1, 5V/1_2, 5V/2, 5V/2_2, 5V/3: PINHD-1X1; 1X01; PARTNO *DNP
+12VA, +15VA: PINHD-1X1; 1X01; PARTNO *DNP
-12VA, -15VA: PINHD-1X1; 1X01; PARTNO *DNP
C1, C2, C5, C6, C7, C8, C9, C10, C11, C12, C13, C18, C19: .1uf; C0603; PARTNO CC0603KRX7R8BB104
C3, C4, C14, C17, C51, C52, C53, C54, C119, C120, C121: .01uf; C0603; PARTNO CC0603KRX7R8BB103
C28: 22pf; C0603; PARTNO CC0603JRNPO9BN220
C158: 22uf; PANASONIC_D; PARTNO EEE-1CA220NP
DGND1, DGND2, DGND5: PINHD-1X1; 1X01; PARTNO *DNP
FB_IN: AUDIO_JACK_3.5MM_KIT; AUDIO-JACK-KIT; PARTNO PRT-08032
IC1: OPA4344E; TSSOP14; PARTNO OPA1664AIPWR
IC5: 78LXX; PARTNO LM78L12ACZ/LFT7
IC6: 79LXX; PARTNO L79L12ACZ-TR
J2, J36: 4P-2.0; HW4-2.0; PARTNO *DNP
JP1, JP2, JP15: PINHD-1X4; 1X04; PARTNO *DNP
JP3, JP4, JP5: PINHD-2X4; 2X04; PARTNO 77313-101-08LF
JP6, JP7, JP8: PINHD-2X10; 2X10; PARTNO 77313-101-20LF
JP9, JP10, JP11: PINHD-2X15; 2X15; PARTNO 77313-101-30LF
JP14, JP22, JP23, JP24, JP25: PINHD-1X2; 1X02; PARTNO *DNP
MONO_OUT: AUDIO_JACK_3.5MM_KIT; AUDIO-JACK-KIT; PARTNO PRT-08032
MONO_OUT_DC: PINHD-1X1; 1X01; PARTNO *DNP
R4, R110, R111, R185: 0R; R0603; PARTNO RCS06030000Z0EA
R5, R35: 7.15k; R0603; PARTNO ERJ-3EKF7151V
R10: 560R; R0603; PARTNO ESR03EZPF5600
R11: 47k; R0603; PARTNO ESR03EZPJ473
R33, R34, R37, R38, R159, R160, R161, R162: 10k; R0603; PARTNO ESR03EZPF1002
R112, R208, R209: 39R; R0603; PARTNO RC0603JR-0739RL
STEREO_OUT: AUDIO_JACK_3.5MM_KIT; AUDIO-JACK-KIT; PARTNO PRT-08032
U2, U15, U17: R-78E5.0-1.0; DC-DC_CONVERTER_78XX; PARTNO R-78E5.0-1.0
U$3: CMR0512S3C; PARTNO DPU01M-15
VREGGND: PINHD-1X1; 1X01; PARTNO *DNP
VREGIN: PINHD-1X1; 1X01; PARTNO *DNP
X6: 2520-; PAK100/2500-20; PARTNO N2520-6003-UG
X7: 2516-; PAK100/2500-16; PARTNO D2516-6002-AR

Connections:
+5V/1: 5V/1.1, 5V/1_2.1, C2.1, C119.1, JP6.19, U17.VOUT (OUT)
+5V/2: 5V/2.1, 5V/2_2.1, C3.1, C13.1, JP7.19, U2.VOUT (OUT)
+5V/3: 5V/3.1, C14.1, C19.1, JP8.19, U15.VOUT (OUT)
+9V: +12VA.1, C5.1, C7.1, C51.1, IC1.4 (V+), IC5.OUT
+12V: C1.1, C4.1, C12.1, C17.1, C18.1, C120.1, R110.2, U2.VIN (IN), U15.VIN (IN), U17.VIN (IN), X7.1, X7.3
-9V: -12VA.1, C6.2, C8.2, C52.2, IC1.11 (V-), IC6.OUT
AGND3: JP22.2, JP23.2, JP24.2, JP25.2, X6.13, X6.14, X6.15, X6.16
AGND5: C5.2, C6.1, C7.2, C8.1, C9.2, C10.1, C51.2, C52.1, C53.2, C54.1, FB_IN.SLEEVE, IC1.3 (+IN), IC1.10 (+IN), IC1.12 (+IN), IC5.GND, IC6.GND, J2.4, J36.3, J36.4, JP3.3, JP3.4, JP3.5, JP3.6, JP4.3, JP4.4, JP4.5, JP4.6, JP5.3, JP5.4, JP5.5, JP5.6, JP14.2, MONO_OUT.SLEEVE, R11.1, R185.2, STEREO_OUT.SLEEVE, U$3.P$4 (0)
A_IN: JP3.2, JP4.2, JP5.2, R4.2
A_OUT1: JP3.8, R33.1, R160.1
A_OUT1_R: JP3.7
A_OUT2: JP4.8, R5.1, R35.1, R161.1
A_OUT2_R: JP4.7
A_OUT3: JP5.8, R34.1, R162.1
A_OUT3_R: JP5.7
B_IN1: IC1.6 (-IN), IC1.7 (OUT), JP3.1, JP4.1, JP5.1
DGND4: C1.2, C2.2, C3.2, C4.2, C12.2, C13.2, C14.2, C17.2, C18.2, C19.2, C119.2, C120.2, DGND1.1, DGND2.1, DGND5.1, JP6.20, JP7.20, JP8.20, JP9.22, JP9.24, JP10.24, JP11.22, R111.2, R185.1, U2.GND, U15.GND, U17.GND, X7.2, X7.4
MONO_OUTPUT: C28.2, C158.+, IC1.1 (OUT), MONO_OUT_DC.1, R4.1, R159.2
unnamed: IC1.9 (-IN), R5.2, R33.2, R37.1
unnamed: IC1.13 (-IN), R34.2, R35.2, R38.1
unnamed: IC1.14 (OUT), J2.2, R38.2, STEREO_OUT.TIP
unnamed: IC1.8 (OUT), J2.1, R37.2, STEREO_OUT.RING
unnamed: JP24.1, X6.19
unnamed: FB_IN.TIP, IC1.5 (+IN), J2.3
unnamed: JP25.1, X6.20
unnamed: JP23.1, X6.18
unnamed: JP22.1, X6.17
unnamed: C28.1, IC1.2 (-IN), R159.1, R160.2, R161.2, R162.2
unnamed: C11.2, C121.2, R111.1, U$3.P$2 (VIN-), VREGGND.1
unnamed: C11.1, C121.1, R110.1, U$3.P$1 (VIN+), VREGIN.1
unnamed: C158.-, R10.1
unnamed: J36.1, J36.2, JP14.1, MONO_OUT.TIP, R10.2, R11.2
unnamed: R209.2, X7.15
unnamed: R208.2, X7.11
unnamed: R112.2, X7.7
unnamed: 3V3A_0C.1, JP9.12
unnamed: 3V3A_0A.1, JP10.12
unnamed: 3V3A_0B.1, JP11.12
PA0-0: JP1.4, JP9.13
PA0-2: JP2.4, JP10.13
PA0-3: JP11.13, JP15.4
PA1-2: JP2.3, JP10.14
PA1-3: JP11.14, JP15.3
PA1_1: JP1.3, JP9.14
PA2-0: JP1.2, JP9.15
PA2-2: JP2.2, JP10.15
PA2-3: JP11.15, JP15.2
PA3-2: JP2.1, JP10.16
PA3-3: JP11.16, JP15.1
PA3_1: JP1.1, JP9.16
REG+12V: +15VA.1, C9.1, C53.1, IC5.IN, U$3.P$5 (12VOUT)
REG-12V: -15VA.1, C10.2, C54.2, IC6.IN, U$3.P$3 (-12VOUT)
SPI1_CS: JP9.17, JP10.17, JP11.17, X7.9
SPI1_MISO: JP9.19, JP10.19, JP11.19, R208.1
SPI1_MOSI: JP9.20, JP10.20, JP11.20, X7.12
SPI1_SCK: JP9.18, JP10.18, JP11.18, X7.10
SPI2_CS: JP6.3, JP7.3, JP8.3, X7.13
SPI2_MISO: JP6.5, JP7.5, JP8.5, R209.1
SPI2_MOSI: JP6.6, JP7.6, JP8.6, X7.16
SPI2_SCK: JP6.4, JP7.4, JP8.4, X7.14
SPI5_CS: JP9.9, JP10.9, JP11.9, X7.5
SPI5_MISO: JP9.7, JP10.7, JP11.7, R112.1
SPI5_MOSI: JP9.8, JP10.8, JP11.8, X7.8
SPI5_SCK: JP9.10, JP10.10, JP11.10, X7.6
TOUCH1: X6.1
TOUCH2: X6.2
TOUCH3: X6.3
TOUCH4: X6.4
TOUCH5: X6.5
TOUCH6: X6.6
TOUCH7: X6.7
TOUCH8: X6.8
TOUCH9: X6.9
TOUCH10: X6.10
TOUCH11: X6.11
TOUCH12: X6.12

Notes on the sheet:
produce linear +-12v for opamp
vr20s05
0 0 = 0
01 = 1
10 = 2
don't actually need high current here
pc5
pb1
need wider rails here - opa1654 is good and only $2.83
actually 15v / -15v out

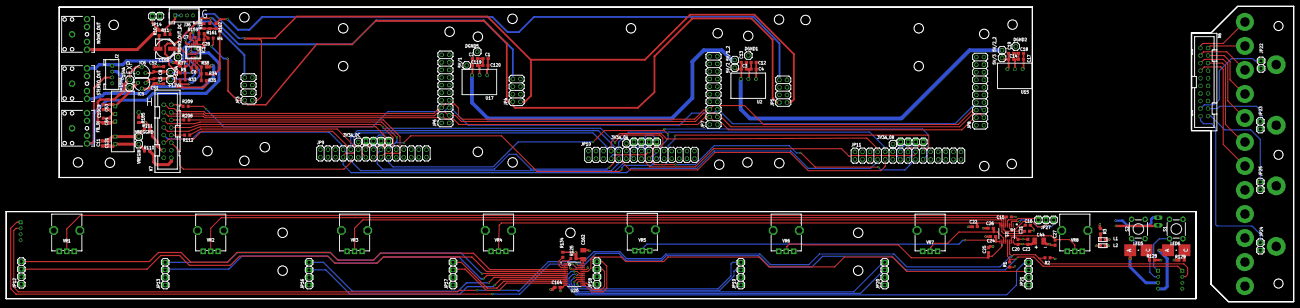
[picture p18: board electrosteel2021_synthboards1.brd from above]

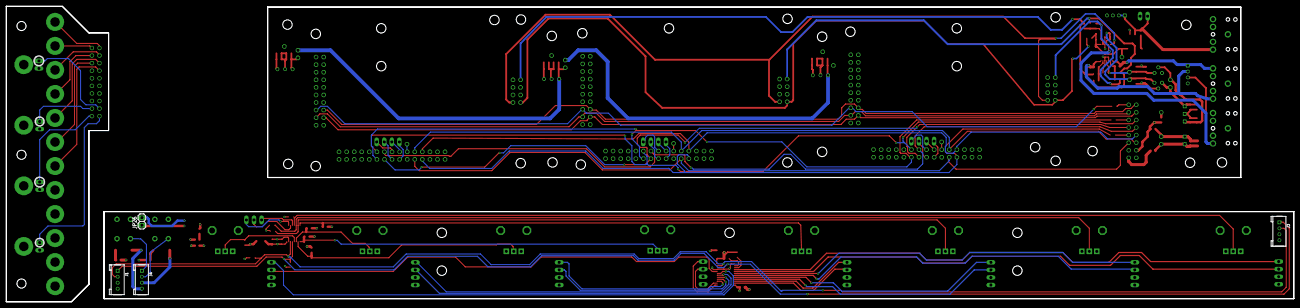
[picture p19: board electrosteel2021_synthboards1.brd from below]

Board: 4 copper layers, 431.8 x 99.1 mm, 143 parts (4 on the bottom side), 103 nets.
