spiricom/Electrosteel_embedded/PSOC5_electrosteel_stringsensors_newpcb_brain/CE210514_PSOC3_5_Thermistor.cydsn/main.c

/*main.c
*****************************************************************************/
#include <device.h>
#include <stdio.h>
#include <math.h>
#include "oled.h"
#include "main.h"
#include "ui.h"

//#define BOOTLOAD_STYLE

const float versionNumber = 1.16f;

uint32_t prevLastBufferBegin[2];
uint32_t lastBufferBegin[2];
uint32_t masterTimer = 0;
uint32_t lastParseCall = 0;
uint32_t prevLastParseCall = 0;
uint32_t lastBufferStuff = 0;
uint32_t lastEndReceive = 0;

uint8_t sysexBuffer[2048];
uint32_t sysexWritePointer = 0;
uint32_t sysexReadPointer = 0;
uint8_t sysexReset = 1;
uint32_t sysexMessageStartPoints[256];
uint8_t sysexMessageStartPointsWritePosition = 0;
uint8_t sysexMessageStartPointsReadPosition = 0;
uint8_t receivingSysex = 0;
uint8_t parsingSysex = 0;
volatile uint8_t presetArray[2048];
uint8_t presetNumberToWrite = 0;
uint8_t copedentNumberToWrite = 0;
uint8_t sendMessageEnd = 0;

uint8_t sendSingleParamUpdate = 0;
uint8_t singleParamToUpdateHigh = 0;
uint8_t singleParamToUpdateLow = 0;
uint8_t singleParamValueHigh = 0;
uint8_t singleParamValueLow = 0;
            
uint8_t sendMappingChangeUpdate = 0;


int8_t presetNumberToStore = 0;
            

int8_t transposeSemitones = 0;
int8_t transposeCents = 0;
float transposeFloat = 0.0f;
int8_t volumeInt = 0;
uint8_t volumeWaitingToSend = 0;
uint8_t midiSendOn = 0;
uint8_t midiBarSendOn = 0;
uint8_t midiDebugSendOn = 0;
uint8_t pitchSmoothing = 0;
uint8_t controlSmoothing = 0;
uint8_t octaveAction = 0;
uint8_t stringRepresentation[2] = {3,8};

uint8_t presetArraySection = presetName;

uint8_t sendLocalPresetStoreCommand;

uint16_t messageArraySendCount = 0;
uint16_t messageArraySize = 0;

uint8_t sysexMessageInProgress = 0;
uint8_t pedalHiRes = 0;

uint8_t bufCount = 0;
volatile uint8_t sendingMessage = 0;
volatile uint8_t sendKnobs = 0;
uint32_t currentFloat = 0;
uint32_t mapCount = 0;

uint16_t valsCount = 0;
uint16_t mapCountExpectation = 0;
uint16_t numMappings = 0;
volatile uint8_t parseThatMF = 0;
volatile float valCheck = 0.0f;
volatile float testVal = 0.0f;

uint8_t sendFirmwareUpdateRequest = 0;

uint8_t numStrings = 10;
/*
#define TUNING_ARRAY_SIZE 258
uint8_t tuningArray[TUNING_ARRAY_SIZE];
*/

volatile uint8_t usbActivityCounter = 0u;
uint8_t midiMsg[4];
uint8_t currentVBUS = 0;
uint8_t prevVBUS = 0;
volatile uint8_t USB_active = 0;
volatile uint8_t USB_check_flag = 0;

uint8_t mappingArray[6];

uint8_t inBuffer[myBufferSize];

uint8_t myArray[myBufferSize];
uint8_t returnedData[myBufferSize];
int octave = 5;
uint16_t angle[NUM_PEDALS];
uint16_t prevAngle[NUM_PEDALS];

uint16_t ADC_values[4];
uint16_t rawAngle = 0;
uint16_t midiSent = 0;
uint16_t midiOverflow = 0;

uint8_t macroKnobValues[NUM_MACROS*NUM_MACRO_PAGES];

uint8_t currentCopedent = 0;
uint8_t necks[2] = {0,1};
uint8_t neckPreset[2] = {0,1};
uint8_t neckPresetsByte;

uint8 rx1Channel, rx2Channel __attribute__((aligned(32)));
uint8 rx1TD[2], rx2TD[2]  __attribute__((aligned(32)));

volatile uint8 txChannel __attribute__((aligned(32)));
volatile uint8 txTD __attribute__((aligned(32)));

volatile uint8 rx3Channel __attribute__((aligned(32)));
volatile uint8 rx3TD __attribute__((aligned(32)));


volatile uint8 rxBufferPluck[2][PLUCK_BUFFER_SIZE] __attribute__((aligned(32)));
volatile uint8 rxBufferBar[2][BAR_BUFFER_SIZE] __attribute__((aligned(32)));

volatile uint16_t strings[12];
volatile uint16_t prevStrings[12];
volatile uint16_t bar[2];
volatile uint16_t prevBar[2];
volatile uint16_t maxStrings[12];
volatile uint8_t amHere = 0;
volatile uint8_t spiCounter = 0;
volatile uint8_t newDataFlag = 0;
int prevOctave = 0;
uint8_t pluck_index = 0;
volatile uint8_t amHere2 = 0;
volatile uint8_t spiCounter2 = 0;
volatile uint8_t newDataFlag2 = 0;
volatile uint8_t currentPluckBuffer = 0;
volatile uint8_t currentBarBuffer = 0;
volatile uint8_t pluckErrorCount = 0;
volatile uint16_t SPI1ErrorCount = 0;

volatile uint8_t inputData = 0;

union breakFloat {
 float f;
 uint8_t b[4];  
 uint32_t u32;
};


uint8_t spiAdjusted = 0;
uint8_t mySpiCounter = 0;
volatile uint16_t offsetErrorCount = 0;
volatile uint8_t SPI2errorflag = 0;
uint8_t knobs[4];
uint8_t prevKnobs[4];

uint8_t knobs7bit[4];
uint8_t prevKnobs7bit[4];

uint8_t u7bit_volumePedal = 0;
uint8_t prev_7bit_volumePedal = 0;
volatile uint8_t SPI2started = 0;

uint8_t whichMacro = 0;

uint8_t macroKnobValues7bit[NUM_MACROS*NUM_MACRO_PAGES];
uint8_t prevMacroKnobValues7bit[NUM_MACROS*NUM_MACRO_PAGES];
int16_t prevMacroKnobValues[NUM_MACROS*NUM_MACRO_PAGES];
uint8_t knobFrozen[NUM_MACROS*NUM_MACRO_PAGES];

uint8_t knobPanelLightActive = 0;

uint8_t bendRange = 0;
float bendScalingArray[2] = {1.0f, 2.0f};
float bendScaling = 1.0f;

static uint8 CYCODE eepromArray[]={ 0, 0 };
                                            
uint8 array[] ={ 0, 0 };
                                
    /*Return status for EEPROM and UART*/ 
cy_en_em_eeprom_status_t eepromReturnValue;


/* EEPROM storage in work flash, this is defined in Em_EEPROM.c*/
const uint8_t Em_EEPROM_em_EepromStorage[Em_EEPROM_PHYSICAL_SIZE] __ALIGNED(CY_FLASH_SIZEOF_ROW) = {0u};


uint8 eeprom_cnt;
cystatus status;
volatile const uint8 * ptr;
volatile int barCount = 0;


    
volatile uint8_t I2Cbuff1[256];
volatile uint8_t I2Cbuff2[16];
volatile uint8_t send_it = 0;

//first mux, 0x70 is first element of array. 
//If sent to output 5 of this first mux, signal goes to 
// the ethernet cable, and a second mux is in the foot pedal at the end of that cable. This channel is selected with the second element of the array
//so the order of I2C communication is ( foot pedals 1-5, knee levers 1-5, volume pedal, OLED display )
uint8_t mux_states[12][2] = {{5,0}, {5,1}, {5,2}, {5,3}, {5,4}, {0, 0}, {1, 0}, {3, 0}, {4, 0}, {2, 0}, {5, 5},{6,0}};
uint8_t i2c_skipped[12] = {0,0,0,0,0,0,0,0,0,0,0,0}; //so that pedals and levers can be marked as skipped if communication fails because they are unconnected
uint16_t pedals_low[10] = {2691, 2305, 2457, 526, 3738, 2307, 3014, 2190, 2793, 1318};
uint16_t pedals_high[10] = {2797, 2405, 2580, 647, 3854, 2461, 3141, 2353, 2934, 1504};
uint16_t pedals_lowWithDeadZone[10] = {2691, 2305, 2457, 526, 3738, 2307, 3014, 2190, 2793, 1318};
uint16_t pedals_highWithDeadZone[10] = {2797, 2405, 2580, 647, 3854, 2461, 3141, 2353, 2934, 1504};
uint8_t deadZone = 51;
uint16_t volumePedal = 4095;
uint16_t processed_pedals[NUM_PEDALS];
uint16_t prev_processed_pedals[NUM_PEDALS];
uint8_t pedals8bit[NUM_PEDALS];
uint8_t pedals7bit[NUM_PEDALS];
uint8_t prevPedals7bit[NUM_PEDALS];
int16_t prev_processed_volumePedal;
int16_t processed_volumePedal;

uint8_t sliderBugOn = 0;

uint16_t fretMeasurements[NUM_SLIDERS][NUM_FRET_MEASUREMENTS];



uint8_t currentPresetSelection = 0;
uint8_t presetNamesArray[MAX_NUM_PRESETS][PRESET_NAME_LENGTH_IN_BYTES];
uint8_t presetNumberToLoad = 0;
uint8_t presetLoadedResponse[2] = {255, 0};

uint8_t macroNamesArray[MAX_NUM_PRESETS][NUM_MACROS*NUM_MACRO_PAGES][MACRO_NAME_LENGTH_IN_BYTES];
uint8_t controlNamesArray[MAX_NUM_PRESETS][NUM_CONTROLS][CONTROL_NAME_LENGTH_IN_BYTES];

//frets 0, 1, 3, 5, 7, 9, 12, 15, 17, 19, 21, 24
float fretScalingInMIDI[NUM_FRET_MEASUREMENTS] = {0.0f, 1.0f, 3.0f, 5.0f, 7.0f, 9.0f, 12.0f, 15.0f, 17.0f, 19.0f, 21.0f, 24.0f};
float fretScalingInRatios[NUM_FRET_MEASUREMENTS] = {1.0f, 1.0594634453327456842756554370605f, 1.189207702260446000456655757668f, 1.3348390317611599217250391775256f, 1.4983069131880974498816337538581f, 1.6817915789332059656510887918682f, 2.0f, 2.378415404520892000913311515336f, 2.6696780635223198434500783550512f, 2.9966138263761948997632675077163f, 3.3635831578664119313021775837364f, 4.0f};

float pedalRatios[NUM_PEDALS];
uint8_t last_mux = 1;
volatile uint8_t main_counter = 0;
uint8_t dualSlider = 0;
uint8_t voice = 0; //unused for now

uint8_t patchNum = 0;

uint8_t pedal_inverted[NUM_PEDALS] = {0,0,0,0,0,0,0,0,0,0};

uint8_t traditionalPedalAdd = 0;
uint8_t copedentMapping[10] = {4, 5, 6, 7, 8, 10, 9, 3, 1, 2};
float copedent[MAX_NUM_COPEDENTS][NUM_PEDALS+1][NUM_STRINGS];
uint8_t copedentNamesArray[MAX_NUM_COPEDENTS][COPEDENT_NAME_LENGTH_IN_BYTES];

float prevStringPitchBend[NUM_STRINGS];

float pedals[NUM_PEDALS][NUM_STRINGS];

uint8_t pedal_cc_assignments[NUM_PEDALS] = {0, 1, 2, 3, 4, 8, 9, 7, 6, 5};
float openStringFrequencies[NUM_STRINGS];
float stringMappedPositionsInRatios[NUM_SLIDERS];
uint16_t stringMappedPositionsInRatiosInt[NUM_SLIDERS];
float stringMappedPositionsInMIDI[NUM_SLIDERS];
uint16_t barMidiOuterStrings[2];
float stringFrequencies[NUM_STRINGS];
float stringOctave[NUM_STRINGS];
float stringPitch[NUM_STRINGS];
float stringMIDI[NUM_STRINGS];
int openStringMIDI_Int[NUM_STRINGS];

uint8_t mainOLEDWaitingToSend = 0;
uint8_t macroOLEDWaitingToSend = 0;

uint8_t presetAlreadyDisplayed[MAX_NUM_PRESETS];

uint8_t currentNeck = 0;
uint8_t neckByte = 0;

uint8_t editMode = 0;
uint8_t leverCalibrationMode = 0;
uint8_t fretCalibrationMode = 0;

uint8_t presetWhenMacroWriteStarted = 0;
uint8_t macroPageWhenMacroWriteStarted = 0;

float pedals_float[NUM_PEDALS] = {0.0f, 0.0f, 0.0f, 0.0f, 0.0f, 0.0f, 0.0f, 0.0f, 0.0f, 0.0f};
float stringRepDivider = 1.0f;

//function prototypes
uint8 I2C_MasterWriteBlocking(uint8 i2CAddr, uint16 nbytes, uint8_t mode);
uint8 I2C_MasterReadBlocking(uint8 i2CAddr, uint8 nbytes, uint8_t mode);
void USB_service(void);
void checkUSB_Vbus(void);
void sendMIDIAllNotesOff(void);
void sendMIDIPitchBend(int val, int channel);
void firstCheckUSB_Vbus(void);
void restartSystemCheck(void);
void sendMIDINoteOn(int MIDInoteNum, int velocity, int channel);
void sendMIDIControlChange(int CCnum, int CCval, int channel);
void noteEvent(int string);
void I2C_reset(void);
void CCEvent(int cc, int val);
void DmaRxConfiguration(void);
void DmaTxConfiguration(void);
void parseSysex(void);

//helper functions
float map(float value, float istart, float istop, float ostart, float ostop)
{
    return ostart + (ostop - ostart) * ((value - istart) / (istop - istart));
}

float mapDualSlider(float value, float ostart, float ostop)
{
    return ostart + (ostop - ostart) * ((value - stringRepresentation[0]) * stringRepDivider);
}

void burnInitialPedalZeroPositions()
{
    for (int i = 0; i < 5; i++)
    {
        I2C_1_MasterSendStart(0x70, 0); 
        I2C_1_MasterWriteByte(1<<i);
        I2C_1_MasterSendStop(); 


        I2C_1_MasterSendStart(0x36, 0); 
        I2C_1_MasterWriteByte(0x0C);
        //I2C_1_MasterSendStop();
        I2C_1_MasterSendRestart(0x36, 1); 
        rawAngle = I2C_1_MasterReadByte(1) << 8;
        //I2C_1_MasterSendRestart(0x36, 1);
        rawAngle +=  I2C_1_MasterReadByte(0);
         I2C_1_MasterSendStop(); 
        
        CyDelay(1);

        I2C_1_MasterSendStart(0x36, 0); 
        I2C_1_MasterWriteByte(0x01);
        I2C_1_MasterWriteByte(rawAngle >> 8);
        I2C_1_MasterWriteByte(rawAngle & 0xff);
        I2C_1_MasterWriteByte((rawAngle+500) >> 8);
        I2C_1_MasterWriteByte((rawAngle+500) & 0xff);
        I2C_1_MasterSendStop(); 
        
        CyDelay(2);

        I2C_1_MasterSendStart(0x36, 0); 
        I2C_1_MasterWriteByte(0xff);
       I2C_1_MasterWriteByte(0x80);
        I2C_1_MasterSendStop(); 
       CyDelay(2);
    }
    
    //set main i2c mux
    for (int i = 0; i < 4; i++)
    {
        I2C_1_MasterSendStart(0x71, 0); 
        I2C_1_MasterWriteByte(1<<(i+2));
        I2C_1_MasterSendStop(); 


        I2C_1_MasterSendStart(0x36, 0); 
        I2C_1_MasterWriteByte(0x0C);
        //I2C_1_MasterSendStop();
        I2C_1_MasterSendRestart(0x36, 1); 
        rawAngle = I2C_1_MasterReadByte(1) << 8;
        //I2C_1_MasterSendRestart(0x36, 1);
        rawAngle +=  I2C_1_MasterReadByte(0);
        I2C_1_MasterSendStop(); 
        
        CyDelay(1);

        I2C_1_MasterSendStart(0x36, 0); 
        I2C_1_MasterWriteByte(0x01);
        I2C_1_MasterWriteByte(rawAngle >> 8);
        I2C_1_MasterWriteByte(rawAngle & 0xff);
        I2C_1_MasterWriteByte((rawAngle+700) >> 8);
        I2C_1_MasterWriteByte((rawAngle+700) & 0xff);
        I2C_1_MasterSendStop(); 
        
        CyDelay(2);

        I2C_1_MasterSendStart(0x36, 0); 
        I2C_1_MasterWriteByte(0xff);
        I2C_1_MasterWriteByte(0x80);
        I2C_1_MasterSendStop(); 
       CyDelay(2);
    }
}

void calculatePedalRatios(void)
{
    //add deadzones on edges of pedal sensing
    for (int i = 0; i < NUM_PEDALS; i++)
    {

        float pedalDiff =(float)pedals_high[i] - (float)pedals_low[i]; //temporary diff to calculate deadzone
        float deadZoneFloat = ((float)deadZone) * 0.002f * pedalDiff;
        pedals_lowWithDeadZone[i] = (float)pedals_low[i] + deadZoneFloat;
        pedals_highWithDeadZone[i] = (float)pedals_high[i] - deadZoneFloat;
        pedalDiff = pedals_highWithDeadZone[i] - pedals_lowWithDeadZone[i]; //final diff to calculate ratio
        pedalRatios[i] = 4095.0f / pedalDiff;
    }
}
void calculateStringRepDivider(void)
{
    stringRepDivider = (stringRepresentation[1] - stringRepresentation[0]);
    if (stringRepDivider == 0.0f)
    {
        stringRepresentation[0] = 2;
        stringRepresentation[1] = 7;
        stringRepDivider = (stringRepresentation[1] - stringRepresentation[0]);
    }
    if (!sliderBugOn)
    {
        stringRepDivider = (1.0f / stringRepDivider);
    }
}

float unsafeFtom(float f)
{
    return (17.3123405046f * logf(.12231220585f * f));
}


//a check for when a usb cable is plugged in and it needs to restart only once
void restartSystemCheck()
{
    eepromReturnValue = Em_EEPROM_Read(0u, eepromArray, 2u);
    //only do the restart check if there is a USB cable plugged in (to avoid restarting while trying to debug without a usb cable plugged in)
    if (USB_VBusPresent() == 1)
    {
        if (*(volatile uint8 *) &eepromArray[0] == 1u)
        {
            //a flag says we just restarted
            //write a zero so it knows next time that it's OK to restart
            array[0] = 0;
            Em_EEPROM_Write(0u,array,2u);     
            USB_check_flag = 1;
        }
        else
        {
           //otherwise, we need to restart
           array[0] = 1;
           Em_EEPROM_Write(0u,array,2u);  
            USB_Stop();
            I2C_1_Stop();
            CySoftwareReset();
        }
    }
}

//ISRs

//this ISR should happen when a USB cable is plugged in or unplugged.
CY_ISR(Vbus_function)
{
    //plug or unplug event
    //check if eeprom has a flag saying you just restarted. If so, don't restart again
    //otherwise, restart
    my_Vbus_ISR_ClearPending();
    vBusPin_ClearInterrupt();
    restartSystemCheck();

}

//This one happens when the Bar slider buffer gets filled by SPI
CY_ISR(spis_2_ss)
{

    currentBarBuffer = !currentBarBuffer;
    SPIS_2_ClearRxBuffer();
    CyDmaClearPendingDrq(rx2Channel);

    //set up the next DMA transaction
    CyDmaTdSetConfiguration(rx2TD[currentBarBuffer], BAR_BUFFER_SIZE, DMA_DISABLE_TD, TD_INC_DST_ADR | DMA_2__TD_TERMOUT_EN);
    CyDmaTdSetAddress(rx2TD[currentBarBuffer], LO16((uint32) SPIS_2_RXDATA_PTR), LO16((uint32) rxBufferBar[currentBarBuffer]));
    CyDmaChSetInitialTd(rx2Channel, rx2TD[currentBarBuffer]);
    CyDmaChEnable(rx2Channel, 1);
}

CY_ISR(spis_1_ss)
{
    currentPluckBuffer = !currentPluckBuffer;

    if ((rxBufferPluck[!currentPluckBuffer][0] == 254) && (rxBufferPluck[!currentPluckBuffer][31] == 253)) 
    {
        for (int i = 0 ; i < numStrings; i++)
        {
            strings[i] = ((rxBufferPluck[!currentPluckBuffer][(i*2)+1] << 8) + rxBufferPluck[!currentPluckBuffer][i*2+2]);
        }
    }
    SPIS_1_ClearRxBuffer();
    CyDmaClearPendingDrq(rx1Channel);

    //set up the next DMA transaction

    CyDmaTdSetConfiguration(rx1TD[currentPluckBuffer], PLUCK_BUFFER_SIZE, DMA_DISABLE_TD, TD_INC_DST_ADR | DMA_1__TD_TERMOUT_EN);
    CyDmaTdSetAddress(rx1TD[currentPluckBuffer], LO16((uint32) SPIS_1_RXDATA_PTR), LO16((uint32) rxBufferPluck[currentPluckBuffer]));
    CyDmaChSetInitialTd(rx1Channel, rx1TD[currentPluckBuffer]);
    CyDmaChEnable(rx1Channel, 1);

}

void loadEEPROMdefaults(void)
{
    EEPROM_WriteByte(0, EEPROM_CURRENT_PRESET_OFFSET);
    EEPROM_WriteByte(0, EEPROM_NECKS_OFFSET);
    EEPROM_WriteByte((int8_t)0, EEPROM_TRANSPOSE_OFFSET);
    EEPROM_WriteByte((int8_t)0, EEPROM_TRANSPOSE_OFFSET+1);
    EEPROM_WriteByte(1, EEPROM_MIDI_SEND_OFFSET);
    EEPROM_WriteByte(0,EEPROM_NECK_PRESETS_OFFSET);
    EEPROM_WriteByte(0,EEPROM_PEDALSUM_OFFSET);
    EEPROM_WriteByte(64,EEPROM_DEADZONES_OFFSET);
    EEPROM_WriteByte(0,EEPROM_OCTAVE_ACTION_OFFSET);
    EEPROM_WriteByte(39,EEPROM_STRING_REP_OFFSET);// (strings 3 and 8)
    EEPROM_WriteByte(0,EEPROM_DUAL_SLIDER_OFFSET);
    EEPROM_WriteByte(64,EEPROM_VOLUME_OFFSET);
}


int main(void)
{
    
	CYGlobalIntEnable; 
    EEPROM_Start();
     #ifdef BOOTLOAD_STYLE
     //since we sucessfully booted this firmware, set it to be the default until the brain chip gets a new firmware command from the synth chip
    Bootloadable_SET_RUN_TYPE(Bootloadable_SCHEDULE_BTLDB);
    #endif

    
    eepromReturnValue = Em_EEPROM_Init((uint32_t)Em_EEPROM_em_EepromStorage);
    if(eepromReturnValue != CY_EM_EEPROM_SUCCESS)
    {
       // HandleError();
    }
    sysexMessageStartPoints[sysexMessageStartPointsWritePosition] = 0;
    I2C_1_Start();  
    USB_SetPowerStatus(USB_DEVICE_STATUS_SELF_POWERED);
    my_Vbus_ISR_StartEx(Vbus_function);
    
    
        //set up for the OLED screen's first write
    I2Cbuff1[0] = 1<<6;
    status = I2C_MasterWriteBlocking(0x70, 1, I2C_1_MODE_COMPLETE_XFER);
    myGFX_init(128, 64);
    myGFX_setFont(0);
    OLED_init(128, 64);
    //OLEDwriteInt(currentCopedent , 2, 0,FourthLine);
    OLEDwriteString("ELECTROSTEEL", 12, 0, FirstLine);
    OLEDwriteFixedFloat(versionNumber, 3, 2, 16, SecondLine);
    //OLEDwriteString((char *)&copedentNamesArray[currentCopedent][0], COPEDENT_NAME_CLIPPED_LENGTH, OLEDgetCursor(), FourthLine);
    OLED_draw(128, 64);
    
    
    I2Cbuff1[0] = 1<<2;
    status = I2C_MasterWriteBlocking(0x70, 1, I2C_1_MODE_COMPLETE_XFER);
    
    CyDelay(10);
    //read from eeprom all the stored user settings
    
    //check if this is the first time it's ever booted up, in which case there will be no copedents loaded)
    if (EEPROM_ReadByte(EEPROM_COPEDENT_OFFSET) == 0)
    {
        loadEEPROMdefaults();
        
    }
    patchNum = EEPROM_ReadByte(EEPROM_CURRENT_PRESET_OFFSET);
    neckByte = EEPROM_ReadByte(EEPROM_NECKS_OFFSET);
    necks[0] = (neckByte >> 5) & 7;
    necks[1] = (neckByte >> 2) & 7;
    currentNeck = neckByte & 1;
    transposeSemitones = (int8_t)EEPROM_ReadByte(EEPROM_TRANSPOSE_OFFSET);
    transposeCents = (int8_t)EEPROM_ReadByte(EEPROM_TRANSPOSE_OFFSET + 1);
    transposeFloat = ((float)transposeSemitones) + (((float)transposeCents) * 0.01f);
    midiSendOn = EEPROM_ReadByte(EEPROM_MIDI_SEND_OFFSET)&1;
    midiBarSendOn = EEPROM_ReadByte(EEPROM_MIDI_SEND_OFFSET)&(1<<1);
    bendRange = EEPROM_ReadByte(EEPROM_MIDI_SEND_OFFSET)&(1<<2);
    bendScaling = bendScalingArray[bendRange];
    neckPreset[0] =  EEPROM_ReadByte(EEPROM_NECK_PRESETS_OFFSET);
    neckPreset[1] =  EEPROM_ReadByte(EEPROM_NECK_PRESETS_OFFSET+1);
    traditionalPedalAdd = EEPROM_ReadByte(EEPROM_PEDALSUM_OFFSET) & 1;
    deadZone = EEPROM_ReadByte(EEPROM_DEADZONES_OFFSET);
    octaveAction = EEPROM_ReadByte(EEPROM_OCTAVE_ACTION_OFFSET);
    stringRepresentation[0] = (EEPROM_ReadByte(EEPROM_STRING_REP_OFFSET)>>4) & 15; //first 4 bits of the byte
    stringRepresentation[1] = EEPROM_ReadByte(EEPROM_STRING_REP_OFFSET) & 15;//last 4 bits of the byte
    calculateStringRepDivider();
    dualSlider = EEPROM_ReadByte(EEPROM_DUAL_SLIDER_OFFSET) & 1;
    volumeInt = (int8_t) EEPROM_ReadByte(EEPROM_VOLUME_OFFSET);
    uint16_t pedal_inverted_byte = (EEPROM_ReadByte(EEPROM_PEDAL_INVERTED_OFFSET) << 8) + EEPROM_ReadByte(EEPROM_PEDAL_INVERTED_OFFSET + 1);
    for (int i = 0; i < NUM_PEDALS; i++)
    {
        pedal_inverted[i] = pedal_inverted_byte & (1<<i);
    }
    for (int coped = 0; coped < MAX_NUM_COPEDENTS; coped++)
    {
        for (int letter = 0; letter < COPEDENT_NAME_LENGTH_IN_BYTES; letter++)
        {
               copedentNamesArray[coped][letter] = EEPROM_ReadByte(EEPROM_COPEDENT_OFFSET + (coped*COPEDENT_SIZE_IN_BYTES) + letter);
        }
        for (int i = 0; i < 11; i++)
    	{
    		int pedalStartLoc = (i*24);
            for (int j = 0; j < NUM_STRINGS; j++)
    		{
                
                int stringStartLoc = (j*2);
                uint16_t tempIntHigh = EEPROM_ReadByte(EEPROM_COPEDENT_OFFSET + stringStartLoc + pedalStartLoc + (coped*COPEDENT_SIZE_IN_BYTES) + COPEDENT_NAME_LENGTH_IN_BYTES);
                uint16_t tempIntLow = EEPROM_ReadByte(EEPROM_COPEDENT_OFFSET + stringStartLoc + pedalStartLoc + 1 + (coped*COPEDENT_SIZE_IN_BYTES)+ COPEDENT_NAME_LENGTH_IN_BYTES);
                copedent[coped][i][j] = (((float)((tempIntHigh << 8) + tempIntLow)) * 0.00390625f) - 128.0f;// (256 value range from -128 to 128, divided by 65536)
            }
    	}
    }

    
    for (int i = 0; i < NUM_PEDALS; i++)
    {
        pedals_low[i] = (EEPROM_ReadByte(EEPROM_LEVER_CALIBRATION_OFFSET + (i*4)) << 8) + (EEPROM_ReadByte(EEPROM_LEVER_CALIBRATION_OFFSET + ((i*4) + 1)) & 255);
        pedals_high[i] = (EEPROM_ReadByte(EEPROM_LEVER_CALIBRATION_OFFSET + ((i*4) + 2)) << 8) + (EEPROM_ReadByte(EEPROM_LEVER_CALIBRATION_OFFSET + ((i*4) + 3)) & 255);
    }
    calculatePedalRatios();
                
    
    for (int i = 0; i < NUM_FRET_MEASUREMENTS; i++)
    {
        fretMeasurements[0][i] = (EEPROM_ReadByte(EEPROM_FRET_CALIBRATION_OFFSET + (i*4)) << 8) + (EEPROM_ReadByte(EEPROM_FRET_CALIBRATION_OFFSET + ((i*4) + 1)) & 255);
        fretMeasurements[1][i] = (EEPROM_ReadByte(EEPROM_FRET_CALIBRATION_OFFSET + ((i*4) + 2)) << 8) + (EEPROM_ReadByte(EEPROM_FRET_CALIBRATION_OFFSET + ((i*4) + 3)) & 255);
    }
    //blank out the preset names array so that we can tell when we get the real names from the synth board sd card
    for (int i = 0; i < MAX_NUM_PRESETS; i++)
    {
        for (int j = 0; j < PRESET_NAME_LENGTH_IN_BYTES; j++)
        {
            presetNamesArray[i][j] = 255;

        }
        for (int j = 0; j < NUM_MACROS*NUM_MACRO_PAGES; j++)
        {
            for (int k = 0; k < MACRO_NAME_LENGTH_IN_BYTES; k++)
            {
                macroNamesArray[i][j][k] = 255;
            }
        }
        for (int j = 0; j < NUM_CONTROLS; j++)
        {
            for (int k = 0; k < CONTROL_NAME_LENGTH_IN_BYTES; k++)
            {
                controlNamesArray[i][j][k] = 255;
            }
        }
        presetAlreadyDisplayed[i] = 0;
    }
    LED_amber1_Write(0);
    LED_amber2_Write(1);
    LED_amber3_Write(0);
    LED_amber4_Write(0);
    LED_green1_Write(dualSlider);
    LED_red1_Write(currentNeck);
    LED_green2_Write(!currentNeck);
    ADC_SAR_Seq_1_Start();
    ADC_SAR_Seq_1_StartConvert();

            
    currentCopedent = necks[currentNeck];
    CyDelay(10);
    


    for (int w = 0; w < 8; w++)
    {
        I2Cbuff1[0] = (1 << 3) + w;
        status = I2C_MasterWriteBlocking(0x72, 1, I2C_1_MODE_COMPLETE_XFER); 
        OLED_init(128, 32);
    }

    //initialize the macro knob adc to scan all knobs
    I2Cbuff1[0] = 1<<2;
    status = I2C_MasterWriteBlocking(0x70, 1, I2C_1_MODE_COMPLETE_XFER);
    main_counter = 9;

    I2Cbuff1[0] = 0xf; //message says scan single-ended mode from beginning to 8th knob (scan all knobs)
    status = I2C_MasterWriteBlocking(0x35, 1, I2C_1_MODE_COMPLETE_XFER);
    

    SPIS_1_Start();  
    SPIM_1_Start();  
    SPIS_2_Start(); 
    DmaTxConfiguration();
    DmaRxConfiguration();
    isr_SPI1_ss_StartEx(spis_1_ss);
    isr_SPI2_ss_StartEx(spis_2_ss);
    
    myArray[30] = 254;
    myArray[31] = 253;

    main_counter = 0;
    //burnInitialPedalZeroPositions();
	for(;;)
    {
        
        if (parseThatMF)
        {
            parseSysex();
        }
       
        //testpin3_Write(1);
       //sense levers and pedals
        if (mux_states[main_counter][0] != last_mux)
        {
            I2Cbuff1[0] = 1<<mux_states[main_counter][0];
            if (mux_states[main_counter][0] == 5) //slow down I2C communication if it's going through the differential signaling on the ethernet cable (can't do 1000k on that IC)
            {
                Clock_2_SetDividerValue(13); //slow speed 400k
            }
            else
            {
                Clock_2_SetDividerValue(5); //otherwise full speed 1000k
            }
            uint8_t status = I2C_MasterWriteBlocking(0x70, 1, I2C_1_MODE_COMPLETE_XFER);
        }
        last_mux = mux_states[main_counter][0];
        
        
        CyDelayUs(10);
        if (mux_states[main_counter][0] == 5)
        {
            if (!i2c_skipped[main_counter])
            {
                I2Cbuff1[0] = 1<<mux_states[main_counter][1];
                status = I2C_MasterWriteBlocking(0x71, 1, I2C_1_MODE_COMPLETE_XFER);
            }
        }

        CyDelayUs(10);
        //if it's a hall sensor

        if (main_counter < 10)
        {
            if (!i2c_skipped[main_counter])
            {
                //CyDelayUs(100);
                I2Cbuff1[0] = 0x0E;
                status = I2C_MasterWriteBlocking(0x36, 1, I2C_1_MODE_NO_STOP);
                if (status == 0)
                {
                    status = I2C_MasterReadBlocking(0x36, 2, I2C_1_MODE_REPEAT_START);
                }
                if (status  == 0)
                {
                    //CyDelayUs(100);
                    angle[main_counter] = I2Cbuff2[0] << 8;
                    angle[main_counter] +=  I2Cbuff2[1];
                    
                    if (leverCalibrationMode)
                    {
                        if (angle[main_counter] < pedals_low[main_counter])
                        {
                            if (main_counter == 0)
                            {
                                if (angle[main_counter] != 0)
                                {
                                     pedals_low[main_counter] = angle[main_counter];
                                     
                                }
                            }
                            else
                            {
                                pedals_low[main_counter] = angle[main_counter];
                               
                            }
                            
                        }
                        if (angle[main_counter] > pedals_high[main_counter])
                        {
                             pedals_high[main_counter] = angle[main_counter];
                             
                        }
                    }
                }
            }
        }
        
        //in addition to the hall sensor on {2,0} (the vertical knee lever) of the muxes, there is also the knob/oled board, so scan that as well on main counter round 9
        if (main_counter == 9)
        {
            if (!i2c_skipped[main_counter])
            {
                //scan the knob adc
                I2Cbuff1[0] = 0x0;      
                status = I2C_MasterReadBlocking(0x35, 16, I2C_1_MODE_COMPLETE_XFER);
                if (status == 0)
                {
                    for (int i = 0; i < 8; i++)
                    {
                       uint8_t myKnob = i+whichMacroPageIsActive;
                        uint16_t tempInt =((I2Cbuff2[i*2] << 8) + (I2Cbuff2[(i*2) + 1] & 255)) & 4095; // necessary to AND with 4095 to eliminate the 4 preceding bits set high by default
                        int16_t tempSquished = 255 - (tempInt >> 4);
                        if (knobFrozen[myKnob] == 1)
                        {
                            if ((tempSquished > prevMacroKnobValues[myKnob] + 4) || (tempSquished < prevMacroKnobValues[myKnob] - 4))
                            {
                                //update
                                macroKnobValues[myKnob] = tempSquished;
                                knobFrozen[myKnob] = 0;
                            }
                        }
                        else
                        {
                            macroKnobValues[myKnob] = tempSquished; //now squish it down to 8 bit for sending (also subtract from 255 because the pot is backwards for some reason
                            if (midiSendOn)
                            {
                                macroKnobValues7bit[myKnob] = macroKnobValues[myKnob] >> 1;
                                if (macroKnobValues7bit[myKnob] != prevMacroKnobValues7bit[myKnob])
                                {
                                    sendMIDIControlChange(i+1 + (3*whichMacroPageIsActive), macroKnobValues7bit[myKnob], 0);//first 8 are 1-8 second page is 25-32
                                }
                                prevMacroKnobValues7bit[myKnob] = macroKnobValues7bit[myKnob];
                            }
                            prevMacroKnobValues[myKnob] =  tempSquished;
                        }

                    }
                    //
                    if (macroOLEDWaitingToSend == 2)
                    {
                        //send the data to the little macro OLED screens
                        
                        I2Cbuff1[0] = (1 << 3) + whichMacro;
                        status = I2C_MasterWriteBlocking(0x72, 1, I2C_1_MODE_COMPLETE_XFER); 
                        //OLED_init(128, 32);
                        OLEDclear(128, 32);
                        //OLEDwriteInt(w , 1, 0,FirstLine);
                        //OLEDwriteString(" ", 1, OLEDgetCursor(), FourthLine);
                        myGFX_setFont(1);
                         //make sure we didn't switch stuff while the display was updating
                        if ((presetWhenMacroWriteStarted != patchNum)  || (macroPageWhenMacroWriteStarted != whichMacroPageIsActive))
                        {
                            whichMacro = 0;
                        }
                        //GFXsetFont(&theGFX,  &SourceCodePro_Regular14pt7b);
                        OLEDwriteLineMiddle((char *)&macroNamesArray[patchNum][whichMacro+whichMacroPageIsActive][0], MACRO_NAME_CLIPPED_LENGTH);
                        OLED_draw(128, 32);

                        whichMacro++;
                        if (whichMacro >= NUM_MACROS)
                        {
                            macroOLEDWaitingToSend = 0;
                            whichMacro = 0;
                           

                        }
                    }
                }
            }
            
        }
        //otherwise it's the ADC for the foot pedal
        else if (main_counter == 10)
        {
            //0x4f (0x4D?) is the 7=-bit version of the MCP3221 address, might need to be shifted over by 1 to the left
            if (!i2c_skipped[main_counter])
            {
                I2Cbuff1[0] = 0x0;      
                status = I2C_MasterReadBlocking(0x4f, 2, I2C_1_MODE_COMPLETE_XFER);
                if (status == 0)
                {
                    volumePedal = I2Cbuff2[0] << 8;
                    volumePedal +=  I2Cbuff2[1];
                }
            }
        }
        else
        if (main_counter == 11)
        { 
            if (mainOLEDWaitingToSend)
            {
                OLED_draw(128, 64);
                mainOLEDWaitingToSend = 0;
            }
            if (macroOLEDWaitingToSend == 1)
            {
                macroOLEDWaitingToSend = 2;
                presetWhenMacroWriteStarted = patchNum;
                macroPageWhenMacroWriteStarted = whichMacroPageIsActive;
            }
        }

       
        
        if (main_counter < 10)
        {
            
            //do math to make all pedals and levers report between 0 and 4095 scaled
            int16_t tempangle = ((int16_t) angle[main_counter] - (int16_t)pedals_lowWithDeadZone[main_counter]);
            
            if (tempangle > 0)
            {
                processed_pedals[main_counter] = (float)tempangle * pedalRatios[main_counter];
            }
            else
            {
                processed_pedals[main_counter] = 0;
            }
            if (processed_pedals[main_counter] > 4095)
            {
                processed_pedals[main_counter] = 4095;
            }
            //invert the ones that are sensing rotation backwards
            if (pedal_inverted[main_counter])
            {
                processed_pedals[main_counter] = 4095 - processed_pedals[main_counter];
            }
            
            //if ( processed_pedals[main_counter] != prev_processed_pedals[main_counter])
            {
                //sendMIDIControlChange(main_counter, (processed_pedals[main_counter] >> 7), 1);
                //sendMIDIControlChange(main_counter+36, (processed_pedals[main_counter] & 127), 1);
            }
            pedals_float[main_counter] = (float)processed_pedals[main_counter] * 2.442002442002442e-4f;
            pedals8bit[main_counter] = (float)processed_pedals[pedal_cc_assignments[main_counter]] * 0.0625f;
            if (midiSendOn)
            {
                pedals7bit[main_counter] = pedals8bit[main_counter] >> 1;
                if (pedals7bit[main_counter] != prevPedals7bit[main_counter])
                {
                    sendMIDIControlChange(main_counter + 14, (pedals7bit[main_counter]), 1);
                }
                prevPedals7bit[main_counter] = pedals7bit[main_counter];
            }
            prev_processed_pedals[main_counter] = processed_pedals[main_counter];
        }
        else
        {
            processed_volumePedal = (float)volumePedal * 1.007378258730939f; //compensate for lower than full scale voltage readings

            if (processed_volumePedal < 0)
            {
                processed_volumePedal = 0;
            }
            else if (processed_volumePedal > 4095)
            {
                 processed_volumePedal = 4095;
            }
            if (midiSendOn)
            {
                if (!pedalHiRes)
                {
                    u7bit_volumePedal = processed_volumePedal >> 5;
                    if ( u7bit_volumePedal != prev_7bit_volumePedal)
                    {
                        uint16_t tempPedal = processed_volumePedal;
                        
                        sendMIDIControlChange(13, u7bit_volumePedal, 0);
                        //sendMIDIControlChange(24, (tempPedal & 32), 0); //remaining 5 bits for 4096 resolution
                    }
                     //prev_processed_volumePedal = processed_volumePedal;
                    prev_7bit_volumePedal = u7bit_volumePedal;
                }
                else
                {
                    
                    if ( processed_volumePedal != prev_processed_volumePedal)
                    {
                        u7bit_volumePedal = processed_volumePedal >> 5;
                        uint8_t tempPedal = ((uint16_t)processed_volumePedal) & 32;
                        
                        sendMIDIControlChange(13, u7bit_volumePedal, 0);
                        sendMIDIControlChange(24, tempPedal, 0); //remaining 5 bits for 4096 resolution
                    }
                    prev_processed_volumePedal = processed_volumePedal;
                    //prev_7bit_volumePedal = u7bit_volumePedal;
                }
            }
        }
        
        main_counter++;

        if (main_counter > 11)
        {
            main_counter = 0;
        }
        //testpin3_Write(0);

       // testpin5_Write(1);
        
        if ((rxBufferBar[!currentBarBuffer][6] == 254) && (rxBufferBar[!currentBarBuffer][7] == 253))
        {
            for (int i = 0; i < NUM_SLIDERS; i++)
            {
                bar[i] = ((rxBufferBar[!currentBarBuffer][i*2] << 8) + rxBufferBar[!currentBarBuffer][(i*2)+1]);    
                //
                if(bar[i] != prevBar[i])
                {
    				if (midiDebugSendOn)
                    {
                        sendMIDIControlChange(34+(i*3), bar[i] & 127, 1);
                        sendMIDIControlChange(33+(i*3), (bar[i] >> 7) & 127, 1);
                        sendMIDIControlChange(32+(i*3), (bar[i] >> 14) & 127, 1);
                    }
                    if ((bar[i] == 65535) || (bar[i] > fretMeasurements[i][0]))
    				{
    					stringMappedPositionsInRatios[i] = 1.0f;
    				}
                    else if (bar[i] > fretMeasurements[i][NUM_FRET_MEASUREMENTS-1])
                    {
                        for (int j = 0; j < NUM_FRET_MEASUREMENTS-1; j++)
                        {
                            if ((bar[i] <=  fretMeasurements[i][j]) && (bar[i] >  fretMeasurements[i][j+1]))
                            {
                                stringMappedPositionsInRatios[i] = map((float)bar[i], fretMeasurements[i][j], fretMeasurements[i][j+1], fretScalingInRatios[j], fretScalingInRatios[j + 1]);
                                if (midiDebugSendOn)
                                {
                                    sendMIDIControlChange(44, j, 1);
                                }
                                break;
                            }
                        }
                    }
                    else
                    {
                        stringMappedPositionsInRatios[i] = map((float)bar[i], fretMeasurements[i][NUM_FRET_MEASUREMENTS-2], fretMeasurements[i][NUM_FRET_MEASUREMENTS-1], fretScalingInRatios[NUM_FRET_MEASUREMENTS-2], fretScalingInRatios[NUM_FRET_MEASUREMENTS-1]);
                    }
                    stringMappedPositionsInRatiosInt[i] = stringMappedPositionsInRatios[i]*16384.0f;
                    if (midiDebugSendOn)
                    {
                        sendMIDIControlChange(40+(i*3), stringMappedPositionsInRatiosInt[i] & 127, 1);
                        sendMIDIControlChange(39+(i*3), (stringMappedPositionsInRatiosInt[i] >> 7) & 127, 1);
                        sendMIDIControlChange(38+(i*3), (stringMappedPositionsInRatiosInt[i] >> 14) & 127, 1);
                    }
                }
                //
                prevBar[i] = bar[i];
            }
        }
        
        //testpin5_Write(0);
        if (midiSendOn)
        {
            for (int i = 0 ; i < numStrings; i++)
            {
                if (strings[i] != prevStrings[i])
                {
                    noteEvent(i);
                }
                prevStrings[i] = strings[i];
            }
        }
       
        scanUI();
        
        for (int i=  0; i < 4; i++)
        {
            knobs[i] = (ADC_SAR_Seq_1_GetResult16(i)>>4); //divide by 16
            if (i != 2) // all are backwards except X axis
            {
                knobs[i] = 255 - knobs[i];
            }
            if (midiSendOn)
            {
                knobs7bit[i] = knobs[i] >> 1;
                
                if (knobs7bit[i] != prevKnobs7bit[i])
                {
                    sendMIDIControlChange(i+9, knobs7bit[i], 0);
                }
                prevKnobs7bit[i] = knobs7bit[i];
            }
            
        }
        
        //testpin4_Write(1);
        //calculate the pitch of each string based on the current Copedent
        for (int i = 0; i < numStrings; i++)
    	{
    		//interpolate ratios for each of the strings
           
            float myMappedPos;
            if (dualSlider)
            {
               if ((bar[0] != 65535) && (bar[1] != 65535))
                {
                    myMappedPos = mapDualSlider(i, stringMappedPositionsInRatios[0], stringMappedPositionsInRatios[1]);
                }
                else if (bar[0] != 65535)
                {
                    myMappedPos = stringMappedPositionsInRatios[0];
                }
                else
                {
                    myMappedPos = stringMappedPositionsInRatios[1];
                }
            }
            else
            {
                myMappedPos = stringMappedPositionsInRatios[0];
            }

            float pedalsMIDI = 0.0f;
    		//then apply those ratios to the fundamental frequencies
            if (!traditionalPedalAdd)
            {
    		    pedalsMIDI = (copedent[currentCopedent][0][i] +
                        (copedent[currentCopedent][4][i] * pedals_float[0]) +
                        (copedent[currentCopedent][5][i] * pedals_float[1]) +
                        (copedent[currentCopedent][6][i] * pedals_float[2]) +
                        (copedent[currentCopedent][7][i] * pedals_float[3]) +
                        (copedent[currentCopedent][8][i] * pedals_float[4]) +
                        (copedent[currentCopedent][10][i] * pedals_float[5]) +
                        (copedent[currentCopedent][9][i] * pedals_float[6]) +
                        (copedent[currentCopedent][3][i] * pedals_float[7]) +
                        (copedent[currentCopedent][1][i] * pedals_float[8]) +
                        (copedent[currentCopedent][2][i] * pedals_float[9])) + transposeFloat;
                if (i == 0)
                {
                    uint16_t pedalsMIDIInt = pedalsMIDI * 512.0f;
                    if (midiDebugSendOn)
                    {
                        sendMIDIControlChange(47+(i*3), pedalsMIDIInt & 127, 1);
                        sendMIDIControlChange(46+(i*3), (pedalsMIDIInt >> 7) & 127, 1);
                        sendMIDIControlChange(45+(i*3), (pedalsMIDIInt >> 14) & 127, 1);
                    }
                }
            }
            else
            {
                float pedalsMIDIUp = 0.0f;
                float pedalsMIDIDown = 0.0f;
                
                
                for (int j = 0; j < 10; j++)
                {
                    float tempMIDI = copedent[currentCopedent][copedentMapping[j]][i] * pedals_float[j];
                    if (tempMIDI > pedalsMIDIUp)
                    {
                        pedalsMIDIUp = tempMIDI;
                    }
                    else if (tempMIDI < pedalsMIDIDown)
                    {
                        pedalsMIDIDown = tempMIDI;
                    }
                }
                float openStringTemp = copedent[currentCopedent][0][i];
                
                pedalsMIDI = pedalsMIDIUp + pedalsMIDIDown + openStringTemp + transposeFloat;
                
            }
            
            float openStringMIDI  = copedent[currentCopedent][0][i];
            openStringMIDI_Int[i] = (int)openStringMIDI;
            float barMIDI = (unsafeFtom(myMappedPos*55.0f)) - 33.0f; //give midi note added by the bar position starting from 0 (55Hz is low A, midinote 33)
            if (i == 0)
            {
                barMidiOuterStrings[0] = (uint16_t)(barMIDI * 512.0f);
            }

            else if (i == 5) //the average bar position for single midi bar position report via channel 13 pitch bend
            {
                if (midiBarSendOn)
                {
                    float barBend = (uint16_t)(barMIDI * 128.0f);
                    if (midiBarSendOn)
                    {
                        sendMIDIPitchBend((uint)barBend,12);
                    }
                }
            }
            else if (i == (numStrings - 1))
            {
                 barMidiOuterStrings[1] = (uint16_t)(barMIDI * 512.0f);
            }
            
            float computerMIDIOffset = barMIDI + pedalsMIDI - openStringMIDI_Int[i];// + stringOctave[i];
            
            if (midiDebugSendOn)
            {
                if (i == 0)
                {
                        uint16_t barMIDIInt = barMIDI * 512.0f;
                        sendMIDIControlChange(50, barMIDIInt & 127, 1);
                        sendMIDIControlChange(49, (barMIDIInt >> 7) & 127, 1);
                        
                        sendMIDIControlChange(48, (barMIDIInt >> 14) & 127, 1);
                        uint16_t openStringMIDI_Int2 = openStringMIDI_Int[0] * 512.0f;
                        sendMIDIControlChange(53, openStringMIDI_Int2 & 127, 1);
                        sendMIDIControlChange(52, (openStringMIDI_Int2 >> 7) & 127, 1);
                        sendMIDIControlChange(51, (openStringMIDI_Int2 >> 14) & 127, 1);
                }
            }
            
            
            
            float pitchBendAmount = (computerMIDIOffset * 170.6666666666667f * bendScaling) + 8192.0f;  // 14bit number divide by 2 for signed, then divided by 48 for 48 semitones up/down range
            if (midiSendOn)
            {
                if (pitchBendAmount != prevStringPitchBend[i])
                {
                    sendMIDIPitchBend((uint)pitchBendAmount, i+1);
                }
            }
            prevStringPitchBend[i] = pitchBendAmount;
            
            if (pedalsMIDI > 0.0f)
            {
                stringMIDI[i] = pedalsMIDI + barMIDI;
            }
    	}
       // testpin4_Write(0);

        
        if (USB_check_flag)
        {
            checkUSB_Vbus();
        }
        //only service the USB bus if there is a computer plugged in
        if ((USB_active) && (USB_VBusPresent()))
        {
            if (midiSent > 64)
            {
                midiOverflow++;
            }
            midiSent = 0;
            USB_service();
        }

        
        //make sure previous SPI2 transmission has completed before transferring the remaining midi data
        while (0u == ((SPIM_1_ReadTxStatus() & SPIM_1_STS_SPI_DONE) || (SPIM_1_ReadTxStatus() & SPIM_1_STS_SPI_IDLE )))
        {
            ;
        }
        //testpin6_Write(1);
        if (sendingMessage == 1) //sending synthesis preset to synth board
        {
            if (sendMessageEnd) //send end message
            {
                myArray[0] = 253;
                myArray[1] = presetNumberToWrite;
                currentPresetSelection = presetNumberToWrite;
                //display previous preset as loaded
                displayCurrentPresetNameAndCopedent();
                //OLED_invert(0);
                sendMessageEnd = 0;
                sendingMessage = 0;
                messageArraySendCount = 0;
                myArray[30] = 254;
                myArray[31] = 253;
                
            }
            else //send chunks
            {
                //send the next preset Chunkkkkk
                myArray[0] = 2;
                myArray[1] = presetNumberToWrite;
                for (uint i = 2 ; i < myBufferSize-2; i++)
                {
                    if (messageArraySendCount < messageArraySize)
                    {
                        myArray[i] = presetArray[messageArraySendCount++];
                    }
                    else
                    {
                        myArray[i] = 0xee; // preset end ack   - done, next send a message that s
                        sendMessageEnd = 1;
                    }
                }
                myArray[30] = 254;
                myArray[31] = 253;
            }    
        }
        
        else if (sendSingleParamUpdate)
        {
            myArray[0] = 6;
            myArray[1] = singleParamToUpdateHigh;
            myArray[2] = singleParamToUpdateLow;
            myArray[3] = singleParamValueHigh;
            myArray[4] = singleParamValueLow;
            myArray[30] = 254;
            myArray[31] = 253;
            sendSingleParamUpdate = 0;
        }
        
        else if (sendMappingChangeUpdate)
        {
            myArray[0] = 7;
            myArray[1] = mappingArray[0];
            myArray[2] =  mappingArray[1];
            myArray[3] =  mappingArray[2];
            myArray[4] =  mappingArray[3];
            myArray[5] =  mappingArray[4];
            myArray[6] =  mappingArray[5];
            myArray[30] = 254;
            myArray[31] = 253;
            sendMappingChangeUpdate = 0;
        }
        else if (volumeWaitingToSend)
        {
            myArray[0] = 10;
            myArray[1] = volumeInt;
            myArray[30] = 254;
            myArray[31] = 253;
            volumeWaitingToSend = 0;
        }
        
        else if (sendFirmwareUpdateRequest == 1)
        {
            myArray[0] = 11;
            myArray[1] = 0;
            myArray[30] = 254;
            myArray[31] = 253;
            sendFirmwareUpdateRequest = 0;
        }
        else if (sendFirmwareUpdateRequest == 2)
        {
            myArray[0] = 12;
            myArray[1] = 0;
            myArray[30] = 254;
            myArray[31] = 253;
            sendFirmwareUpdateRequest = 0;
        }
        
        else if (sendLocalPresetStoreCommand == 1)
        {
            myArray[0] = 14;
            myArray[1] = presetNumberToStore;
            myArray[2] = 17;
            myArray[3] = 18;
            myArray[4] = 1;
            myArray[5] = 1;
            myArray[30] = 254;
            myArray[31] = 253;
            for (int i = 0; i < 14; i++)
            {
                 myArray[i+6] = newPresetName[i];
            }
            sendLocalPresetStoreCommand = 0;
            patchNum = presetNumberToStore;
            EEPROM_WriteByte(patchNum, EEPROM_CURRENT_PRESET_OFFSET);
            neckPreset[currentNeck] = patchNum;
            EEPROM_WriteByte(patchNum, EEPROM_NECK_PRESETS_OFFSET + currentNeck);
            presetAlreadyDisplayed[presetNumberToStore] = 0;
        }
        
        else if (sendKnobs)
        {
            if (whichMacroPageIsActive == 0)
            {
                myArray[0] = 3; //sending knob stuff, not a preset send
            }
            else
            {
                myArray[0] = 13; //sending additional knob stuff, not a preset send
            }
            for (int i = 0; i < 8; i++)
            {
                myArray[i + 1] = macroKnobValues[i+whichMacroPageIsActive];
            }
            for (int i = 0; i < 4; i++)
            {
                myArray[i + 9] = knobs[i];
            }
            for (int i = 0; i < 10; i++)
            {
                myArray[i + 13] = pedals8bit[i];
            }
            myArray[24] = octave | (voice << 4) | (dualSlider << 5) | (octaveAction << 6);
            myArray[25] = patchNum;
            myArray[26] = processed_volumePedal >> 8;
            myArray[27] = processed_volumePedal & 0xff;
            myArray[28] = barMidiOuterStrings[1] >> 8;
            myArray[29] = barMidiOuterStrings[1] & 0xff;
            myArray[30] = 254;
            myArray[31] = 253;
            
            
            sendKnobs = 0;
        }
        else
        {
            myArray[0] = 1; //sending normal pitch stuff, not a preset send
            for (int i = 0; i < 12; i++)
            {
                int scaledMIDI = roundf(stringMIDI[i] * 512.0f); // divide by 128 multiply by 65535
                myArray[i * 2 + 1] = scaledMIDI >> 8;
                myArray[(i * 2) + 2] = scaledMIDI & 255;
            }
            
            myArray[24] = octave | (voice << 4) | (dualSlider << 5) | (octaveAction << 6);
            myArray[25] = patchNum;
            myArray[26] = processed_volumePedal >> 8;
            myArray[27] = processed_volumePedal & 0xff;
            myArray[28] = barMidiOuterStrings[0] >> 8;
            myArray[29] = barMidiOuterStrings[0] & 0xff;
            myArray[30] = 254;
            myArray[31] = 253;
            
            sendKnobs = 1; // for next time around, might make this slower though
        }

        //parse input from synth board (names)
        if ((inBuffer[0] == 253) && (inBuffer[31] == 254))
        {
            int whichPresetToStoreName = inBuffer[1];
            int whichMacroToStoreName = inBuffer[16];
            int bufferPointer = 2;
            for (int i = 0; i < PRESET_NAME_LENGTH_IN_BYTES; i++)
            {
                presetNamesArray[whichPresetToStoreName][i] = inBuffer[bufferPointer];
                bufferPointer++;
            }
            bufferPointer = 17;
            if (whichMacroToStoreName < 8)
            {
                for (int i = 0; i < MACRO_NAME_LENGTH_IN_BYTES; i++)
                {
                    macroNamesArray[whichPresetToStoreName][whichMacroToStoreName][i] = inBuffer[bufferPointer];
                    bufferPointer++;
                }
            }
            else if (whichMacroToStoreName < 12) //if it's macro #8-12 it's actually a control knob , subtract 8 from the number of which macro and store it in the control knob name array
            {
                for (int i = 0; i < CONTROL_NAME_LENGTH_IN_BYTES; i++)
                {
                    controlNamesArray[whichPresetToStoreName][(whichMacroToStoreName - 8)][i] = inBuffer[bufferPointer];
                    bufferPointer++;
                }
            }
            else
            {
                for (int i = 0; i < MACRO_NAME_LENGTH_IN_BYTES; i++)
                {
                    macroNamesArray[whichPresetToStoreName][whichMacroToStoreName - 4][i] = inBuffer[bufferPointer];
                    bufferPointer++;
                }
            }
            if ((whichPresetToStoreName == patchNum) && (whichMacroToStoreName == 7) && (!presetAlreadyDisplayed[whichPresetToStoreName]))
            {
                displayCurrentPresetNameAndCopedent();
            }
        }
        else if ((inBuffer[0] == 252) && (inBuffer[31] == 254))
        {
            //oop this means we're about to get new firmware. Reset to bootloader
            SPIM_1_Stop();
            myGFX_setFont(0);
            OLEDwriteString("FIRMWARE   ", 11, 1, FirstLine);
            OLEDwriteString("UPDATE     ", 11, 1, SecondLine);
            OLEDwriteString("           ", 11, 1, ThirdLine);
            OLEDwriteString("           ", 11, 1, FourthLine);
            main_counter = 11;
                   //set muxes to write to main OLED
            if (mux_states[main_counter][0] != last_mux)
            {
                I2Cbuff1[0] = 1<<mux_states[main_counter][0];
                uint8_t status = I2C_MasterWriteBlocking(0x70, 1, I2C_1_MODE_COMPLETE_XFER);
            }
            last_mux = mux_states[main_counter][0];
            
            
            CyDelayUs(10);
            if (mux_states[main_counter][0] == 5)
            {
                if (!i2c_skipped[main_counter])
                {
                    I2Cbuff1[0] = 1<<mux_states[main_counter][1];
                    status = I2C_MasterWriteBlocking(0x71, 1, I2C_1_MODE_COMPLETE_XFER);
                }
            }

            CyDelayUs(10);

            OLED_draw(128, 64);
            #ifdef BOOTLOAD_STYLE
            Bootloadable_Load();
                #endif
        }
        
        SPIM_1_ClearRxBuffer();
        CyDmaChEnable(rx3Channel, STORE_TD_CFG_ONCMPLT);
        CyDmaChEnable(txChannel, STORE_TD_CFG_ONCMPLT);
        
       // testpin6_Write(0);
       

     }
}

void DmaTxConfiguration()
{
    /* Init DMA, 1 byte bursts, each burst requires a request */ 
    txChannel = DMA_4_DmaInitialize(DMA_TX_BYTES_PER_BURST, DMA_TX_REQUEST_PER_BURST, 
                                        HI16(DMA_TX_SRC_BASE), HI16(DMA_TX_DST_BASE));

    txTD = CyDmaTdAllocate();

    /* Configure this Td as follows:
    *  - Increment the source address, but not the destination address   
    */
    CyDmaTdSetConfiguration(txTD, myBufferSize, CY_DMA_DISABLE_TD, TD_INC_SRC_ADR);

    /* From the memory to the SPIM */
    CyDmaTdSetAddress(txTD, LO16((uint32)myArray), LO16((uint32) SPIM_1_TXDATA_PTR));
    
    /* Associate the TD with the channel */
    CyDmaChSetInitialTd(txChannel, txTD); 
   
} 

void DmaRxConfiguration()
{ 
    //pluck dma
    rx1Channel = DMA_1_DmaInitialize(DMA_RX_BYTES_PER_BURST, DMA_RX_REQUEST_PER_BURST,
                                     HI16(DMA_RX_SRC_BASE), HI16(DMA_RX_DST_BASE));
    rx1TD[0] = CyDmaTdAllocate();
    rx1TD[1] = CyDmaTdAllocate();
    CyDmaTdSetConfiguration(rx1TD[0], PLUCK_BUFFER_SIZE, DMA_DISABLE_TD , TD_INC_DST_ADR | DMA_1__TD_TERMOUT_EN);
    CyDmaTdSetConfiguration(rx1TD[1], PLUCK_BUFFER_SIZE, DMA_DISABLE_TD, TD_INC_DST_ADR | DMA_1__TD_TERMOUT_EN);
    CyDmaTdSetAddress(rx1TD[0], LO16((uint32) SPIS_1_RXDATA_PTR), LO16((uint32) rxBufferPluck[0]));
    CyDmaTdSetAddress(rx1TD[1], LO16((uint32) SPIS_1_RXDATA_PTR), LO16((uint32) rxBufferPluck[1]));

    //bar dma
    rx2Channel = DMA_2_DmaInitialize(DMA_RX_BYTES_PER_BURST, DMA_RX_REQUEST_PER_BURST,
                                     HI16(DMA_RX_SRC_BASE), HI16(DMA_RX_DST_BASE));
    rx2TD[0] = CyDmaTdAllocate();
    rx2TD[1] = CyDmaTdAllocate();
    CyDmaTdSetConfiguration(rx2TD[0], BAR_BUFFER_SIZE, DMA_DISABLE_TD, TD_INC_DST_ADR | DMA_2__TD_TERMOUT_EN);
    CyDmaTdSetConfiguration(rx2TD[1], BAR_BUFFER_SIZE, DMA_DISABLE_TD, TD_INC_DST_ADR | DMA_2__TD_TERMOUT_EN);
    CyDmaTdSetAddress(rx2TD[0], LO16((uint32) SPIS_2_RXDATA_PTR), LO16((uint32) rxBufferBar[0]));
    CyDmaTdSetAddress(rx2TD[1], LO16((uint32) SPIS_2_RXDATA_PTR), LO16((uint32) rxBufferBar[1]));
    
        /* Init DMA, 1 byte bursts, each burst requires a request */ 
    rx3Channel = DMA_3_DmaInitialize(DMA_RX_BYTES_PER_BURST, DMA_RX_REQUEST_PER_BURST,
                                     HI16(DMA_RX_SRC_BASE), HI16(DMA_RX_DST_BASE));

    rx3TD = CyDmaTdAllocate();
    
    /* Configure this Td as follows:
    *  - Increment the destination address, but not the source address
    */
    CyDmaTdSetConfiguration(rx3TD, myBufferSize, CY_DMA_DISABLE_TD, TD_INC_DST_ADR);

    /* From the SPIM to the memory */
    CyDmaTdSetAddress(rx3TD, LO16((uint32)SPIM_1_RXDATA_PTR), LO16((uint32)inBuffer));

    /* Associate the TD with the channel */
    CyDmaChSetInitialTd(rx3Channel, rx3TD);
}

uint8 I2C_MasterWriteBlocking(uint8 i2CAddr, uint16 nbytes, uint8_t mode)
{
    uint8 volatile status;
    uint8_t error = 0;
    uint32_t timeout = 1000;
    status = I2C_1_MasterClearStatus();
    if(!(status & I2C_1_MSTAT_ERR_XFER))
    {
        status = I2C_1_MasterWriteBuf(i2CAddr, (uint8 *)&I2Cbuff1, nbytes,
                                     mode);
        if(status == I2C_1_MSTR_NO_ERROR)
        {
            /* wait for write complete and no error */
            do
            {
                status = I2C_1_MasterStatus();
                timeout--;
                if (status == I2C_1_MSTAT_ERR_XFER)
                {
                    I2C_reset();
                    error = 1;
                }
                if (timeout == 0)
                {
                    status = I2C_1_MSTAT_ERR_XFER;
                    I2C_reset();
                    error = 1;
                }
                
                if (status == 0)
                {
                    status = I2C_1_MSTAT_ERR_XFER;
                    I2C_reset();
                    error = 1;
                }
                
            } while(((status & (I2C_1_MSTAT_WR_CMPLT | I2C_1_MSTAT_ERR_XFER)) == 0u) && (status != 0u) && (timeout>0));
        }
        else
        {
            /* translate from I2CM_MasterWriteBuf() error output to
            *  I2CM_MasterStatus() error output */
            status = I2C_1_MSTAT_ERR_XFER;
            I2C_reset();
            error = 1;
        } 
    }  
    if ((status & I2C_1_MSTAT_ERR_ADDR_NAK) || (status & I2C_1_MSTAT_ERR_XFER))
    {
        //mark that i2c destination to be skipped (likely unplugged) and reset the I2C module
        //i2c_skipped[main_counter] = 1;
        I2C_reset();
        error = 1;
    }
    return error;
}

uint8 I2C_MasterReadBlocking(uint8 i2CAddr, uint8 nbytes, uint8_t mode)
{
    uint8 volatile status;
    uint32_t timeout = 50000;
    uint8_t error = 0;
    status = I2C_1_MasterClearStatus();
    if(!(status & I2C_1_MSTAT_ERR_XFER))
    {
        status = I2C_1_MasterReadBuf(i2CAddr,
                                   (uint8 *)&(I2Cbuff2),
                                    nbytes, mode); 
        if(status == I2C_1_MSTR_NO_ERROR)
        {
            /* wait for read complete and no error */
            do
            {
                status = I2C_1_MasterStatus();
                timeout--;
                if (status == I2C_1_MSTAT_ERR_XFER)
                {
                    I2C_1_GENERATE_STOP_MANUAL;
                    I2C_reset();
                    error = 1;
                }
                if (timeout == 0)
                {
                    status = I2C_1_MSTAT_ERR_XFER;
                    I2C_reset();
                    error = 1;
                }
            } while(((status & (I2C_1_MSTAT_RD_CMPLT | I2C_1_MSTAT_ERR_XFER)) == 0u) && (status != 0u) && (timeout>0));
        }
        else
        {
            /* translate from I2CM_MasterReadBuf() error output to
            *  I2CM_MasterStatus() error output */
            status = I2C_1_MSTAT_ERR_XFER;
            I2C_reset();
            error = 1;
        }
    }
    if ((status & I2C_1_MSTAT_ERR_ADDR_NAK) || (status & I2C_1_MSTAT_ERR_XFER))
    {
        //mark that i2c destination to be skipped (likely unplugged) and reset the I2C module
        //i2c_skipped[main_counter] = 1;
        I2C_reset();
        error = 1;
    }
    return error;
}

void I2C_reset(void)
{
  I2C_1_Stop();

  /* Disable/clear everything, then reinitialize. */

  I2C_1_CFG_REG = 0x00;  // NECESSARY to get MCSR to reset and clear BUS_BUSY bit.

  //I2C_1_XCFG_REG = 0x00;  // not sure if necessary.

  I2C_1_initVar = 0;  // MUST BE SET TO ZERO to allow I2C_1_Start() to call I2C_1_Init()

  I2C_1_Start();
}


    
void checkUSB_Vbus(void)
{
   if (USB_VBusPresent() == 0)
   {
       USB_Stop();
       USB_active = 0; 
   }
   else if (USB_active == 0 )
   {
       USB_Start(0u, USB_3V_OPERATION ); 
        while (0u == USB_GetConfiguration());
        USB_MIDI_EP_Init();
       USB_active = 1;
   }
   USB_check_flag = 0;
}



void USB_service(void)
{
    if(USB_IsConfigurationChanged() != 0u)
    {
        if(USB_GetConfiguration() != 0u)   
        {
           // Sleep_isr_StartEx(SleepIsr_function);
            
            //SleepTimer_Start();
        	
            if ((USB_active) && (USB_VBusPresent()))
            {
                USB_MIDI_EP_Init();
            }
        }
        else
        {
            //SleepTimer_Stop();
        }    
    }        
    
    if(USB_GetConfiguration() != 0u)    
    {

         /* Reinitialize after SET_CONFIGURATION or SET_INTERFACE Requests */
        if(USB_IsConfigurationChanged() != 0x00)
        {
            USB_LoadInEP(USB_midi_in_ep, USB_midiInBuffer,(uint16) USB_midiInPointer);
            //USB_LoadInEP(USB_midi_in_ep, USB_midiInBuffer, 64);
            USB_ReadOutEP(USB_midi_out_ep,USB_midiOutBuffer, 64);
                                             /* configuring the DMAs for the first time only, the data as soon as received
                                             in the EP buffer is Transferred by DMA to the buffer as defined here with no CPU intervention */
            USB_EnableOutEP(USB_midi_out_ep);       /* Note 3.*/
        }
        if ((USB_active) && (USB_VBusPresent()))
        {
            USB_MIDI_IN_Service();
        }



        if ((USB_active) && (USB_VBusPresent()))
        {
            USB_MIDI_OUT_Service();
        }
    }
        
}

// This is a fast approximation to log2()
// Y = C[0]*F*F*F + C[1]*F*F + C[2]*F + C[3] + E;
float log2f_approx(float X) {
  float Y, F;
  int E;
  F = frexpf(fabsf(X), &E);
  Y = 1.23149591368684f;
  Y *= F;
  Y += -4.11852516267426f;
  Y *= F;
  Y += 6.02197014179219f;
  Y *= F;
  Y += -3.13396450166353f;
  Y += E;
  return(Y);
}



int prevNotes[NUM_STRINGS] = {0,0,0,0,0,0,0,0,0,0,0,0};

void noteEvent(int string)
{
    
    /*
    float tempAmp = strings[string] * 1.5259021896696421759365224689097e-5f;//divide by 65535
    float v = 127.0f + (64.0f * log10f_fast(tempAmp));
    int vInt  = (int) (v*4.0f);
    if (vInt > 127)
    {
        vInt = 127;
    }
    */
    uint16_t velocity = strings[string];
    if (velocity > 0)
    {
        //velocity = (((sqrtf((float)velocity) * 0.00001525878903f) - .0239372430f) * 130.114584436252734f);
        float tempVel = (float)velocity;
        tempVel = tempVel * 0.00001525878903f;
        tempVel = sqrtf(tempVel);
        tempVel = tempVel - 0.0239372430f;
        tempVel = tempVel * 130.114584436252734f;
        velocity = (int)tempVel;
        

        if (velocity > 127)
        {
            velocity = 127;
        }
        
        //only update octave on note-ons
        //stringOctave[string] = powf(2.0f,octave);
        int noteToSend = ((octave - 5) * 12) + openStringMIDI_Int[string];
        sendMIDINoteOn(noteToSend , ((uint8_t)velocity), string+1);
        prevNotes[string] = noteToSend;
            
    }
    else
    {
        sendMIDINoteOn(prevNotes[string], 0, string+1);
    }

}

void CCEvent(int cc, int val)
{
    
    sendMIDIControlChange(cc, val, 0);
}

void sendMIDINoteOn(int MIDInoteNum, int velocity, int channel)
{  
   
    midiMsg[0] = USB_MIDI_NOTE_ON + channel;
    midiMsg[1] = MIDInoteNum;
    midiMsg[2] = velocity;	
    if ((USB_active) && (USB_VBusPresent()))
    {
        USB_PutUsbMidiIn(3u, midiMsg, USB_MIDI_CABLE_00);
    } 
    midiSent += 4;
}

void sendMIDIPolyKeyPressure(int MIDInoteNum, int pressure, int channel)
{
    midiMsg[0] = USB_MIDI_POLY_KEY_PRESSURE + channel;
    midiMsg[1] = MIDInoteNum;
    midiMsg[2] = pressure;		
    if ((USB_active) && (USB_VBusPresent()))
    {
        USB_PutUsbMidiIn(3u, midiMsg, USB_MIDI_CABLE_00);
    } 
    midiSent += 4;
}

void sendMIDIControlChange(int CCnum, int CCval, int channel)
{
    midiMsg[0] = USB_MIDI_CONTROL_CHANGE + channel;
    midiMsg[1] = CCnum;
    midiMsg[2] = CCval;			
    if ((USB_active) && (USB_VBusPresent()))
    {
        USB_PutUsbMidiIn(3u, midiMsg, USB_MIDI_CABLE_00);
    } 
    midiSent += 4;
}

void sendMIDIPitchBend(int val, int channel)
{
    midiMsg[0] = USB_MIDI_PITCH_BEND_CHANGE + channel;
    midiMsg[1] = (val & 127); //LSB
    midiMsg[2] = (val >> 7);	//MSB		
    if ((USB_active) && (USB_VBusPresent()))
    {
        USB_PutUsbMidiIn(3u, midiMsg, USB_MIDI_CABLE_00);
    } 
    midiSent += 4;
}

void sendMIDIAllNotesOff(void)
{   
    for (uint8_t i = 0; i < 128; i++)
    {
        midiMsg[0] = USB_MIDI_NOTE_ON;
        midiMsg[1] = i;
        midiMsg[2] = 0;	
        if ((USB_active) && (USB_VBusPresent()))
        {       
            USB_PutUsbMidiIn(3u, midiMsg, USB_MIDI_CABLE_00);
        }
    }
}




volatile uint8_t checkStatus = 0;
volatile uint16_t checkBase = 0;
volatile uint8_t tempMIDI[4];
volatile uint8_t firstSysex = 0;
const uint32_t sysexPointerMask = 2047;
volatile uint32_t moreToDo = 0;

int SPI_errors = 0;

volatile uint32_t nearbyValues[16];

void parseSysex(void)
{
    parsingSysex = 1;
    
    uint32_t messageStart = sysexMessageStartPoints[sysexMessageStartPointsReadPosition];
    uint32_t messageEnd = sysexMessageStartPoints[(sysexMessageStartPointsReadPosition + 1)];
    sysexMessageStartPointsReadPosition++; //get ready for next one
    sysexReadPointer = messageStart;
    for (int i = 0; i < 16; i++)
    {
        nearbyValues[i]= sysexBuffer[(sysexReadPointer-8+i) &sysexPointerMask];
    }
    //0 = it's a preset
    if (sysexBuffer[sysexReadPointer & sysexPointerMask] == 0)
    {
        sysexMessageInProgress = 1; // set a flag that we've started a sysex preset transfer. May take multiple sysex parse calls on the chunks to complete
        currentFloat = 0;
        presetArraySection = presetName;
        presetNumberToWrite = sysexBuffer[(sysexReadPointer+1) & sysexPointerMask];
        presetArray[0] = sysexBuffer[(sysexReadPointer+2) & sysexPointerMask];
        presetArray[1] = sysexBuffer[(sysexReadPointer+3) & sysexPointerMask];
        presetArray[2] = sysexBuffer[(sysexReadPointer+4) & sysexPointerMask];
        presetArray[3] = sysexBuffer[(sysexReadPointer+5) & sysexPointerMask];
        
        union breakFloat theVal;
        uint32_t i = 6;
        sysexReadPointer = i + sysexReadPointer;
        uint8_t stoppingPoint = PRESET_NAME_LENGTH_IN_BYTES+i;
        for (; i < stoppingPoint; i++)
        {
            presetArray[i-2] = sysexBuffer[sysexReadPointer & sysexPointerMask] & 127; // pass on the first 14 elements as 8-bit bytes (they are the chars for the name string)
            presetNamesArray[presetNumberToWrite][i-6] = sysexBuffer[sysexReadPointer & sysexPointerMask] & 127;
            sysexReadPointer++;
        }
        
        presetArraySection = macroNames;

        
        for (int j = 0; j < (NUM_MACROS); j++)
        {
            for (int k = 0; k < MACRO_NAME_LENGTH_IN_BYTES; k++)
            {
                presetArray[i-2] = sysexBuffer[sysexReadPointer & sysexPointerMask] & 127; // pass on the first 14 elements as 8-bit bytes (they are the chars for the name string)
                macroNamesArray[presetNumberToWrite][j][k] = sysexBuffer[sysexReadPointer & sysexPointerMask] & 127; // pass on the first 14 elements as 8-bit bytes (they are the chars for the name string)
                i++;
                sysexReadPointer++;
            }
        }
        for (int j = 0; j < NUM_CONTROLS; j++)
        {
            for (int k = 0; k < CONTROL_NAME_LENGTH_IN_BYTES; k++)
            {
                presetArray[i-2] = sysexBuffer[sysexReadPointer & sysexPointerMask] & 127; // pass on the first 14 elements as 8-bit bytes (they are the chars for the name string)
                controlNamesArray[presetNumberToWrite][j][k] = sysexBuffer[sysexReadPointer & sysexPointerMask] & 127; // pass on the first 14 elements as 8-bit bytes (they are the chars for the name string)
                 i++;
                sysexReadPointer++;
            }
        }
        
        uint16_t valsStart = 4 + PRESET_NAME_LENGTH_IN_BYTES + (MACRO_NAME_LENGTH_IN_BYTES * NUM_MACROS) + (CONTROL_NAME_LENGTH_IN_BYTES * NUM_CONTROLS);
        
        presetArraySection = initialVals;
        
        for (; sysexReadPointer < (messageEnd); sysexReadPointer = (sysexReadPointer+5))
        {
            theVal.u32 = 0;
            theVal.u32 |= ((sysexBuffer[sysexReadPointer & sysexPointerMask ] &15) << 28);
            theVal.u32 |= (sysexBuffer[(sysexReadPointer+1) & sysexPointerMask] << 21);
            theVal.u32 |= (sysexBuffer[(sysexReadPointer+2) & sysexPointerMask] << 14);
            theVal.u32 |= (sysexBuffer[(sysexReadPointer+3) & sysexPointerMask] << 7);
            theVal.u32 |= (sysexBuffer[(sysexReadPointer+4) & sysexPointerMask] & 127);
            testVal = theVal.f;
            if (presetArraySection == initialVals)
            {

                if (currentFloat == 0)
                {
                    valsCount = (uint16_t) theVal.f;
                    presetArray[valsStart + currentFloat++] = valsCount >> 8;
                    presetArray[valsStart + currentFloat++] = valsCount & 0xff;
                }
                else if (currentFloat < ((valsCount+1)*2))
                { 
                    uint16_t intVal = (uint16_t)(theVal.f * 65535.0f);
                    presetArray[valsStart + currentFloat++] = intVal >> 8;
                    presetArray[valsStart + currentFloat++] = intVal & 0xff;
                }
                else if (currentFloat == ((valsCount+1)*2))
                {
                    valCheck = theVal.f;
                    if ((valCheck < -1.5f) && (valCheck > -2.5f))
                    {
                        presetArray[valsStart + currentFloat++] = 0xef;
                        presetArray[valsStart + currentFloat++] = 0xef;
                        presetArraySection = mapCountNext;
                        mapCount = 0;
                    }
                    else
                    {
                        //error state
                        SPI_errors++;
                        sysexMessageInProgress = 0;
                        //sysexPointer = 0;
                        sendingMessage = 0;
                        parseThatMF = 0;
                    }
                }
            }
            else if (presetArraySection == mapCountNext)
            {
                mapCountExpectation = (uint16_t)theVal.f;
                presetArray[valsStart + currentFloat++] = mapCountExpectation >> 8;
                presetArray[valsStart + currentFloat++] = mapCountExpectation & 0xff;
                presetArraySection = mapping;
                numMappings = 0;
            }
            else if (presetArraySection == mapping)
            {
                // this is the order
                // source (int), target (int), scalarSource (arrives as -1.0f if no scalar, send as 255 if no scalar)(int), range (float -1.0 to 1.0), slot# (in uint8_t)
                if (numMappings < mapCountExpectation)
                {
                    if ((mapCount % 5) == 0)
                    {
                        presetArray[valsStart + currentFloat++] = (uint8_t)theVal.f;
                    }
                    else if  (mapCount % 5 == 1)
                    {
                        presetArray[valsStart + currentFloat++] = (uint8_t)theVal.f;
                    }
                    else if (mapCount % 5 == 2) //check if the scalar source is -1 (if so send 255 instead of a valid source number)
                    {
                        if (theVal.f < 0.0f)
                        {
                             presetArray[valsStart + currentFloat++] = 0xff;
                        }
                        else
                        {
                             presetArray[valsStart + currentFloat++] = (uint8_t)theVal.f;
                        }
                    }
                    else if (mapCount % 5 == 3)
                    {
                        int16_t intVal = (int16_t)(theVal.f * 32767.0f); //keep it signed to allow negative numbers
                        presetArray[valsStart + currentFloat++] = intVal >> 8;
                        presetArray[valsStart + currentFloat++] = intVal & 0xff;

                    }
                    else
                    {
                        presetArray[valsStart + currentFloat++] = (uint8_t)theVal.f;
                        numMappings++;
                    }
                    mapCount++;
                }
                

                else
                {
                    //mapcount ended
                    if ((theVal.f < -2.5f) && (theVal.f > -3.5f))
                    {
                        presetArray[valsStart + currentFloat++] = 0xfe;
                        presetArray[valsStart + currentFloat++] = 0xfe;
                        presetArraySection = presetEnd;
                        sysexMessageInProgress = 0;
                        sendingMessage = 1;
                        patchNum = presetNumberToWrite;
                        messageArraySize = valsStart + currentFloat;
                    }
                    else
                    {
                        //error state
                        SPI_errors++;
                        sysexMessageInProgress = 0;
                       // sysexPointer = 0;
                        sendingMessage = 0;
                        parseThatMF = 0;
                    }
                }
            }
            
        }
    }
    #if 0
    else if (sysexBuffer[0] == 1) //its a tuning
    {
        
        sysexMessageInProgress = 1; // set a flag that we've started a sysex preset transfer. May take multiple sysex parse calls on the chunks to complete
        currentFloat = 0;
        presetNumberToWrite = sysexBuffer[1];
        union breakFloat theVal;
        for (uint32_t i = 2; i < sysexPointer; i = i+5)
        {
            theVal.u32 = 0;
            theVal.u32 |= ((sysexBuffer[i] &15) << 28);
            theVal.u32 |= (sysexBuffer[i+1] << 21);
            theVal.u32 |= (sysexBuffer[i+2] << 14);
            theVal.u32 |= (sysexBuffer[i+3] << 7);
            theVal.u32 |= (sysexBuffer[i+4] & 127);
            testVal = theVal.f;
            uint16_t intVal = (uint16_t)(theVal.f * 512.0f);//(uint16_t)(theVal.f * 65535.0f);
            tuningArray[currentFloat++] = intVal >> 8;
            tuningArray[currentFloat++] = intVal & 0xff;
        }
        
        tuningArray[currentFloat++] = 0xef;
        tuningArray[currentFloat++] = 0xef;
                        
        
        messageArraySize = currentFloat;
                    
        if(messageArraySize != TUNING_ARRAY_SIZE)
        {
            //error state
            SPI_errors++;
            sysexMessageInProgress = 0;
            sysexPointer = 0;
            sendingMessage = 0;
            parseThatMF = 0;
        } else 
        {
            sysexMessageInProgress = 0;
            sendingMessage = 2;
        }
    }
    #endif
    

    
    else if (sysexBuffer[sysexReadPointer & sysexPointerMask] == 2) //its a copedent
    {
        sysexMessageInProgress = 1; // set a flag that we've started a sysex preset transfer. May take multiple sysex parse calls on the chunks to complete
        uint8_t ignore = 0;
        currentFloat = 0;
        copedentNumberToWrite = sysexBuffer[(messageStart+1) & sysexPointerMask];
        if (copedentNumberToWrite > 6)
        {
            //ignore, number is out of range
            sysexMessageInProgress = 0;
            // sysexPointer = 0;
            sendingMessage = 0;
            parseThatMF = 0;
            ignore = 1;
            
        }
        if (!ignore)
        {
            currentCopedent = copedentNumberToWrite;
            necks[currentNeck] = currentCopedent;
        }
              
        
        union breakFloat theVal;
        uint32_t i = 2;
        sysexReadPointer = i + messageStart;
        uint8_t stoppingPoint = COPEDENT_NAME_LENGTH_IN_BYTES + 2;
        for (; i < stoppingPoint; i++)
        {
            //presetArray[i-2] = sysexBuffer[i] & 127; // pass on the first 14 elements as 8-bit bytes (they are the chars for the name string)
            uint8_t tempChar = sysexBuffer[sysexReadPointer & sysexPointerMask] & 127;
            if (!ignore)
            {
                copedentNamesArray[copedentNumberToWrite][(i-2)] = tempChar;//not sure about the minus 2 part and mod
                checkBase = EEPROM_COPEDENT_OFFSET + (COPEDENT_SIZE_IN_BYTES * copedentNumberToWrite);
                checkStatus = EEPROM_WriteByte(tempChar, EEPROM_COPEDENT_OFFSET + (i - 2) + (COPEDENT_SIZE_IN_BYTES * copedentNumberToWrite));
            }
            sysexReadPointer++;
        }
        
        i = (COPEDENT_NAME_LENGTH_IN_BYTES + 2 + messageStart); // start after the name storage to store the actual values

 
        while(i < messageEnd)
        {
            for (uint32_t pedalToWrite = 0; pedalToWrite < 11; pedalToWrite++)
            {
                uint16_t pedalStartLoc = (pedalToWrite * 24);
                for (uint32_t stringChange = 0; stringChange < 12; stringChange++)
                {
                    
                    theVal.u32 = 0;
                    theVal.u32 |= ((sysexBuffer[i & sysexPointerMask] &15) << 28);
                    theVal.u32 |= (sysexBuffer[(i+1) & sysexPointerMask] << 21);
                    theVal.u32 |= (sysexBuffer[(i+2) & sysexPointerMask] << 14);
                    theVal.u32 |= (sysexBuffer[(i+3) & sysexPointerMask] << 7);
                    theVal.u32 |= (sysexBuffer[(i+4) & sysexPointerMask] & 127);
                    if (!ignore)
                    {
                        copedent[copedentNumberToWrite][pedalToWrite][stringChange] = theVal.f;
                    
                    
                        uint16_t tempIntVersion = (uint16_t)((theVal.f * 256.0f) + 32768.0f);
                        uint8_t tempHigh = tempIntVersion >> 8;
                        uint8_t tempLow = tempIntVersion & 255;
                    
                    
                        uint16_t stringStartLoc = stringChange * 2;
                        checkBase = EEPROM_COPEDENT_OFFSET + stringStartLoc + pedalStartLoc + (COPEDENT_SIZE_IN_BYTES * copedentNumberToWrite) + COPEDENT_NAME_LENGTH_IN_BYTES;
                        checkStatus = EEPROM_WriteByte(tempHigh, checkBase);
                        checkStatus = EEPROM_WriteByte(tempLow, checkBase+1);
                    }
                    currentFloat++;
                    i = (i+5);
                }
                
            }
        }
                        
        
        messageArraySize = currentFloat;
                    
        if(messageArraySize != COPEDENT_SIZE_IN_FLOATS)
        {
            //error state
            SPI_errors++;
            sysexMessageInProgress = 0;
           // sysexPointer = 0;
            sendingMessage = 0;
            parseThatMF = 0;
        } 
        else 
        {
            sysexMessageInProgress = 0;
            //sendingMessage = 2;  // use this when we are ready to send copedents to the sd cards too
            
            displayCurrentPresetNameAndCopedent();
        }
    }
    
    
    else if (sysexBuffer[sysexReadPointer & sysexPointerMask] == 3) //it's a real-time parameter change
    {
        sysexMessageInProgress = 1; // set a flag that we've started a sysex preset transfer. May take multiple sysex parse calls on the chunks to complete
        union breakFloat theVal;
        uint32_t i = (2+messageStart);
        
        //get the parameter ID
        theVal.u32 = 0;
        theVal.u32 |= ((sysexBuffer[i & sysexPointerMask] &15) << 28);
        theVal.u32 |= (sysexBuffer[(i+1) & sysexPointerMask] << 21);
        theVal.u32 |= (sysexBuffer[(i+2) & sysexPointerMask] << 14);
        theVal.u32 |= (sysexBuffer[(i+3) & sysexPointerMask] << 7);
        theVal.u32 |= (sysexBuffer[(i+4) & sysexPointerMask] & 127);
        uint16_t roundedIndex = (uint16_t)roundf(theVal.f);
        singleParamToUpdateHigh = (roundedIndex << 8);
        singleParamToUpdateLow = roundedIndex & 0xff;
        
        i = (i+5);
        
        //get the parameter value
        theVal.u32 = 0;
        theVal.u32 |= ((sysexBuffer[i & sysexPointerMask] &15) << 28);
        theVal.u32 |= (sysexBuffer[(i+1)& sysexPointerMask] << 21);
        theVal.u32 |= (sysexBuffer[(i+2)& sysexPointerMask] << 14);
        theVal.u32 |= (sysexBuffer[(i+3)& sysexPointerMask] << 7);
        theVal.u32 |= (sysexBuffer[(i+4)& sysexPointerMask] & 127);
        
        uint16_t intVal = (uint16_t)(theVal.f * 65535.0f);
        singleParamValueHigh = intVal >> 8;
        singleParamValueLow = intVal & 0xff;
        
        sysexMessageInProgress = 0;
        sendSingleParamUpdate = 1;
    }
    
     else if (sysexBuffer[sysexReadPointer & sysexPointerMask] == 4) //it's a real-time mapping change
    {
        sysexMessageInProgress = 1; // set a flag that we've started a sysex preset transfer. May take multiple sysex parse calls on the chunks to complete
        union breakFloat theVal;
        uint32_t i = (2 + messageStart);
        
        //get the destination number
        theVal.u32 = 0;
        theVal.u32 |= ((sysexBuffer[i & sysexPointerMask] &15) << 28);
        theVal.u32 |= (sysexBuffer[(i+1) & sysexPointerMask] << 21);
        theVal.u32 |= (sysexBuffer[(i+2) & sysexPointerMask] << 14);
        theVal.u32 |= (sysexBuffer[(i+3) & sysexPointerMask] << 7);
        theVal.u32 |= (sysexBuffer[(i+4) & sysexPointerMask] & 127);
        uint16_t roundedIndex = (uint16_t)roundf(theVal.f);
        mappingArray[0] = (roundedIndex << 8);
        mappingArray[1] = roundedIndex & 0xff;
        
        
        mappingArray[2] = sysexBuffer[(i+5) & sysexPointerMask]; //slot id
        mappingArray[3] = sysexBuffer[(i+6) & sysexPointerMask]; //mapping change type
        
        i = (i+7);
        
        //get the parameter value
        theVal.u32 = 0;
        theVal.u32 |= ((sysexBuffer[i & sysexPointerMask] &15) << 28);
        theVal.u32 |= (sysexBuffer[(i+1) & sysexPointerMask] << 21);
        theVal.u32 |= (sysexBuffer[(i+2) & sysexPointerMask] << 14);
        theVal.u32 |= (sysexBuffer[(i+3) & sysexPointerMask] << 7);
        theVal.u32 |= (sysexBuffer[(i+4) & sysexPointerMask] & 127);
        if (mappingArray[3] == 0) // source id
        {
            mappingArray[4] = 0;
            mappingArray[5] = (int16_t)(roundf(theVal.f));
        }
        else if (mappingArray[3] == 1) // amount
        {
            int16_t intVal = (int16_t)(theVal.f * 32767.0f);
            mappingArray[4] = intVal >> 8;
            mappingArray[5] = intVal & 0xff;
        }
        else // scalar source
        {
            mappingArray[4] = 0;
            mappingArray[5] = (int16_t)(roundf(theVal.f));
        }
        
        
        sysexMessageInProgress = 0;
        sendMappingChangeUpdate = 1;
    }

    parsingSysex = 0;
    if (sysexMessageStartPointsReadPosition == sysexMessageStartPointsWritePosition)
    {
        parseThatMF = 0;
    }
    else
    {
        moreToDo++;
    }
}


// this gets called if the Brain gets a MIDI message from the computer host
void USB_callbackLocalMidiEvent(uint8 cable, uint8 *midiMsg) CYREENTRANT
{   
    tempMIDI[0] = midiMsg[0];
    tempMIDI[1] = midiMsg[1];
    tempMIDI[2] = midiMsg[2];
    tempMIDI[3] = midiMsg[3];
    //check that we got here
    
    if ((USB_active) && (USB_VBusPresent()))
    {
        if (receivingSysex)
        {
            for (int i = 0; i < 3; i++)
            {
                if (midiMsg[i] < 128)
                {
                    sysexBuffer[(sysexWritePointer++) & sysexPointerMask] = midiMsg[i];
                    lastBufferStuff = masterTimer;
                    
                }
                else
                {
                    if (midiMsg[i] == USB_MIDI_EOSEX)
                    {
                        receivingSysex = 0;
                        lastEndReceive = masterTimer;

                        //parseSysex();
                        return;
                     }
                }
            }
            masterTimer++;
        }
        else if (midiMsg[USB_EVENT_BYTE0] == USB_MIDI_SYSEX)
        {
            if (!parsingSysex)
            {
                if (midiMsg[1] == 126) // special message saying that sysex multi-chunk transmission is finished. Parse it!
                {
                    parseThatMF = 1;
                    prevLastParseCall = lastParseCall;
                    lastParseCall = masterTimer;
                    sysexReset = 1;
                    sysexMessageStartPointsWritePosition++;
                    sysexMessageStartPoints[sysexMessageStartPointsWritePosition] = sysexWritePointer;
                    
                    //sysexPointer = 0;
                }
                else if (midiMsg[1] == 0 || midiMsg[1] == 1 || midiMsg[1] == 2 || midiMsg[1] == 3 || midiMsg[1] == 4)
                {
                    receivingSysex = 1;

                    // if this is the first chunk, put in the first and second elements (following chunks need this data stripped until the final message gets sent)
                    if (sysexReset == 1)
                    {
                        sysexBuffer[sysexWritePointer++ & sysexPointerMask] = midiMsg[1];
                        sysexBuffer[sysexWritePointer++ & sysexPointerMask] = midiMsg[2];
                        sysexReset = 0;
                    }
                    prevLastBufferBegin[0] = lastBufferBegin[0] ;
                    prevLastBufferBegin[1] = lastBufferBegin[1];
                    lastBufferBegin[0] = masterTimer;
                    lastBufferBegin[1] = midiMsg[1];
                }
            }
            masterTimer++;
        }
        cable = cable; // so it doesn't complain about unused variables
    }
}    




/* [] END OF FILE */
