spiricom/Electrosteel_embedded/Electrosteel_Daisy_Audio/Electrosteel_Daisy_Audio.ioc

Mcu.UserName=STM32H750IBKx
PA0.Signal=GPIO_Output
PA1.Signal=GPIO_Input
PA2.Signal=GPIO_Input
PA3.Signal=GPIO_Output
PA4.Signal=SPI6_NSS
PA5.Signal=SPI6_SCK
PA6.Signal=SPI6_MISO
PA7.Signal=SPI6_MOSI
PB1.Signal=GPIO_Output
PB11.Signal=I2C2_SDA
PB12.Signal=GPXTI12
PB14.Signal=GPIO_Input
PB15.Signal=GPIO_Input
PB5.Signal=SPI1_MOSI
PB6.Signal=GPXTI6
PB7.Signal=GPIO_Output
PB8.Signal=I2C1_SCL
PB9.Signal=I2C1_SDA
PC0.Signal=GPIO_Output
PC1.Signal=GPIO_Output
PC10.Signal=SDMMC1_D2
PC11.Signal=SDMMC1_D3
PC12.Signal=SDMMC1_CK
PC4.Signal=GPIO_Output
PC7.Signal=GPIO_Output
PC8.Signal=SDMMC1_D0
PC9.Signal=SDMMC1_D1
PD0.Signal=FMC_D2_DA2
PD1.Signal=FMC_D3_DA3
PD10.Signal=FMC_D15_DA15
PD11.Signal=GPIO_Output
PD14.Signal=FMC_D0_DA0
PD15.Signal=FMC_D1_DA1
PD2.Signal=SDMMC1_CMD
PD8.Signal=FMC_D13_DA13
PD9.Signal=FMC_D14_DA14
PE0.Signal=FMC_NBL0
PE1.Signal=FMC_NBL1
PE10.Signal=FMC_D7_DA7
PE11.Signal=FMC_D8_DA8
PE12.Signal=FMC_D9_DA9
PE13.Signal=FMC_D10_DA10
PE14.Signal=FMC_D11_DA11
PE15.Signal=FMC_D12_DA12
PE2.Signal=SAI1_MCLK_A
PE3.Signal=SAI1_SD_B
PE4.Signal=SAI1_FS_A
PE5.Signal=SAI1_SCK_A
PE6.Signal=SAI1_SD_A
PE7.Signal=FMC_D4_DA4
PE8.Signal=FMC_D5_DA5
PE9.Signal=FMC_D6_DA6
PF0.Signal=FMC_A0
PF1.Signal=FMC_A1
PF11.Signal=FMC_SDNRAS
PF12.Signal=FMC_A6
PF13.Signal=FMC_A7
PF14.Signal=FMC_A8
PF15.Signal=FMC_A9
PF2.Signal=FMC_A2
PF3.Signal=FMC_A3
PF4.Signal=FMC_A4
PF5.Signal=FMC_A5
PG0.Signal=FMC_A10
PG1.Signal=FMC_A11
PG10.Signal=SPI1_NSS
PG11.Signal=SPI1_SCK
PG15.Signal=FMC_SDNCAS
PG2.Signal=FMC_A12
PG3.Signal=GPXTI3
PG4.Signal=FMC_A14_BA0
PG5.Signal=FMC_A15_BA1
PG8.Signal=FMC_SDCLK
PG9.Signal=GPIO_Output
PH10.Signal=FMC_D18
PH11.Signal=FMC_D19
PH12.Signal=FMC_D20
PH13.Signal=FMC_D21
PH14.Signal=FMC_D22
PH15.Signal=FMC_D23
PH2.Signal=FMC_SDCKE0
PH3.Signal=FMC_SDNE0
PH4.Signal=I2C2_SCL
PH5.Signal=FMC_SDNWE
PH8.Signal=FMC_D16
PH9.Signal=FMC_D17
PI0.Signal=FMC_D24
PI1.Signal=FMC_D25
PI10.Signal=FMC_D31
PI2.Signal=FMC_D26
PI3.Signal=FMC_D27
PI4.Signal=FMC_NBL2
PI5.Signal=FMC_NBL3
PI6.Signal=FMC_D28
PI7.Signal=FMC_D29
PI9.Signal=FMC_D30
