spiricom/Electrosteel_embedded/electrosteel_strings_STM32H730/Core/Src/main.c

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
/* Includes ------------------------------------------------------------------*/
#include "main.h"

/* USER CODE BEGIN Includes */
#include "leaf.h"
/* USER CODE END Includes */

/* USER CODE BEGIN PM */
#define SAMPLE_RATE 48000
/* USER CODE END PM */

ADC_HandleTypeDef hadc1;
DMA_HandleTypeDef hdma_adc1;

RNG_HandleTypeDef hrng;

SPI_HandleTypeDef hspi1;
SPI_HandleTypeDef hspi2;
DMA_HandleTypeDef hdma_spi1_tx;
DMA_HandleTypeDef hdma_spi1_rx;
DMA_HandleTypeDef hdma_spi2_rx;

/* USER CODE BEGIN PV */
uint8_t SPI_TX[8]__ATTR_RAM_D2;
uint8_t SPI_RX[8]__ATTR_RAM_D2;

uint8_t SPI_PLUCK_TX[32]__ATTR_RAM_D2;
uint8_t SPI_PLUCK_RX[32]__ATTR_RAM_D2;

//uint8_t newFirmwareBuffer[65536]__ATTR_RAM_D1;
//uint32_t newFirmwareBufferPosition = 0;


uint8_t counter;
uint16_t ADC_values1[NUM_ADC_CHANNELS * ADC_BUFFER_SIZE]__ATTR_RAM_D2;
//uint16_t ADC_values2[NUM_ADC_CHANNELS * ADC_BUFFER_SIZE]__ATTR_RAM_D2;
#define FILTER_ORDER 2
#define ATODB_TABLE_SIZE 65536
#define ATODB_TABLE_SIZE_MINUS_ONE 65535


#define SMALL_MEM_SIZE 120000
char smallMemory[SMALL_MEM_SIZE];

LEAF leaf;


float atodbTable[ATODB_TABLE_SIZE] __ATTR_RAM_D1;
//tPluckDetectorInt myPluck[NUM_ADC_CHANNELS];
tHighpass opticalHighpass[NUM_STRINGS][FILTER_ORDER];
tVZFilter opticalLowpass[NUM_STRINGS][FILTER_ORDER];
tSlide fastSlide[NUM_STRINGS];
tSlide slowSlide[NUM_STRINGS];
tThreshold threshold[NUM_STRINGS];

//volatile uint_fast8_t gettingNewFirmware = 0;
volatile uint_fast8_t SPI_busy = 0;


uint16_t stringPositions[NUM_STRINGS];
uint16_t stringTouchRH[NUM_STRINGS];
int didPlucked[NUM_STRINGS];
int stringSounding[NUM_STRINGS];

int howManyFrames = 400;
int brokedIt = 0;
int didPlucked2[NUM_STRINGS];
int pluckDelay[NUM_STRINGS];
int pluckValues[NUM_STRINGS];
uint32_t stringStates[NUM_STRINGS];
uint32_t string_values[NUM_STRINGS];
volatile uint32_t changeHappened = 0;

uint32_t timeFrame;
uint32_t frameRate;
uint32_t frameRateStart;

int RHbits[2] = {0,0};

/* USER CODE END PV */

void SystemClock_Config(void);
static void MX_GPIO_Init(void);
static void MX_DMA_Init(void);
static void MX_SPI1_Init(void);
static void MX_SPI2_Init(void);
static void MX_ADC1_Init(void);
static void MX_RNG_Init(void);
/* USER CODE BEGIN 0 */
//void MPU_Conf(void);
float randomNumber(void);
void CycleCounterInit(void);
void MPU_Conf(void);
//void loadNewFirmware(uint32_t);
/* USER CODE END 0 */

/**
  * @brief  The application entry point.
  * @retval int
  */
int main(void)
{
  /* USER CODE BEGIN 1 */
	MPU_Conf();
  /* USER CODE END 1 */

  /* Enable I-Cache---------------------------------------------------------*/
  SCB_EnableICache();

  /* Enable D-Cache---------------------------------------------------------*/
  SCB_EnableDCache();

  /* MCU Configuration--------------------------------------------------------*/

  /* Reset of all peripherals, Initializes the Flash interface and the Systick. */
  HAL_Init();

  /* Configure the system clock */
  SystemClock_Config();

  /* USER CODE BEGIN SysInit */
  CycleCounterInit();
  /* USER CODE END SysInit */

  /* Initialize all configured peripherals */
  MX_GPIO_Init();
  MX_DMA_Init();
  MX_SPI1_Init();
  MX_SPI2_Init();
  MX_ADC1_Init();
  MX_RNG_Init();
  /* USER CODE BEGIN 2 */
  uint32_t tempFPURegisterVal = __get_FPSCR();
   tempFPURegisterVal |= (1<<24); // set the FTZ (flush-to-zero) bit in the FPU control register
   __set_FPSCR(tempFPURegisterVal);

   for (int i = 0; i < 4; i++)
   {
 	  SPI_TX[i] = counter++;
   }

   for (int i = 0; i < 32; i++)
   {
 	  SPI_PLUCK_TX[i] = 0;
 	  SPI_PLUCK_RX[i] = 0;
   }

   HAL_SPI_Receive_DMA(&hspi2, SPI_RX, 8);

   //wait for synth boards to load code from QSPI to SRAM
   HAL_Delay(10);
   //HAL_GPIO_WritePin(GPIOC, GPIO_PIN_6, GPIO_PIN_SET);
   HAL_Delay(10);

   LEAF_init(&leaf, SAMPLE_RATE, smallMemory, SMALL_MEM_SIZE, &randomNumber);

   for (int i = 0; i < NUM_STRINGS; i++)
   {
		tThreshold_init(&threshold[i],700.0f, 1300.0f, &leaf);
		tSlide_init(&fastSlide[i],1.0f,400.0f, &leaf); //1110
		tSlide_init(&slowSlide[i],1.0f,700.0f, &leaf); //1110

		for (int j = 0; j < FILTER_ORDER; j++)
		{
			tVZFilter_init(&opticalLowpass[i][j], Lowpass, 10000.0f, 0.8f, &leaf);//6000
			tHighpass_init(&opticalHighpass[i][j], 10.0f, &leaf);//100
		}
   }



   LEAF_generate_atodb(atodbTable, ATODB_TABLE_SIZE);



   HAL_ADC_Start_DMA(&hadc1,(uint32_t*)&ADC_values1,NUM_ADC_CHANNELS * ADC_BUFFER_SIZE);
   //HAL_ADC_Start_DMA(&hadc2,(uint16_t*)&ADC_values2,NUM_ADC_CHANNELS * ADC_BUFFER_SIZE);
   //HAL_TIM_PWM_Start(&htim3, TIM_CHANNEL_1);




  /* USER CODE END 2 */

  /* Infinite loop */
  /* USER CODE BEGIN WHILE */
   while (1)
   {
		if (changeHappened)
		{
			if (!SPI_busy)// && (!gettingNewFirmware))
			{
				for (int j = 0; j < NUM_STRINGS; ++j)
				{
					SPI_PLUCK_TX[(j * 2) + 1] = (stringStates[j] >> 8);
					SPI_PLUCK_TX[(j * 2) + 2] = (stringStates[j] & 0xff);
				}
				SPI_PLUCK_TX[0] = 254;
				SPI_PLUCK_TX[31] = 253;

				SCB_CleanDCache_by_Addr((uint32_t*)(((uint32_t)SPI_PLUCK_TX) & ~(uint32_t)0x1F), 64);
				HAL_SPI_TransmitReceive_DMA(&hspi1, SPI_PLUCK_TX, SPI_PLUCK_RX, 32);
				changeHappened = 0;
				SPI_busy = 1;
			}
		}
    /* USER CODE END WHILE */

    /* USER CODE BEGIN 3 */
   }
  /* USER CODE END 3 */
}

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
/* USER CODE BEGIN 4 */
/* USER CODE BEGIN 4 */
float randomNumber(void) {

	uint32_t rand;
	HAL_RNG_GenerateRandomNumber(&hrng, &rand);
	float num = (float)rand * INV_TWO_TO_32;
	return num;
}



void MPU_Conf(void)
{
	//code from Keshikan https://github.com/keshikan/STM32H7_DMA_sample
  //Thanks, Keshikan! This solves the issues with accessing the SRAM in the D2 area properly. -JS
	//should test the different possible settings to see what works best while avoiding needing to manually clear the cache -JS

	MPU_Region_InitTypeDef MPU_InitStruct;

	  HAL_MPU_Disable();

	  MPU_InitStruct.Enable = MPU_REGION_ENABLE;

	  //D2 Domain�SRAM1
	  MPU_InitStruct.BaseAddress = 0x30000000;
	  // Increased region size to 256k. In Keshikan's code, this was 512 bytes (that's all that application needed).
	  // Each audio buffer takes up the frame size * 8 (16 bits makes it *2 and stereo makes it *2 and double buffering makes it *2)
	  // So a buffer size for read/write of 4096 would take up 64k = 4096*8 * 2 (read and write).
	  // I increased that to 256k so that there would be room for the ADC knob inputs and other peripherals that might require DMA access.
	  // we have a total of 256k in SRAM1 (128k, 0x30000000-0x30020000) and SRAM2 (128k, 0x30020000-0x3004000) of D2 domain.
	  // There is an SRAM3 in D2 domain as well (32k, 0x30040000-0x3004800) that is currently not mapped by the MPU (memory protection unit) controller.

	  MPU_InitStruct.Size = MPU_REGION_SIZE_32KB;

	  MPU_InitStruct.AccessPermission = MPU_REGION_FULL_ACCESS;

	  //AN4838
	  MPU_InitStruct.TypeExtField = MPU_TEX_LEVEL0;
	  MPU_InitStruct.IsCacheable = MPU_ACCESS_NOT_CACHEABLE;
	  MPU_InitStruct.IsBufferable = MPU_ACCESS_NOT_BUFFERABLE;
	  MPU_InitStruct.IsShareable = MPU_ACCESS_SHAREABLE;

	  //Shared Device
//	  MPU_InitStruct.TypeExtField = MPU_TEX_LEVEL0;
//	  MPU_InitStruct.IsCacheable = MPU_ACCESS_NOT_CACHEABLE;
//	  MPU_InitStruct.IsBufferable = MPU_ACCESS_BUFFERABLE;
//	  MPU_InitStruct.IsShareable = MPU_ACCESS_SHAREABLE;


	  MPU_InitStruct.Number = MPU_REGION_NUMBER0;

	  MPU_InitStruct.SubRegionDisable = 0x00;


	  MPU_InitStruct.DisableExec = MPU_INSTRUCTION_ACCESS_DISABLE;


	  HAL_MPU_ConfigRegion(&MPU_InitStruct);


	  HAL_MPU_Enable(MPU_PRIVILEGED_DEFAULT);
}

float Dsmoothed;
float Dsmoothed2;
float dbSmoothed2;
float dbSmoothedStorage;
int armed[NUM_STRINGS] = {0,0,0,0,0,0,0,0,0,0};
float prevdbSmoothed2[NUM_STRINGS];
int threshOut = 0;
int stringMaxes[NUM_STRINGS] = {0,0,0,0,0,0,0,0,0,0};
int downCounter[NUM_STRINGS];
int armedCounter[NUM_STRINGS];
float slopeStorage[NUM_STRINGS];
float integerVersions[NUM_STRINGS];
int attackDetectPeak2 (int whichString, int tempInt)
{
	float output = -1.0f;
	float tempSamp = (((float)tempInt - TWO_TO_15) * INV_TWO_TO_15);
	for (int k = 0; k < FILTER_ORDER; k++)
	{
		// a highpass filter, remove any slow moving signal (effectively centers the signal around zero and gets rid of the signal that isn't high frequency vibration) cutoff of 100Hz, // applied 8 times to get rid of a lot of low frequency bumbling around
		tempSamp = tHighpass_tick(&opticalHighpass[whichString][k], tempSamp);
		tempSamp = tVZFilter_tick(&opticalLowpass[whichString][k], tempSamp);
	}

	float tempAbs = fabsf(tempSamp);

	Dsmoothed = tSlide_tick(&fastSlide[whichString], tempAbs);
	Dsmoothed2 = tSlide_tick(&slowSlide[whichString], Dsmoothed);
	Dsmoothed2 = LEAF_clip(0.0f, Dsmoothed2, 1.0f);
	//dbSmoothed2 = atodb(Dsmoothed2);
	dbSmoothed2 = LEAF_clip(-39.0f, atodbTable[(uint32_t)(Dsmoothed2 * ATODB_TABLE_SIZE_MINUS_ONE)], 12.0f);//45
	if (whichString == 0)
	{
		dbSmoothedStorage = dbSmoothed2;
	}
	//dbSmoothed2 = LEAF_clip(-50.f, dbSmoothed2, 12.0f);
	//get the slope
	float slope = (dbSmoothed2 - prevdbSmoothed2[whichString]);
	slopeStorage[whichString] = slope;
	float integerVersion = Dsmoothed2 * (TWO_TO_16 - 1);
	integerVersions[whichString] = integerVersion;
	threshOut = tThreshold_tick(&threshold[whichString], integerVersion);

	if ((slope > .5f) && (threshOut > 0))//.3
	{
		armed[whichString] = 1;
	}

	if (armed[whichString] == 1)
	{
		if (integerVersion > stringMaxes[whichString])
		{
			stringMaxes[whichString] = integerVersion;
		}
		armedCounter[whichString]++;

		if (slope <= 0.0f)
		{
			downCounter[whichString]++;
		}
		if (downCounter[whichString] > 164)//was 256
		{
			//found a peak?
			output = stringMaxes[whichString] * 1.75f;
			output = LEAF_clip(0.0f, output, 65535.0f);
			armed[whichString] = 0;
			armedCounter[whichString] = 0;
			downCounter[whichString] = 0;
			stringMaxes[whichString] = 0;
		}
	}

	prevdbSmoothed2[whichString] = dbSmoothed2;
	return (int)output;
}


volatile float CPULoad = 0.0f;

void ADC_Frame(int offset)
{
	//HAL_GPIO_TogglePin(GPIOG, GPIO_PIN_11);
	HAL_GPIO_WritePin(GPIOD, GPIO_PIN_0, GPIO_PIN_SET);
	uint32_t tempCountFrame = DWT->CYCCNT;
	frameRate = DWT->CYCCNT - frameRateStart;
	frameRateStart = DWT->CYCCNT;

	for (int i = offset; i < ADC_FRAME_SIZE + offset; i++)
	{
		//for (int j = 0; j < NUM_ADC_CHANNELS; j++)
		if (howManyFrames > 0)
		{
			howManyFrames--;
		}



		for (int k = 0; k < NUM_STRINGS; k++)
		{
			string_values[k] = ADC_values1[(i*NUM_ADC_CHANNELS) + k];
		}

		for (int j = 0; j < NUM_STRINGS; j++)
		{
			int tempInt = string_values[j];

			if (j < 8)
			{
				stringTouchRH[j] = (RHbits[0] >> j) & 1;
			}
			else
			{
				stringTouchRH[j] = (RHbits[1] >> (j-8)) & 1;
			}
			didPlucked[j] = attackDetectPeak2(j, tempInt);

			if (howManyFrames == 0)
			{
				if ((didPlucked[j] > 0) && (!stringSounding[j]))
				{
					stringStates[j] = (uint16_t)didPlucked[j];
					pluckValues[j] = didPlucked[j];
					changeHappened = 1;
					stringSounding[j] = 1;
				}

				if ((stringTouchRH[j]) && (stringSounding[j]))
				{

					stringStates[j] = 0;
					pluckValues[j] = 0;
					changeHappened = 1;
					stringSounding[j] = 0;
				}


			}
		}
	}
	HAL_GPIO_WritePin(GPIOD, GPIO_PIN_0, GPIO_PIN_RESET);

	timeFrame = DWT->CYCCNT - tempCountFrame;
	CPULoad = (float)timeFrame / (float)frameRate;

}
void HAL_ADC_ConvCpltCallback(ADC_HandleTypeDef *hadc)
{
	ADC_Frame(ADC_FRAME_SIZE);
}
void HAL_ADC_ConvHalfCpltCallback(ADC_HandleTypeDef *hadc)
{
	ADC_Frame(0);
}
void HAL_ADC_Error(ADC_HandleTypeDef *hadc)
{
	;
}

//volatile uint32_t mySize  = 0;
//void loadNewFirmware(uint32_t size)
//{
//	mySize = size;
//}

void HAL_SPI_TxRxCpltCallback(SPI_HandleTypeDef *hspi)
{
	SPI_busy = 0;
}

volatile int numResets = 0;

void HAL_SPI_RxCpltCallback(SPI_HandleTypeDef *hspi)
{
	HAL_GPIO_WritePin(GPIOB, GPIO_PIN_4, GPIO_PIN_RESET);
	if ((SPI_RX[6] == 254) && (SPI_RX[7] == 253))
	{
		for (int i = 0; i < 2; i++)
		{
			RHbits[i] = SPI_RX[i+4];
		}
	}
	else
	{
		HAL_SPI_Abort(&hspi2);
		__HAL_RCC_SPI2_FORCE_RESET();
		__HAL_RCC_SPI2_RELEASE_RESET();
		MX_SPI2_Init();
		__HAL_SPI_ENABLE(&hspi2);
		HAL_SPI_Receive_DMA(&hspi2, SPI_RX, 8);
		numResets++;
	}
}

void HAL_SPI_RxHalfCpltCallback(SPI_HandleTypeDef *hspi)
{
	HAL_GPIO_WritePin(GPIOB, GPIO_PIN_4, GPIO_PIN_SET);
	if ((SPI_RX[2] == 254) && (SPI_RX[3] == 253))
	{
		for (int i = 0; i < 2; i++)
		{
			RHbits[i] = SPI_RX[i];
		}
	}
	else
	{
		HAL_SPI_Abort(&hspi2);
		__HAL_RCC_SPI2_FORCE_RESET();
		__HAL_RCC_SPI2_RELEASE_RESET();
		MX_SPI2_Init();
		__HAL_SPI_ENABLE(&hspi2);
		HAL_SPI_Receive_DMA(&hspi2, SPI_RX, 8);
		numResets++;
	}
}

// helper function to initialize measuring unit (cycle counter) */
void CycleCounterInit( void )
{
  /* Enable TRC */
  CoreDebug->DEMCR |= CoreDebug_DEMCR_TRCENA_Msk;

  /* Unlock DWT registers */
  if ((*(uint32_t*)0xE0001FB4) & 1)
    *(uint32_t*)0xE0001FB0 = 0xC5ACCE55;

  /* clear the cycle counter */
  DWT->CYCCNT = 0;

  /* start the cycle counter */
  DWT->CTRL = 0x40000001;

}
/* USER CODE END 4 */
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
