spiricom/Electrosteel_embedded/PSOC5_electrosteel_stringsensors_newpcbtryingglitchdetect/CE210514_PSOC3_5_Thermistor.cydsn/main.c

/*****************************************************************************
* File Name: main.c
*
* Version: 3.0
*
* Description:
*   
* 
* Note:
* 	The main project includes the ADC and other components required for the
*   temperature measurement. The Thermistor component is a complete firmware component
*   as decribed in the component datahseet and application note
******************************************************************************
* Copyright (C) 2015, Cypress Semiconductor Corporation.
******************************************************************************
* This software is owned by Cypress Semiconductor Corporation (Cypress) and is
* protected by and subject to worldwide patent protection (United States and
* foreign), United States copyright laws and international treaty provisions.
* Cypress hereby grants to licensee a personal, non-exclusive, non-transferable
* license to copy, use, modify, create derivative works of, and compile the
* Cypress Source Code and derivative works for the sole purpose of creating
* custom software in support of licensee product to be used only in conjunction
* with a Cypress integrated circuit as specified in the applicable agreement.
* Any reproduction, modification, translation, compilation, or representation of
* this software except as specified above is prohibited without the express
* written permission of Cypress.
*
* Disclaimer: CYPRESS MAKES NO WARRANTY OF ANY KIND, EXPRESS OR IMPLIED, WITH
* REGARD TO THIS MATERIAL, INCLUDING, BUT NOT LIMITED TO, THE IMPLIED
* WARRANTIES OF MERCHANTABILITY AND FITNESS FOR A PARTICULAR PURPOSE.
* Cypress reserves the right to make changes without further notice to the
* materials described herein. Cypress does not assume any liability arising out
* of the application or use of any product or circuit described herein. Cypress
* does not authorize its products for use as critical components in life-support
* systems where a malfunction or failure may reasonably be expected to result in
* significant injury to the user. The inclusion of Cypress' product in a life-
* support systems application implies that the manufacturer assumes all risk of
* such use and in doing so indemnifies Cypress against all charges. Use may be
* limited by and subject to the applicable Cypress software license agreement.
*****************************************************************************/
#include <device.h>
#include "removeOffsetNoise.h"
#include "measurement.h"
#include <stdio.h>

#define barBufferSize 8
#define touchBufferSize 4



uint8_t stringCapSensorsOnOff[1];
uint8_t stringCapSensorsRaw[16];
uint8_t thresholdArray[12] = {15, 15, 15, 15, 15, 15, 15, 15, 15, 15, 15, 15};
uint8 barArray[barBufferSize];
uint8 touchArray[touchBufferSize];
int32_t linearPotValue32Bit[2];
uint8_t i = 0;
uint8_t counter = 0;
int32_t temper;
void scanLinearResistor(uint8_t channel);


CY_ISR(button_press_ISR) {     /* No need to clear any interrupt source; interrupt component should be      * configured for RISING_EDGE mode.      */     /* Read the debouncer status reg just to clear it, no need to check its      * contents in this application.      */  
 //FiltReg_Read(); 
    //
}

uint16_t ADC_values[12];

int main(void)
{
    
	char printBuf[16]={'\0'};


	CYGlobalIntEnable; 
    IDAC8_1_Start();
    IDAC8_2_Start();
	ADC_1_Start();
	AMux_1_Start();
    AMux_2_Start();
    AMux_3_Start();
    ADC_SAR_Seq_1_Start();

    SPIM_1_Start();
    SPIM_2_Start();
    
    CyDelay(500);
    CapSense_Start();     
    
    CyDelay(500);
    CapSense_InitializeAllBaselines();
    uint8_t myArrayCounter = 0;
    
    CapSense_ScanEnabledWidgets();  


	for(;;)
    {
        CapSense_ClearSensors();
        
        for (i = 0; i < 2; i++)
        {
           scanLinearResistor(i);
        }


        uint8_t byteCounter = 0;

        CapSense_UpdateEnabledBaselines();
        CapSense_ScanEnabledWidgets();  
        
        int isSensorOn1 = (CapSense_sensorRaw[9] - CapSense_sensorBaseline[9]) > thresholdArray[9];
        if (isSensorOn1)
        {
            //LED_Write(1);
        }
        else
        {
           // LED_Write(0);
        }

        counter = 0;
        
        for (i = 0; i < 2; i++)
        {
            barArray[counter++] = ((uint16_t) linearPotValue32Bit[i]) >> 8;
            barArray[counter++] = ((uint16_t) linearPotValue32Bit[i]) & 0xff;
        }



        barArray[4] = 0;
        barArray[5] = 0;
        barArray[6] = 254;
        barArray[7] = 253;
        
        touchArray[0] = 0;
        touchArray[1] = 0;
        touchArray[2] = 254;
        touchArray[3] = 253;

        
        while(CapSense_IsBusy() != 0)  
        {
            ;//wait until scan is complete
        }  
        for (i = 0; i < 8; i++)
        {
           int isSensorOn = (CapSense_sensorRaw[i] - CapSense_sensorBaseline[i]) > thresholdArray[i];
            touchArray[0] |= (isSensorOn << i);
            barArray[4] |= (isSensorOn << i);

        }
        for (i = 8; i < 10; i++)
        {
           int isSensorOn = (CapSense_sensorRaw[i] - CapSense_sensorBaseline[i]) > thresholdArray[i];
            touchArray[1] |= (isSensorOn << (i - 8));
            barArray[5] |= (isSensorOn << (i - 8));
        }        
        
        //send data over SPI to pluck detector boards
         for (int i = 0; i < touchBufferSize; i++)
        {         

            SPIM_1_WriteTxData(touchArray[i]);

        }
        
        //send data over SPI to brain and synth boards
         for (int i = 0; i < barBufferSize; i++)
        {         
            SPIM_2_WriteTxData(barArray[i]);
        }
    }
}
float resistorRatio[2];
int8_t currentPast = 0;
int32_t resistorPast[30][3];
int32_t pastValueMain[2];
int32_t pastValueOtherSide[2];

void scanLinearResistor(uint8_t channel)
{  
        int32 iVtherm = 0;
        int32 iVref = 0;
        int32 iRes = 0;
        int32 offset = 0;
       // IDAC8_2_Stop();
       // IDAC8_1_Start();
        //connect the iout pin to the correct resistor channel
        AMux_2_FastSelect(channel);
    
        //select the wiper pins
        AMux_1_FastSelect(channel * 2);
        CyDelayUs(500); 

       
        ADC_1_StartConvert();
        ADC_1_IsEndConversion(ADC_1_WAIT_FOR_RESULT);
        iVtherm = ADC_1_GetResult32();
        AMux_1_FastSelect((channel * 2) + 1);
        CyDelayUs(500); 
        ADC_1_StartConvert();
        ADC_1_IsEndConversion(ADC_1_WAIT_FOR_RESULT);
        iVref = ADC_1_GetResult32();
        
        //IDAC8_1_Stop();
        //IDAC8_2_Start();
        AMux_1_Disconnect(channel);
        AMux_2_Disconnect(channel);
        
        //iRes = Thermistor_GetResistance(iVtherm, iVref); //check if more efficient than my version
        if ((iVref > 100) && (iVtherm < 100))
        {
            iRes = 65535;
        }
        else
        {          
            resistorRatio[channel] = ((float)iVref / (float)iVtherm);
            iRes = (int32)(((float)iVref / (float)iVtherm) * 32000.0f);
        }
        if (iRes < 0)
        {
            iRes = 0;
        }
        if (iRes > 65535)
        {
            iRes = 65535;
        }

        uint32_t up = 0;
        if (iRes > (pastValueMain[channel] + 100))
        {
            up++;
        }

        AMux_3_FastSelect(channel);  
        CyDelayUs(500); 
        ADC_SAR_Seq_1_StartConvert();
        ADC_SAR_Seq_1_IsEndConversion(ADC_SAR_Seq_1_WAIT_FOR_RESULT);
        int32_t result = ADC_SAR_Seq_1_GetResult16(channel);
        AMux_3_Disconnect(channel); 
        if (result > (pastValueOtherSide[channel] + 20))
        {
            up++;
        }
        
        if (up < 2)
        {
            linearPotValue32Bit[channel] = iRes;
            LED_Write(0);
        }
        else
        {
            LED_Write(1);
        }
        pastValueMain[channel] = iRes;
        pastValueOtherSide[channel] = result;
}


/* [] END OF FILE */
