spiricom/Electrosteel_embedded/PSOC5_electrosteel_stringsensors_newpcb_brain/CE210514_PSOC3_5_Thermistor.cydsn/codegentemp/encoder_button_aliases.h

/*******************************************************************************
* File Name: encoder_button.h  
* Version 2.20
*
* Description:
*  This file contains the Alias definitions for Per-Pin APIs in cypins.h. 
*  Information on using these APIs can be found in the System Reference Guide.
*
* Note:
*
********************************************************************************
* Copyright 2008-2015, Cypress Semiconductor Corporation.  All rights reserved.
* You may use this file only in accordance with the license, terms, conditions, 
* disclaimers, and limitations in the end user license agreement accompanying 
* the software package with which this file was provided.
*******************************************************************************/

#if !defined(CY_PINS_encoder_button_ALIASES_H) /* Pins encoder_button_ALIASES_H */
#define CY_PINS_encoder_button_ALIASES_H

#include "cytypes.h"
#include "cyfitter.h"


/***************************************
*              Constants        
***************************************/
#define encoder_button_0			(encoder_button__0__PC)
#define encoder_button_0_INTR	((uint16)((uint16)0x0001u << encoder_button__0__SHIFT))

#define encoder_button_INTR_ALL	 ((uint16)(encoder_button_0_INTR))

#endif /* End Pins encoder_button_ALIASES_H */


/* [] END OF FILE */
