spiricom/Electrosteel_embedded/PSOC5_electrosteel_stringsensors_newpcb_brain/CE210514_PSOC3_5_Thermistor.cydsn/oled.c

/*
 * oled.c
 *
 *  Created on: Feb 05, 2020
 *      Author: Matthew Wang
 */


#include "ssd1306.h"
#include "oled.h"

#include "gfx.h"
#include "custom_fonts.h"




GFX theGFX;
char oled_buffer[32];


void myGFX_init(int width, int height)
{
    
	  //initialize the graphics library that lets us write things in that display buffer
	  GFXinit(&theGFX, width, height);

	  //set up the monospaced font

	  //GFXsetFont(&theGFX, &C649pt7b); //funny c64 text monospaced but very large
	  //GFXsetFont(&theGFX, &DINAlternateBold9pt7b); //very serious and looks good - definitely not monospaced can fit 9 Ms
	  //GFXsetFont(&theGFX, &DINCondensedBold9pt7b); // very condensed and looks good - definitely not monospaced can fit 9 Ms
	  //GFXsetFont(&theGFX, &EuphemiaCAS7pt7b); //this one is elegant but definitely not monospaced can fit 9 Ms
	  //GFXsetFont(&theGFX, &GillSans9pt7b); //not monospaced can fit 9 Ms
	  //GFXsetFont(&theGFX, &Futura9pt7b); //not monospaced can fit only 7 Ms
	  //GFXsetFont(&theGFX, &FUTRFW8pt7b); // monospaced, pretty, (my old score font) fits 8 Ms
	  //GFXsetFont(&theGFX, &nk57_monospace_cd_rg9pt7b); //fits 12 characters, a little crammed
	  //GFXsetFont(&theGFX, &nk57_monospace_no_rg9pt7b); // fits 10 characters
	  //GFXsetFont(&theGFX, &nk57_monospace_no_rg7pt7b); // fits 12 characters
	  //GFXsetFont(&theGFX, &nk57_monospace_no_bd7pt7b); //fits 12 characters
	  //GFXsetFont(&theGFX, &nk57_monospace_cd_rg7pt7b); //fits 18 characters
      GFXsetFont(&theGFX,&Inconsolata10pt7b);
	  GFXsetTextColor(&theGFX, 1, 0);
	  GFXsetTextSize(&theGFX, 1);
}

void myGFX_setFont(int font)
{
    if (font == 0)
    {
        GFXsetFont(&theGFX,&Inconsolata10pt7b);
    }
    else if (font == 1)
    {
         GFXsetFont(&theGFX,&Inconsolata13pt7b);
    }
    else if (font == 2)
    {
         GFXsetFont(&theGFX,&Inconsolata8pt7b);
    }
}
        
void OLED_init(uint16_t width, uint16_t height)
{

	  //start up that OLED display
	  ssd1306_begin(SSD1306_SWITCHCAPVCC, width, height);

    
	  //HAL_Delay(5);

	  //clear the OLED display buffer
	  for (int i = 0; i < 1024; i++)
	  {
		  buffer[i] = 0;
	  }
}





int getCursorX()
{
	return GFXgetCursorX(&theGFX);
}


void OLED_writePreset()
{
	//GFXsetFont(&theGFX, &C645pt7b);
	//OLEDclear();
	//char tempString[24];
	//itoa((currentPreset+1), tempString, 10);
	//strcat(tempString, ":");
	//strcat(tempString, modeNames[currentPreset]);
	//int myLength = (int)strlen(tempString);
	//OLEDwriteInt(0, 2, 0, FirstLine);
	//OLEDwriteString(":", 1, 20, FirstLine);
	//OLEDwriteString("ELECTROSTEEL", 12, 0, SecondLine);
    //OLEDwriteString("4-EVA", 5, 0, SecondLine);
        //OLEDwriteString("AHHHHH", 6, 0, ThirdLine);
            //OLEDwriteString("HOOORAY!!!!", 11, 0, FourthLine);
	//OLEDwriteString(tempString, myLength, 0, FirstLine);
	//GFXsetFont(&theGFX, &EuphemiaCAS7pt7b);
	//OLEDwriteString(modeNamesDetails[currentPreset], (int)strlen(modeNamesDetails[currentPreset]), 0, SecondLine);
	//save new preset to flash memory
}
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
