spiricom/Electrosteel_embedded/(commit log)

2022-12-08 adding psoc code
    [CE210514_PSOC3_5_Thermistor.sdf]
2022-12-08 added string pluck sensor code
2022-12-08 added EAGLE files
    [Other.gbr, carbon_ink_top.gbr, copper_bottom.gbr, copper_bottom_l4.gbr, copper_inner_l2.gbr, copper_inner_l3.gbr, copper_top.gbr, copper_top_l1.gbr]
2022-12-08 added new fretboard to psoc code'
    [CE210514_PSOC3_5_Thermistor.sdf]
2022-12-14 new string touch sensor pcb code
    [CE210514_PSOC3_5_Thermistor.sdf]
2022-12-31 new version of psoc code that uses current dac and lower res slider
    [CE210514_PSOC3_5_Thermistor.sdf]
2023-01-03 working electrosteel, doesnt take in new patches but reads electrobass patches off sdcard
    [electrosteel2021_synthboards1.brd, electrosteel2021_synthboards1.sch]
2023-01-05 new brain sending format, brain now takes copedents from plugin and stores them in one of 7 slots on the brain
    [CE210514_PSOC3_5_Thermistor.sdf]
2023-01-06 current code loads presets
2023-01-08 working electrosteel psoc code. added code to skip unconnected pedals and lever in the i2c communication. also added calibration mode to set the min and max of the levers
    [CE210514_PSOC3_5_Thermistor.sdf]
2023-01-08 fixed storage of copedents and calibration data so that it doesn't overlap
    [main.c]
2023-01-09 macro knobs sensing correctly, and sped things up by commenting out midi computation of pitch bend for computer communication. Will need to put that back in once the plugin can handle it
    [CE210514_PSOC3_5_Thermistor.sdf]
2023-01-09 knob displays working
    [CE210514_PSOC3_5_Thermistor.sdf]
2023-01-09 improved the bar sensing psoc code by increasing the range of the adc, decreasing the resolution of the adc for speed reasons, and boosting the idac current slightly to fill the increased range
    [CE210514_PSOC3_5_Thermistor.sdf]
2023-01-17 eagle files for rev5 synthboard finished
    [electrosteel2020_10_arrange6_synthboardsonlyrev5.brd, electrosteel2020_10_arrange6_synthboardsonlyrev5.sch, electrosteel2020_10_arrange6_synthboardsonlyrev5_BOM.csv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]
2023-04-26 started daisy version of audio boards for electrosteel
    [Electrosteel_Daisy_Audio.cfg, Electrosteel_Daisy_Bootloader.cfg, electrosteel2020_10_arrange6.brd]
2023-04-29 got one new synthboard working, doesnt yet send firmware over i2c to other boards
    [electrosteel2020_10_arrange6.sch]
2023-05-07 working on daisy port. one board works but subsequent voices still dont always wake up at startup
2023-05-11 trying daisy pc
    [CE210514_PSOC3_5_Thermistor.sdf]
2023-05-21 working code for electrosteel using daisy. problem was mpu settings and not waiting for qspi init before writing firmware update
    [Electrosteel_Daisy_Audio.ioc, Electrosteel_Daisy_Bootloader.ioc, Electrosteel_audio.ioc, main.c]
2023-05-22 working daisy electrosteel, tested with all 6 boards at once. works smoothly on many presets but fails on some presets that genera version could handle. need to explore why
    [Electrosteel_Daisy_Audio.ioc, main.c, main.h]
2023-05-22 cache invalidate seems to solve issues
    [main.c]
2023-05-25 changed pluck detection stm32 to be more sensitive for electromagnetic pickup. works great!;
2023-05-28 pedal mappings working in synth presets, and fixed a pluck scaling issue
    [main.c, parameters.h]
2023-07-19 added capability to stream data from computer for realtime parameter changes
    [electrosteel2020_10_arrange6_newstringconnector.brd, electrosteel2020_10_arrange6_newstringconnector.sch, electrosteel2020_10_arrange6_newstringconnector_2 (v9~recovered).dxf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]
2023-08-04 includes bootloader
    [CE210514_PSOC3_5_Thermistor.sdf, bootloader_electrosteel_PSOC.sdf]
2023-08-05 changed font, added name size limits, fixed macro knob midi sending
    [CE210514_PSOC3_5_Thermistor.sdf]
2023-08-07 many changes with close to a working menu system, and changes to slider resolution of the bar
    [CE210514_PSOC3_5_Thermistor.sdf]
2023-08-08 added working transpose feature, although it doesnt yet send to the synthesis
    [CE210514_PSOC3_5_Thermistor.sdf]
2023-08-09 fixed volume bug on every other string, and did some cleanup;
    [Electrosteel_Daisy_Audio.ioc, Electrosteel_Daisy_Bootloader.ioc, main.c, main.h, parameters.h]
2023-08-12 added knob freezing (untested) and corrected harmonic number calculation in stm32 code
    [main.c, parameters.h]
2023-08-12 fixed octave midi send bug, and other things
    [main.c, main.h, ui.c, ui.h]
2023-09-16 changed pluck communication to 32 bytes to align to cache size and avoid alignment errors. Finished writing code to allow pluck firmware update from synth board, but then realized that the pluck IC c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
    [Electrosteel_Daisy_Audio.ioc, Electrosteel_Daisy_Bootloader.ioc, electrosteel_strings_STM32H730.ioc, main.c, main.h, parameters.h]
2023-10-17 changed priorities of spi and adc dma controllers in pluck mcu
    [electrosteel2020_10_arrange6_synthboardsonlyrev6.dxf]
2024-01-03 added string model with dispersion, tension, phantom harmonics, and rudimentary bar slide noise
    [Electrosteel_Daisy_Audio (1).cfg, Electrosteel_audio Debug.cfg]
2024-01-10 good version of tTString and ready to test moving it to the Daisy board
2024-01-10 just changed CMSIS DSP library in daisy board
2024-01-14 vocal improved, string good
    [electrosteel2020_10_arrange7_synthboardsonlyrev6.brd, electrosteel2020_10_arrange7_synthboardsonlyrev6.sch]
2024-01-15 added Cypress brain sending local preset storage data
    [CE210514_PSOC3_5_Thermistor.sdf]
2024-01-16 fixed ability to store locally normal synth presets
    [main.c]
2024-01-18 preset storage stuff
    [CE210514_PSOC3_5_Thermistor.sdf]
2024-01-22 many small fixes and replaced CMSIS DSP oversampling with my custom one because it was messing up he gain
    [main.c]
2024-02-05 changed volume pedal curve, fixed vocal nan, and in the middle of transferring to bootloader version
    [main.c, main.h]
2024-02-06 shipped version 1, added internal naming of presets in sd card write, transferred to daisy board
2024-02-12 many small fixes including storing preset bug and frozen knob bug
    [main.c]
2024-02-12 fixed many small bugs including knobFrozen bug and initialization knob settings bug
    [CE210514_PSOC3_5_Thermistor.sdf]
2024-02-19 improved filters, and made hardware and software more similar, added transpose ability
2024-04-15 fixed copedent receive bug and added firmware version reporting
    [CE210514_PSOC3_5_Thermistor.sdf]
2025-04-24 current state
2026-05-23 updated to have 24/48 bend range, but broke note ons
    [CE210514_PSOC3_5_Thermistor.sdf]
