spiricom/Electrosteel_embedded/(notices)

Notices in the files:
electrosteel_strings_STM32H730/Core/Src/main.c:
Copyright (c) 2022 STMicroelectronics.
All rights reserved.
This software is licensed under terms that can be found in the LICENSE file
Electrosteel_Daisy_Audio/Core/Src/main.c:
© Copyright (c) 2020 STMicroelectronics.
This software component is licensed by ST under Ultimate Liberty license
parts and their libraries:
SparkFun-Sensors: Licensing: Creative Commons ShareAlike 4.0 International - https://creativecommons.org/licenses/by-sa/4.0
PatternAgents-Beautify: License : http://creativecommons.org/licenses/by-sa/3.0
(Creative Commons 3.0)
con-headers-jp: Copyright (C) 2008, Bob Starr
